GlobalSequence/iosefka/_documentation/docs/assets/cb_2_sockets.webp

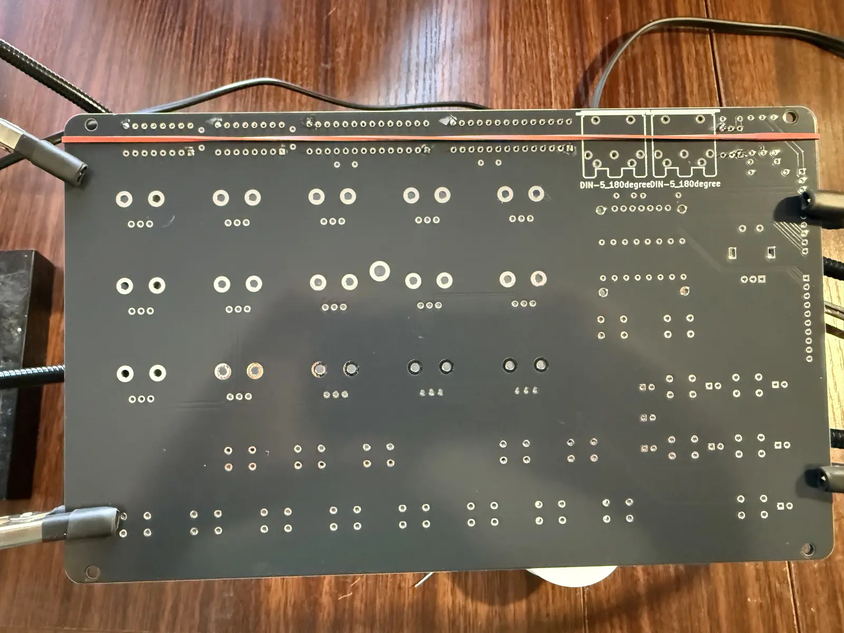
_documentation/docs/assets/cb_2_sockets.webp
