GlobalSequence/iosefka/_documentation/docs/assets/cb_12_chipped.webp

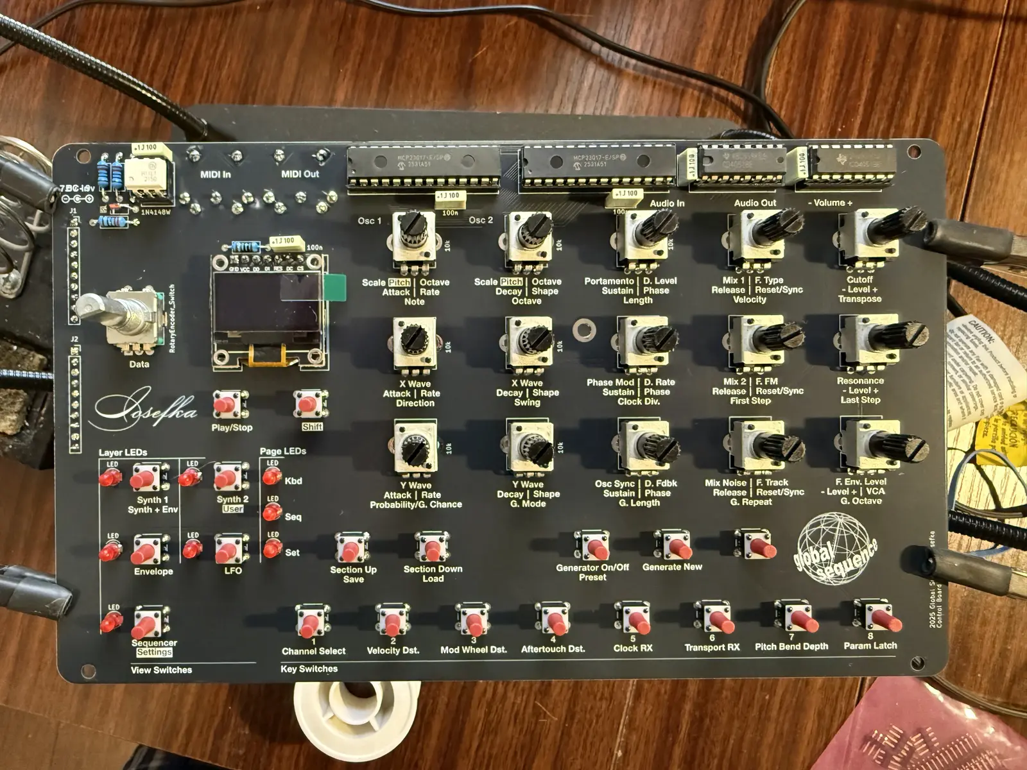
_documentation/docs/assets/cb_12_chipped.webp
