GlobalSequence/iosefka/_documentation/docs/assets/IMG_2130.webp

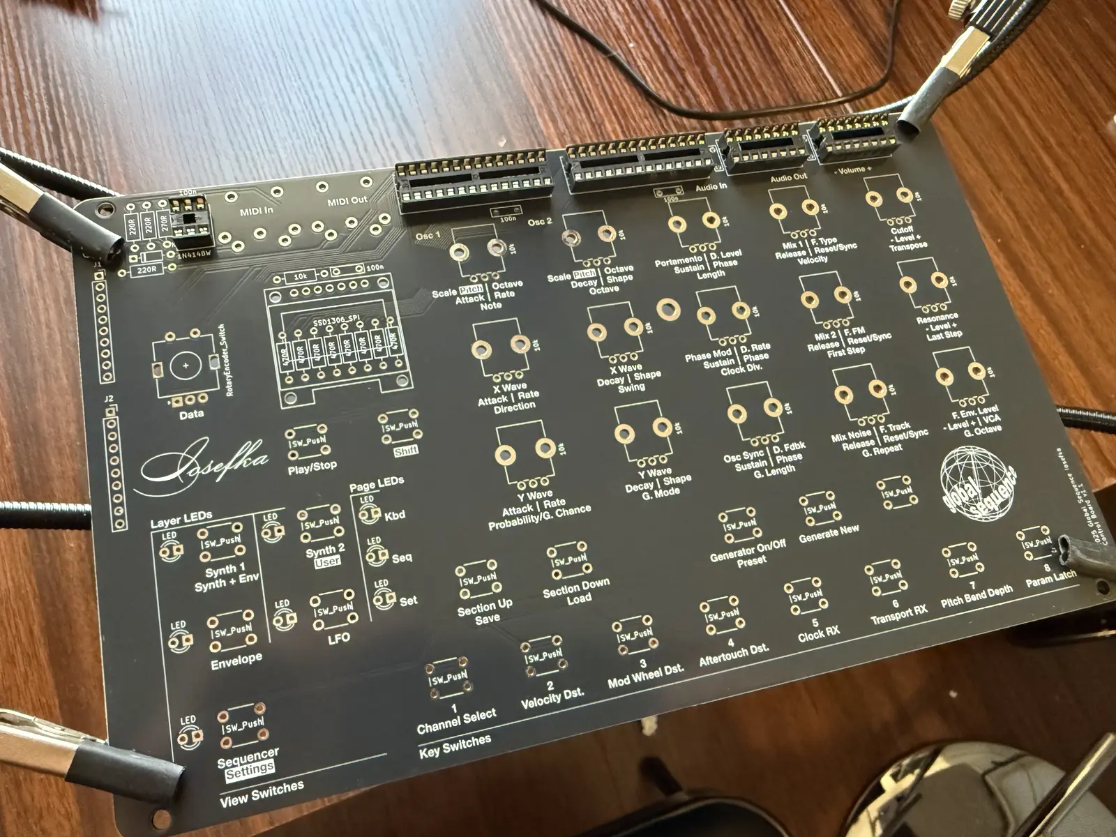
_documentation/docs/assets/IMG_2130.webp
