GlobalSequence/iosefka/_documentation/docs/assets/IMG_2135.webp

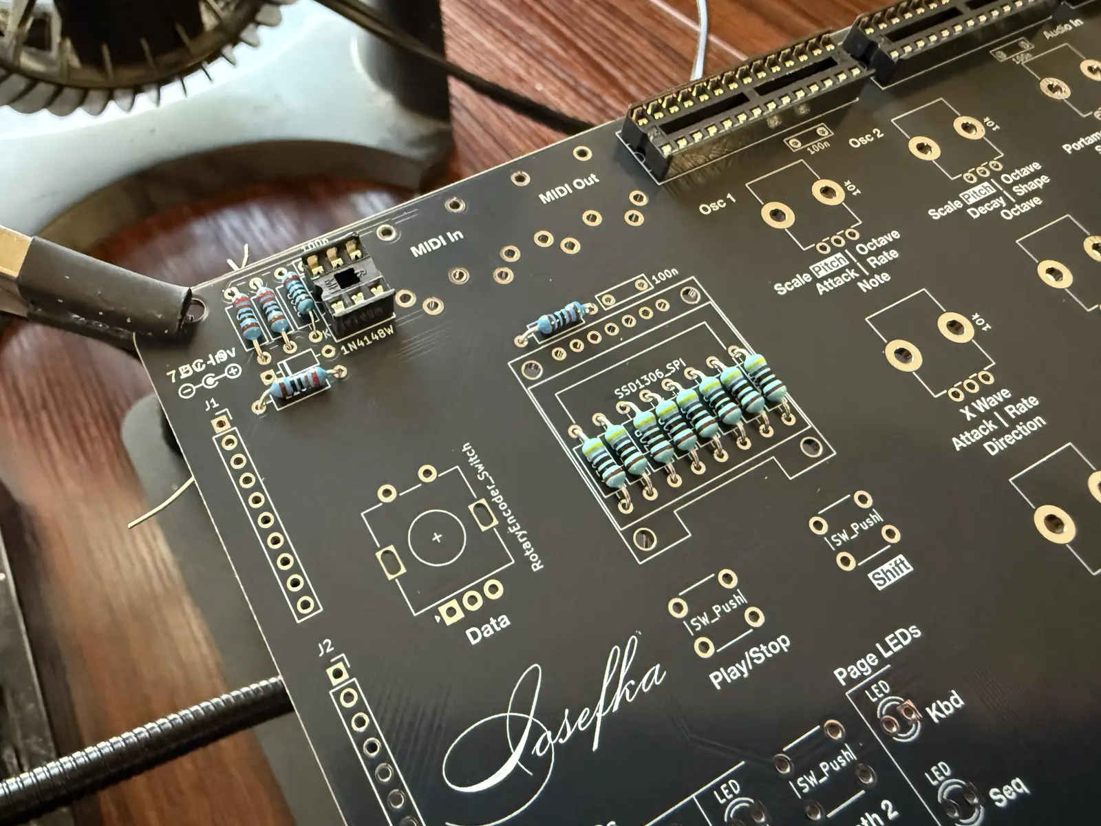
_documentation/docs/assets/IMG_2135.webp
