GlobalSequence/iosefka/_documentation/docs/assets/IMG_2136.webp

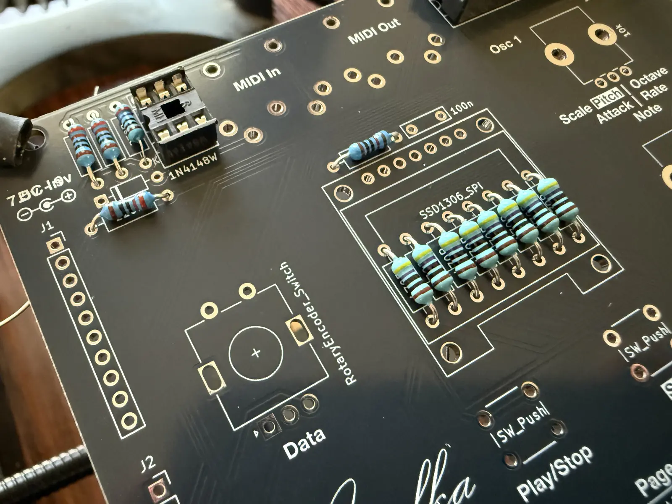
_documentation/docs/assets/IMG_2136.webp
