GlobalSequence/iosefka/_documentation/docs/assets/IMG_2137.webp

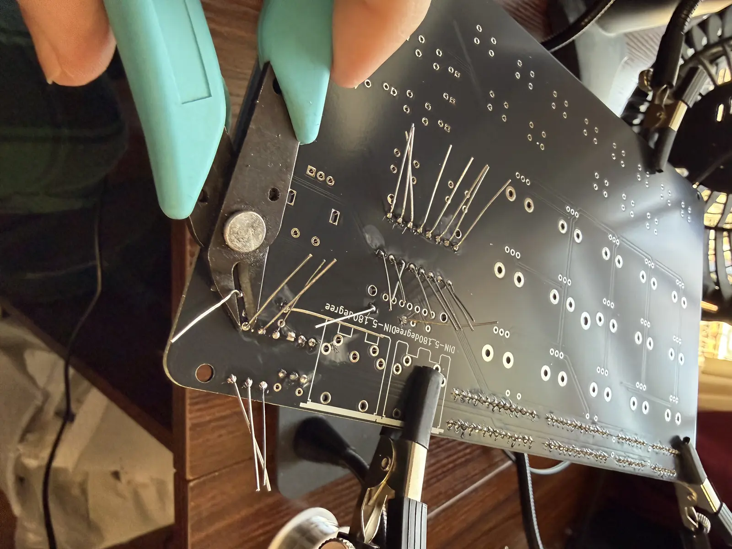
_documentation/docs/assets/IMG_2137.webp
