GlobalSequence/iosefka/_documentation/docs/assets/IMG_2138.webp

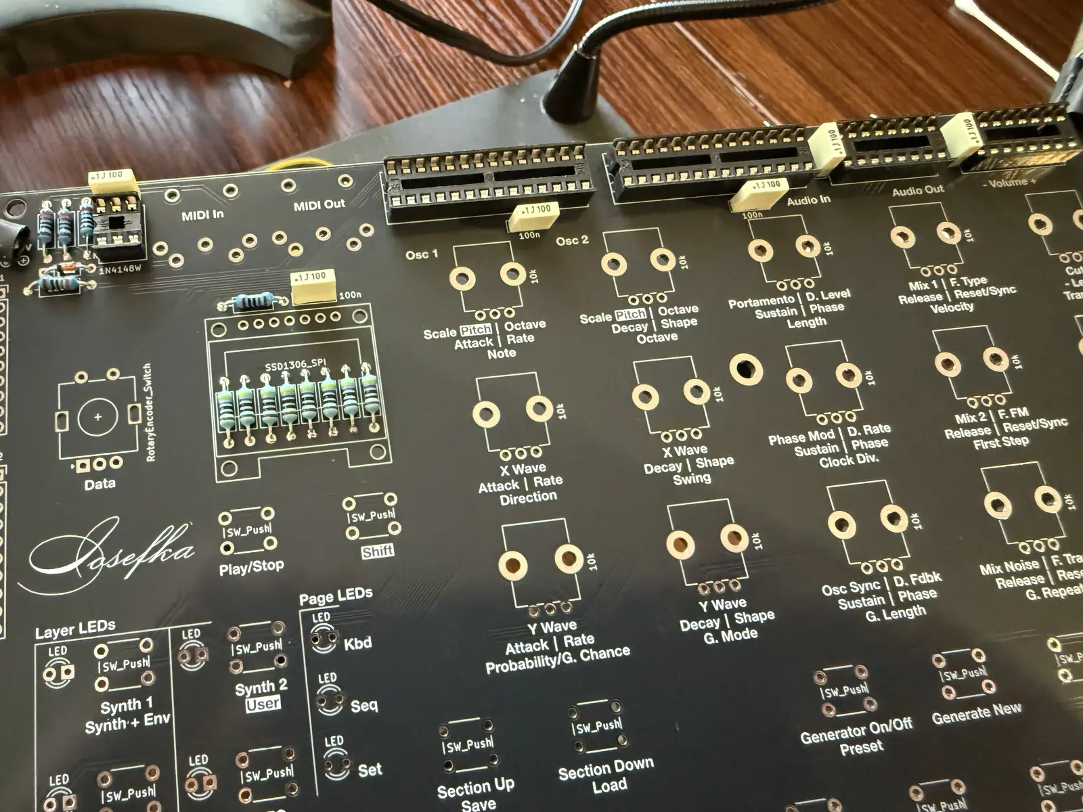
_documentation/docs/assets/IMG_2138.webp
