GlobalSequence/iosefka/_documentation/docs/assets/IMG_2141.webp

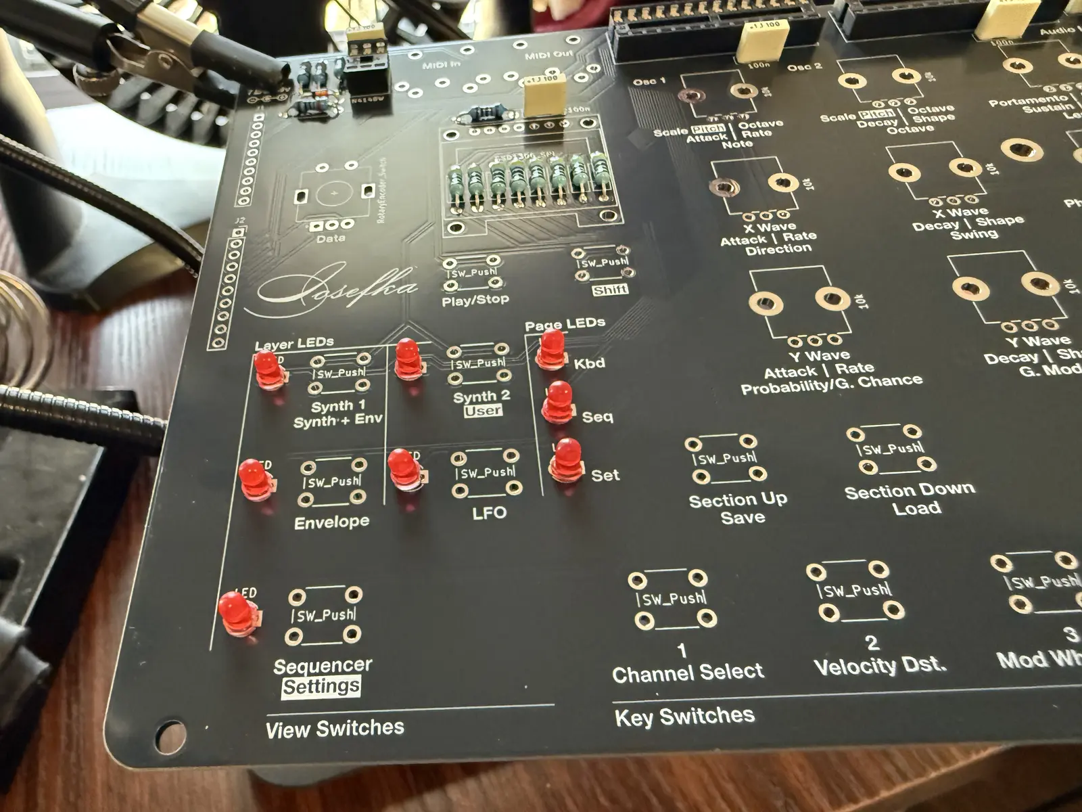
_documentation/docs/assets/IMG_2141.webp
