GlobalSequence/iosefka/_documentation/docs/assets/IMG_2142.webp

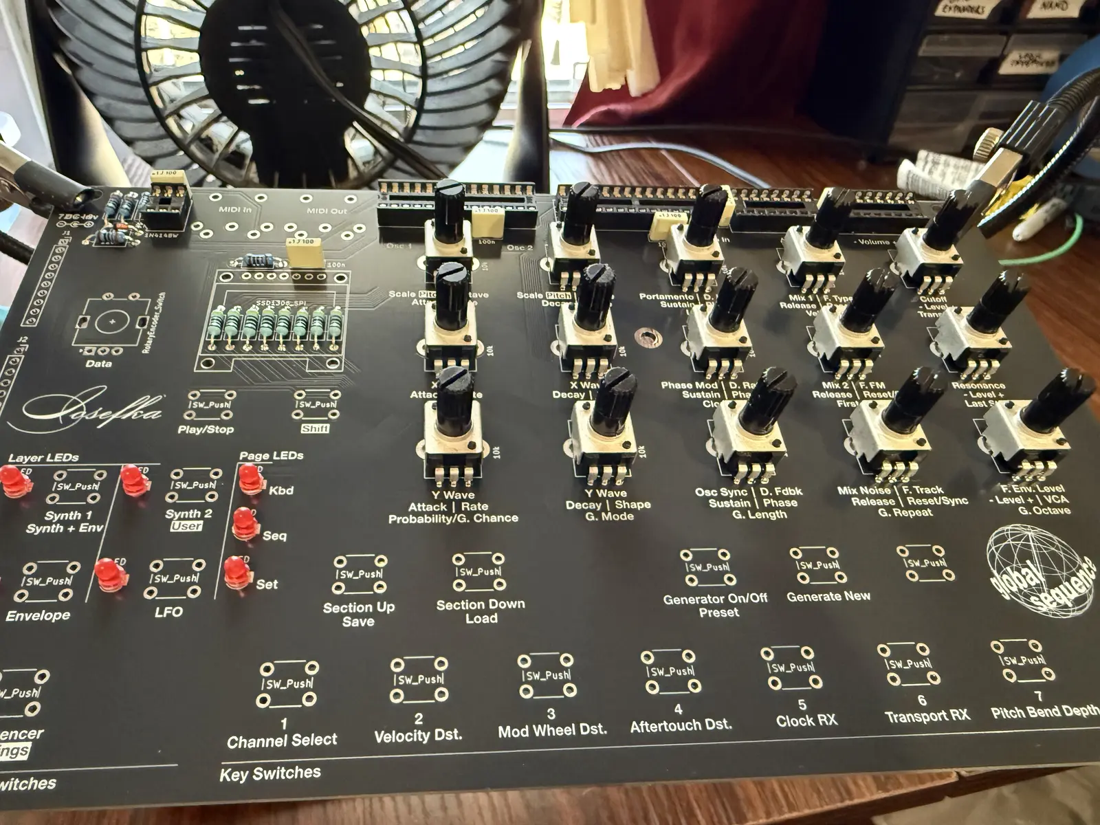
_documentation/docs/assets/IMG_2142.webp
