GlobalSequence/iosefka/_documentation/docs/assets/IMG_2143.webp

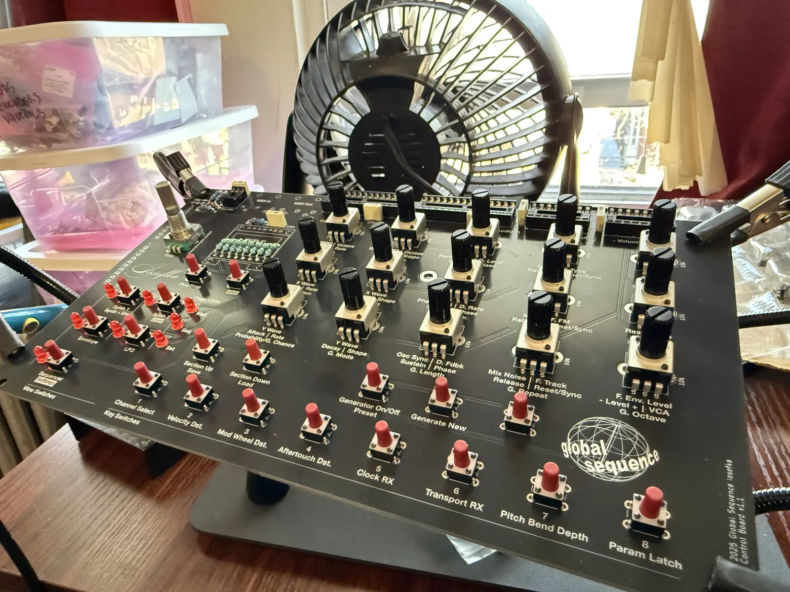
_documentation/docs/assets/IMG_2143.webp
