GlobalSequence/iosefka/_documentation/docs/assets/IMG_2144.webp

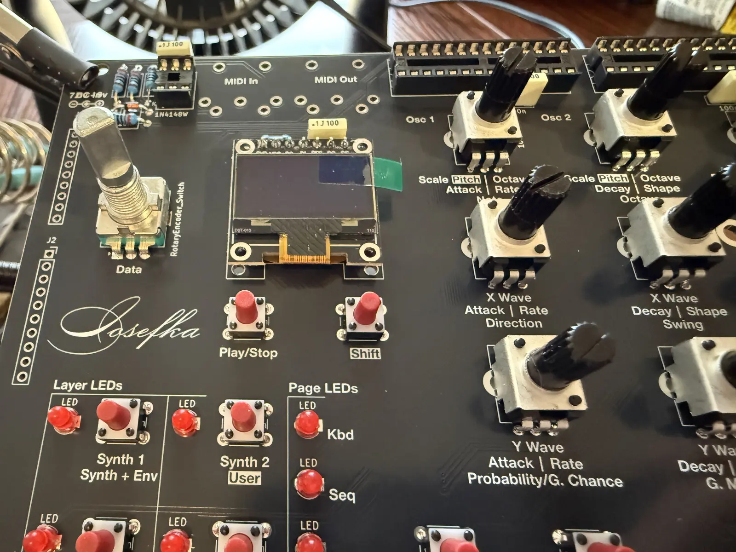
_documentation/docs/assets/IMG_2144.webp
