GlobalSequence/iosefka/_documentation/docs/assets/IMG_2145.webp

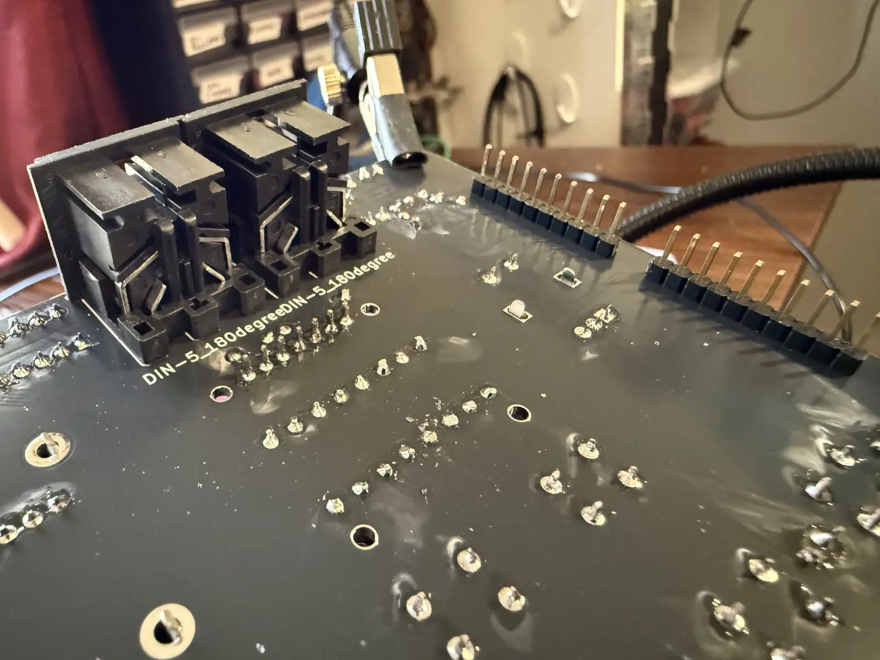
_documentation/docs/assets/IMG_2145.webp
