GlobalSequence/iosefka/_documentation/docs/assets/IMG_2146.webp

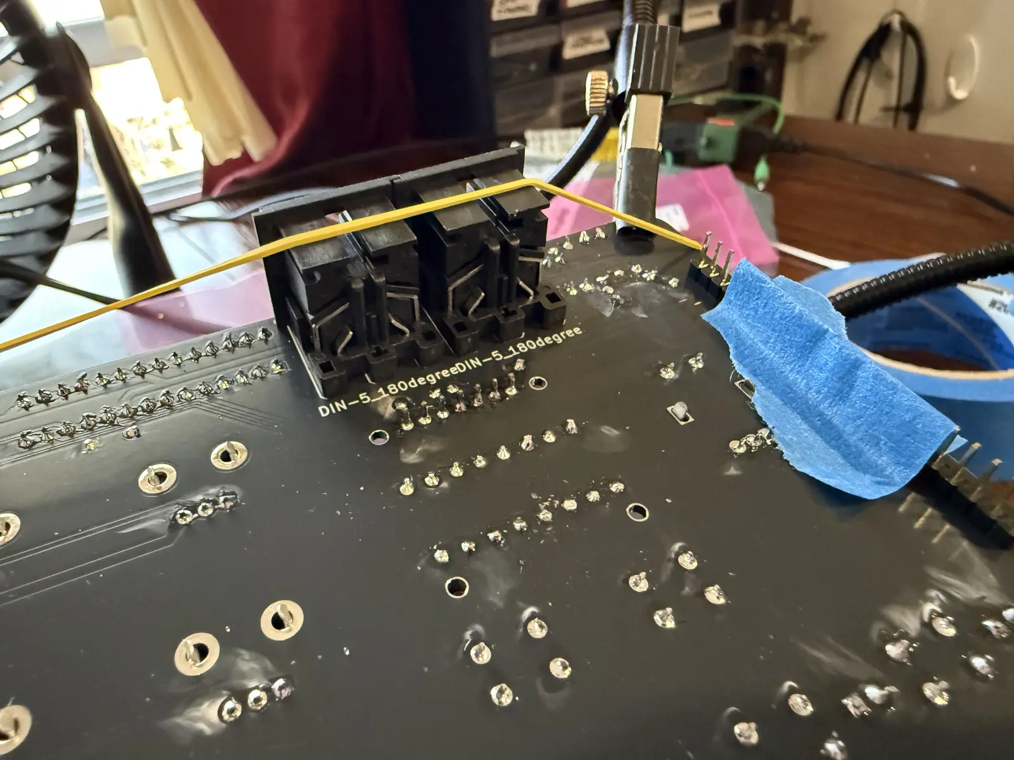
_documentation/docs/assets/IMG_2146.webp
