GlobalSequence/iosefka/_documentation/docs/assets/IMG_2147.webp

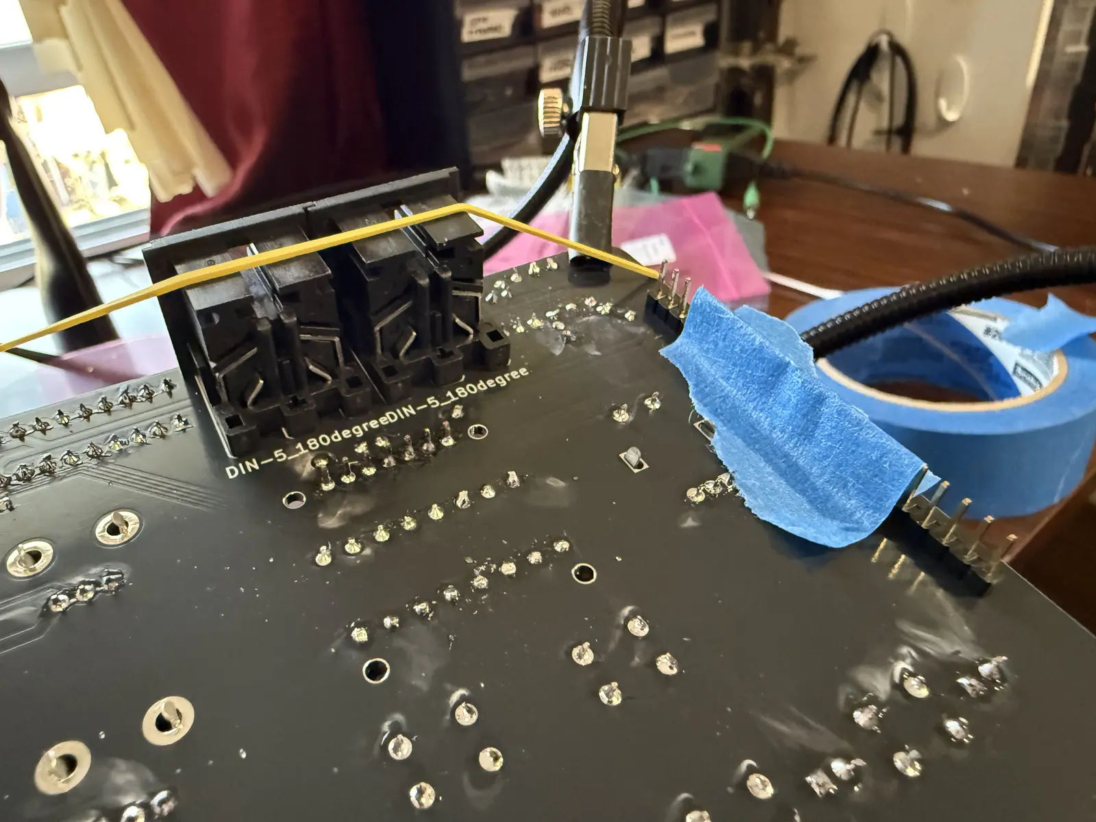
_documentation/docs/assets/IMG_2147.webp
