GlobalSequence/iosefka/_documentation/docs/assets/IMG_2150.webp

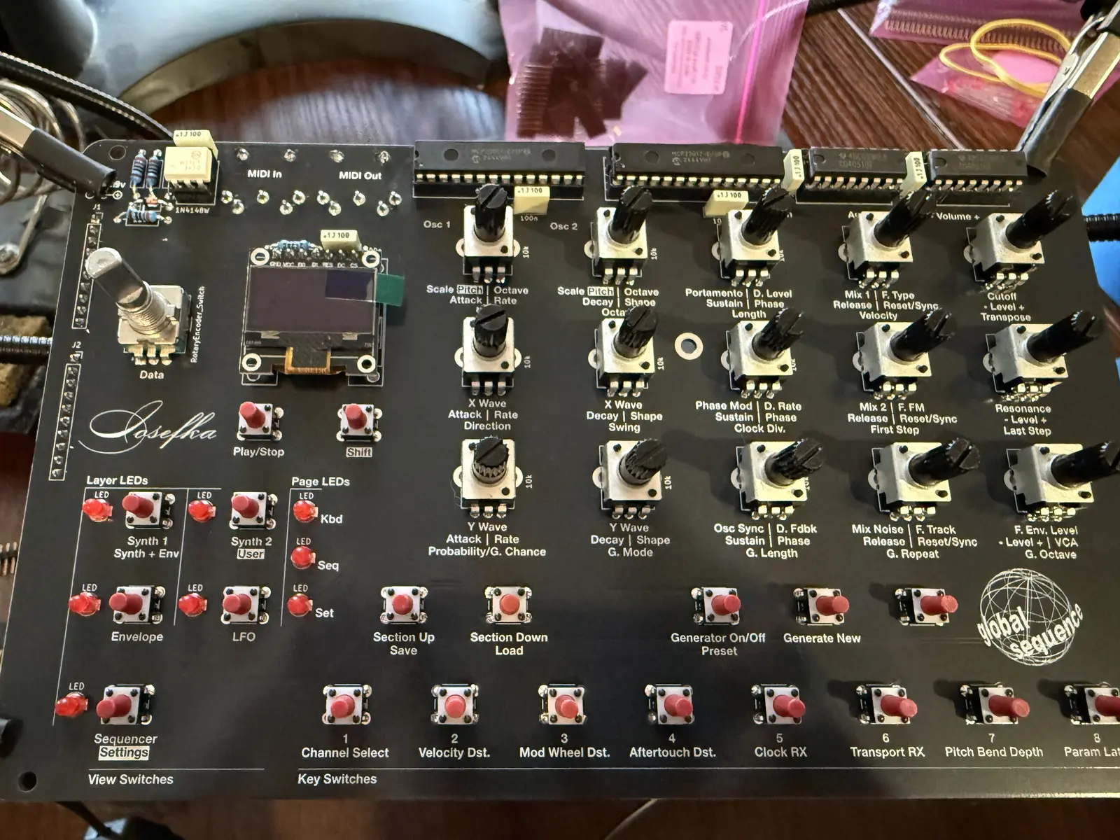
_documentation/docs/assets/IMG_2150.webp
