GlobalSequence/iosefka/_documentation/docs/assets/IMG_2151.webp

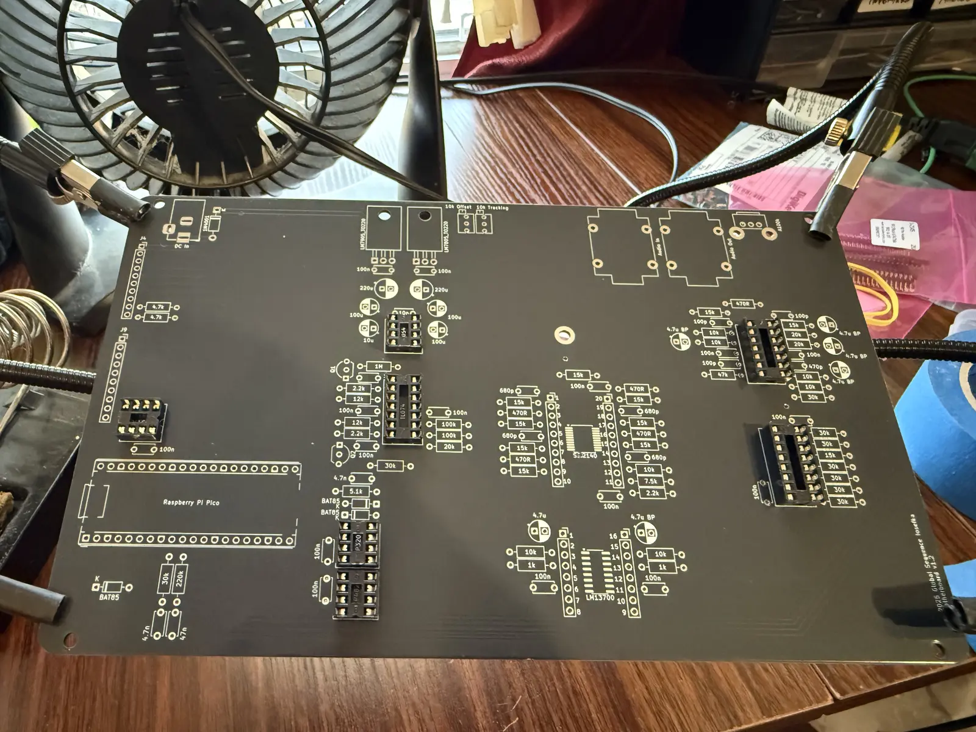
_documentation/docs/assets/IMG_2151.webp
