GlobalSequence/iosefka/_documentation/docs/assets/IMG_2152.webp

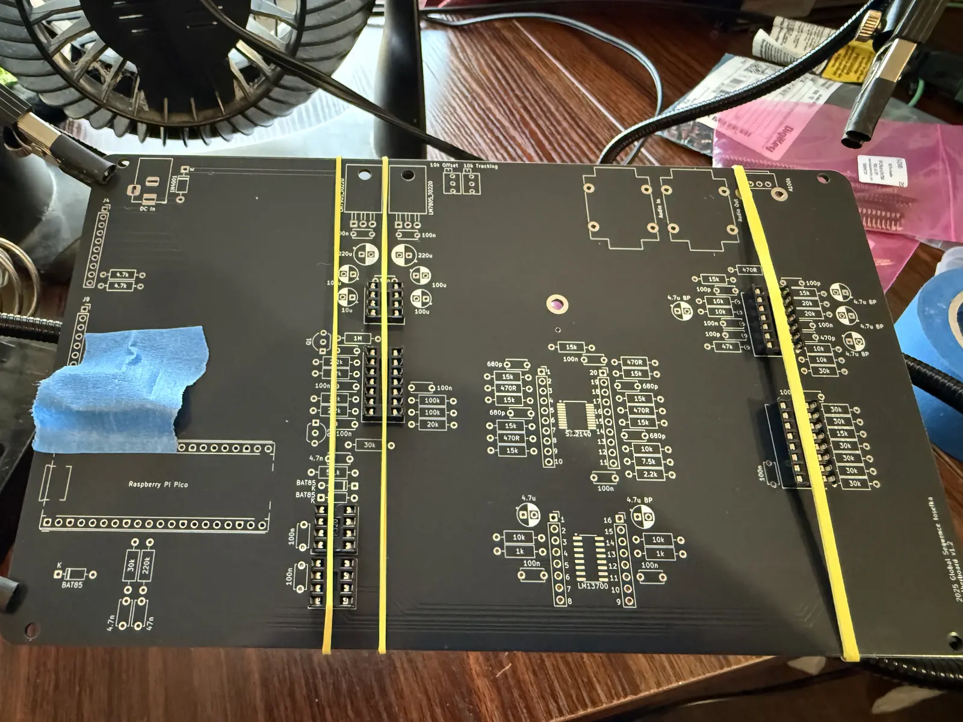
_documentation/docs/assets/IMG_2152.webp
