GlobalSequence/iosefka/_documentation/docs/assets/IMG_2153.webp

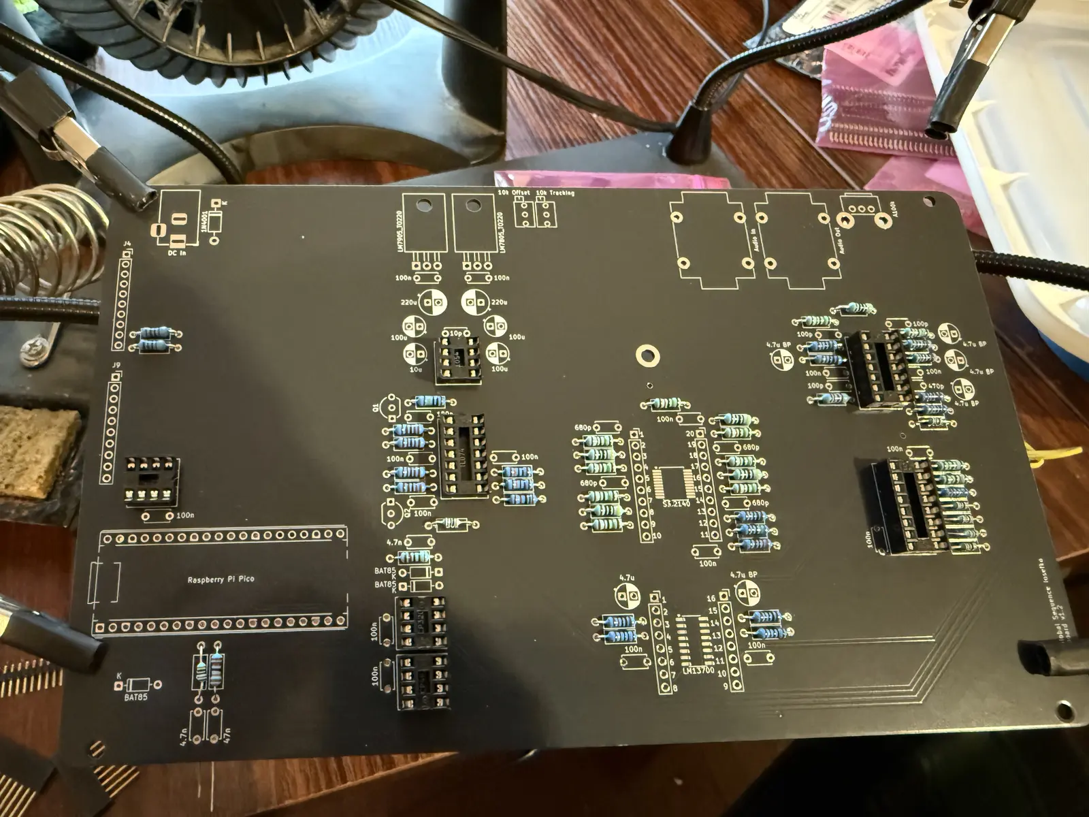
_documentation/docs/assets/IMG_2153.webp
