GlobalSequence/iosefka/_documentation/docs/assets/IMG_2154.webp

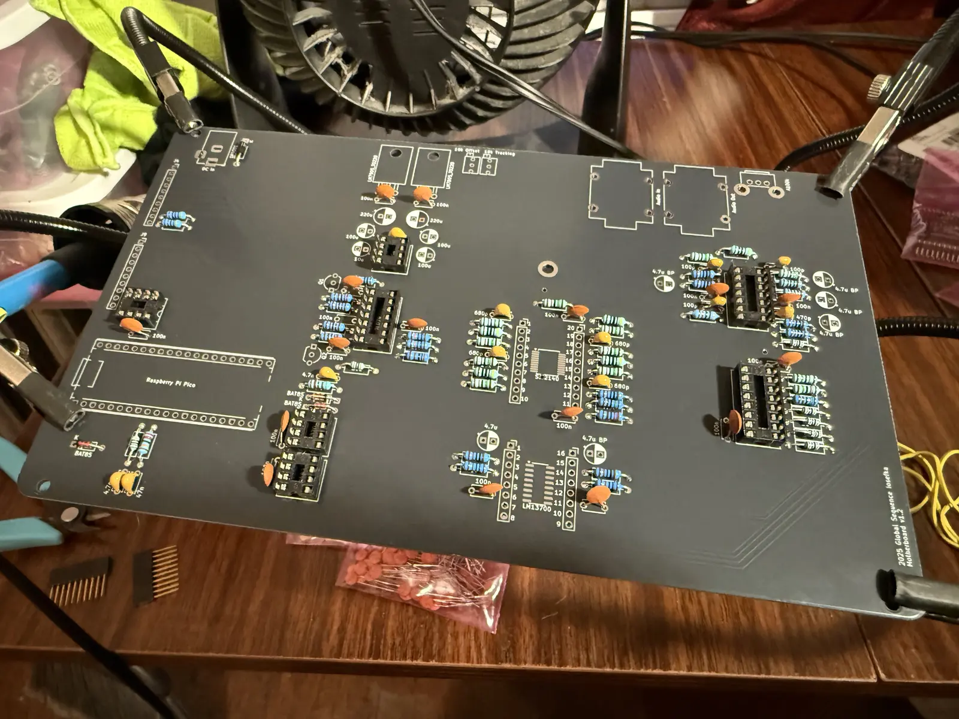
_documentation/docs/assets/IMG_2154.webp
