GlobalSequence/iosefka/_documentation/docs/assets/IMG_2155.webp

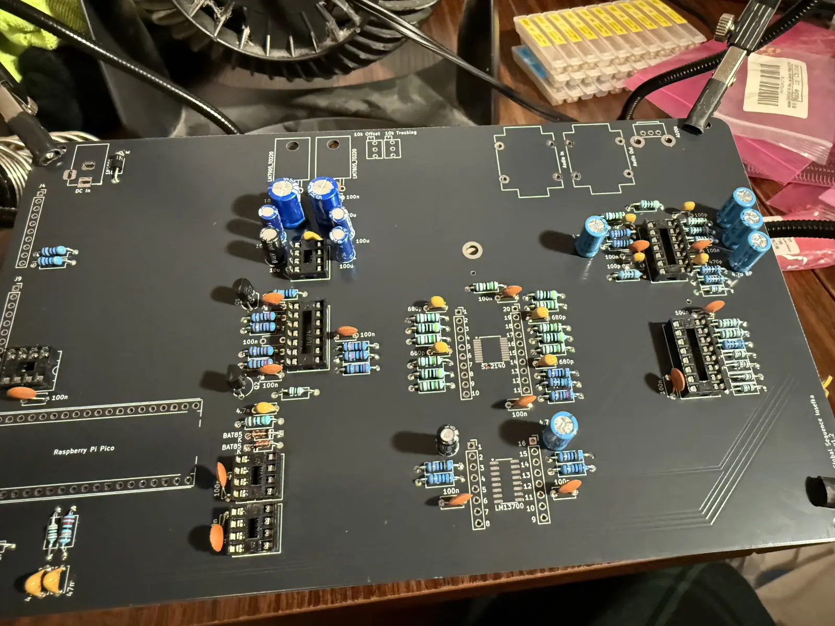
_documentation/docs/assets/IMG_2155.webp
