GlobalSequence/iosefka/_documentation/docs/assets/IMG_2156.webp

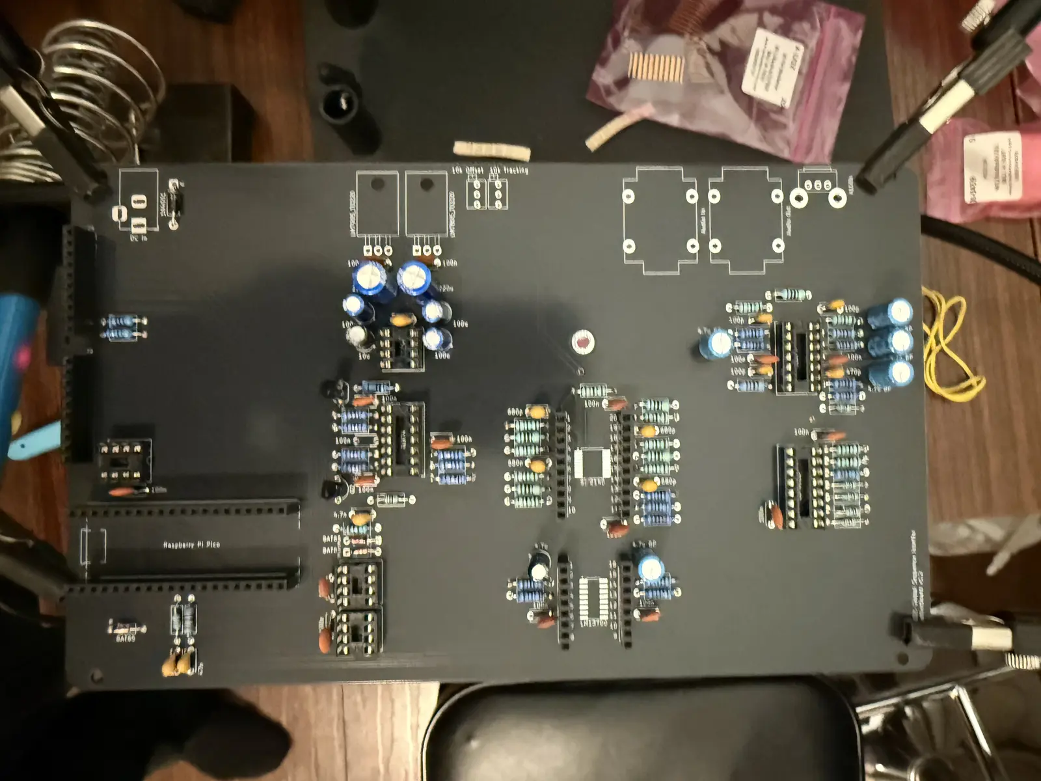
_documentation/docs/assets/IMG_2156.webp
