GlobalSequence/iosefka/_documentation/docs/assets/IMG_2157.webp

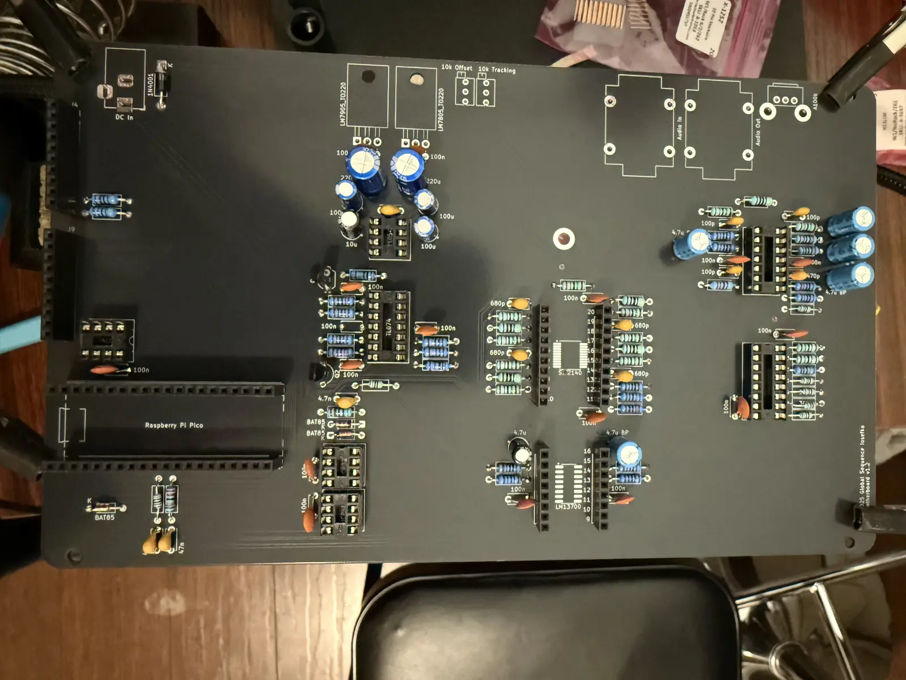
_documentation/docs/assets/IMG_2157.webp
