GlobalSequence/iosefka/_documentation/docs/assets/IMG_2158.webp

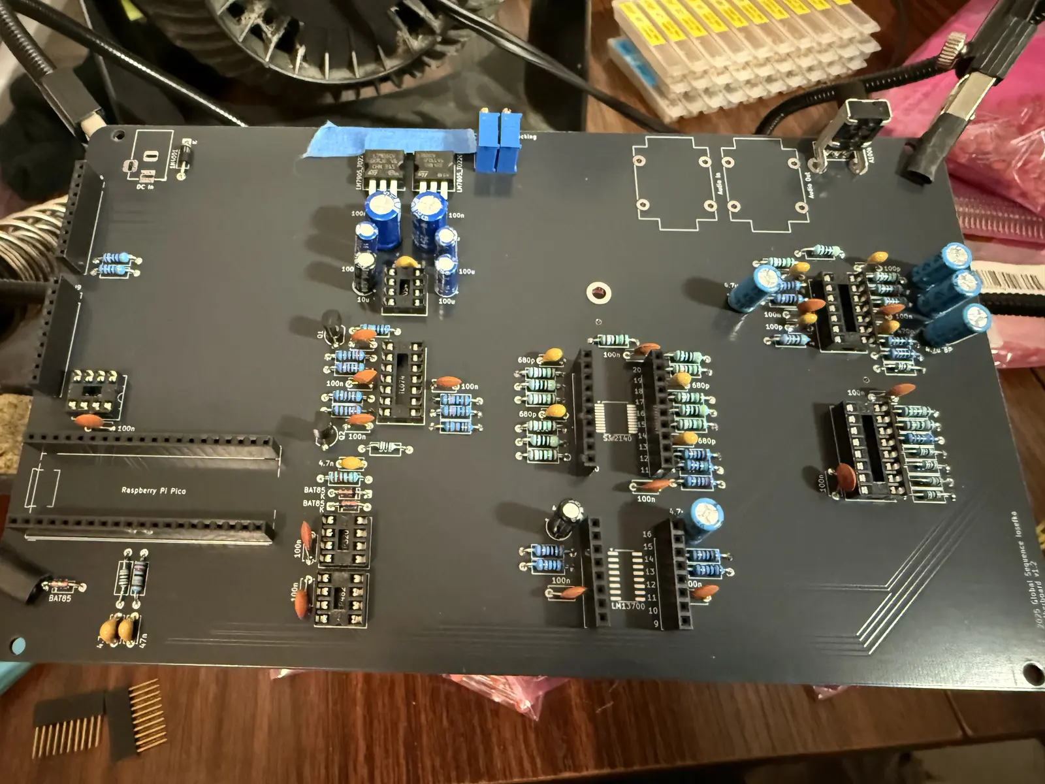
_documentation/docs/assets/IMG_2158.webp
