GlobalSequence/iosefka/_documentation/docs/assets/IMG_2160.webp

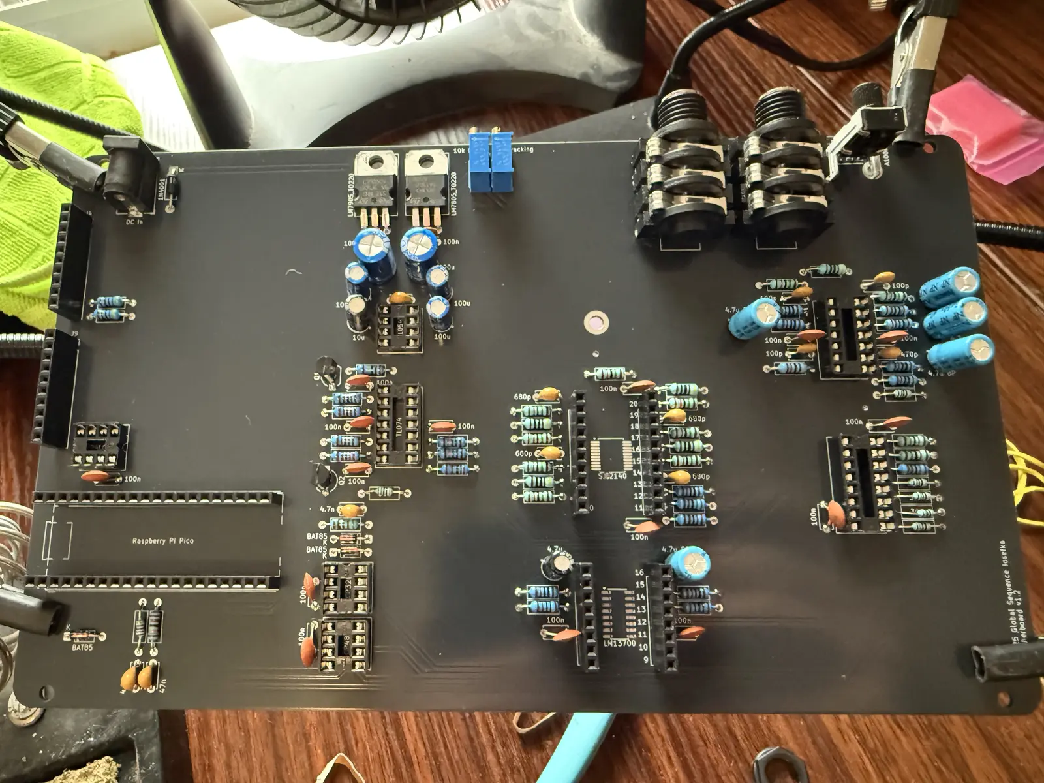
_documentation/docs/assets/IMG_2160.webp
