GlobalSequence/iosefka/_documentation/docs/assets/IMG_2161.webp

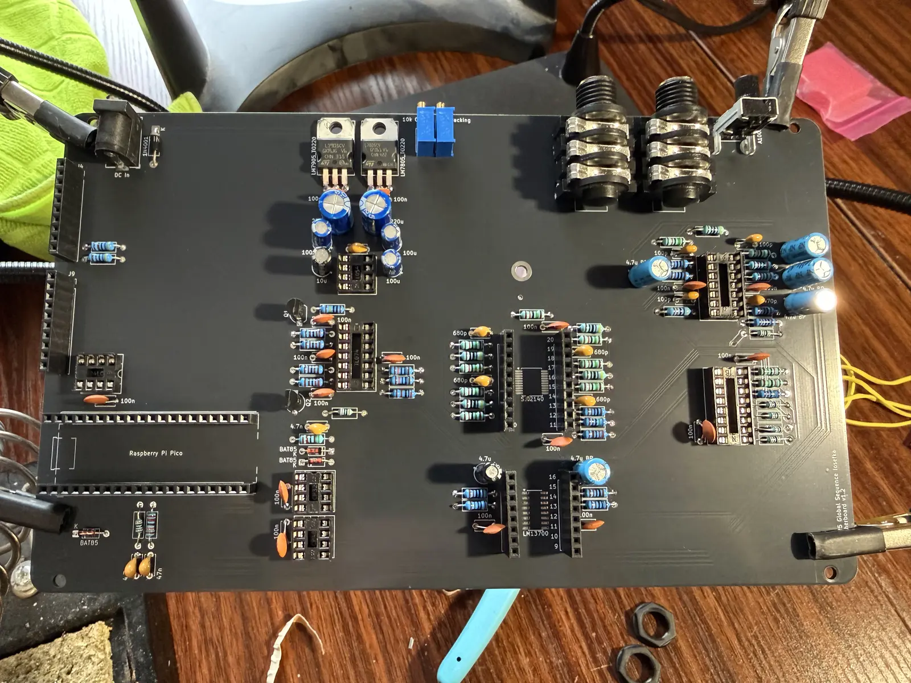
_documentation/docs/assets/IMG_2161.webp
