GlobalSequence/iosefka/_documentation/docs/assets/IMG_2162.webp

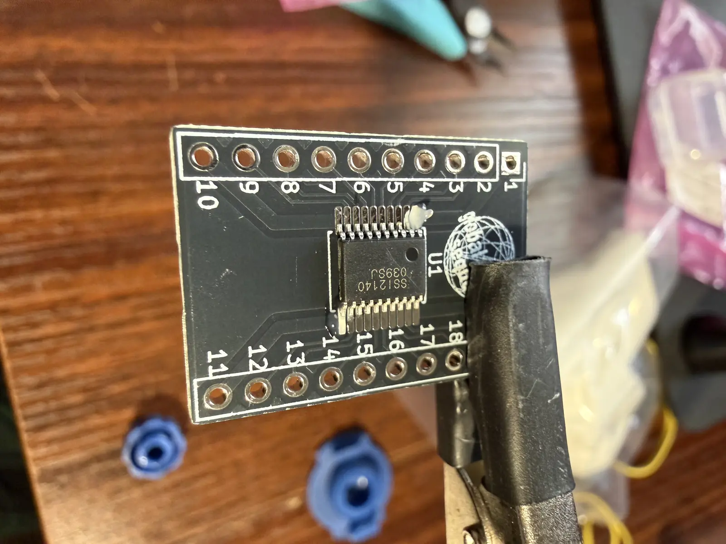
_documentation/docs/assets/IMG_2162.webp
