GlobalSequence/iosefka/_documentation/docs/assets/IMG_2163.webp

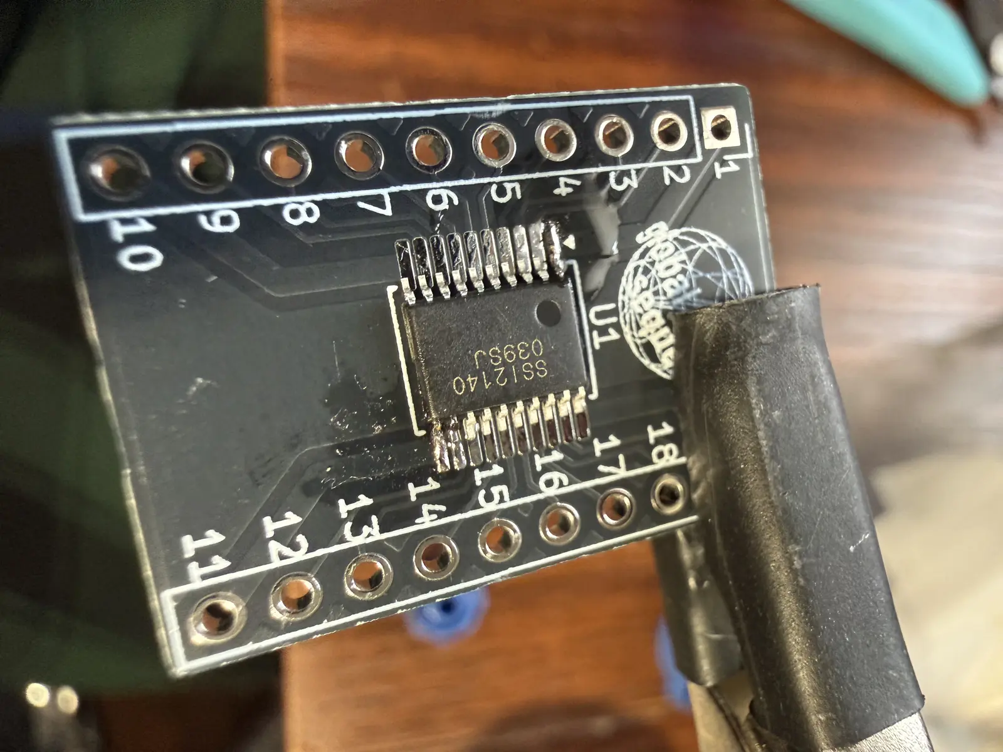
_documentation/docs/assets/IMG_2163.webp
