GlobalSequence/iosefka/_documentation/docs/assets/IMG_2164.webp

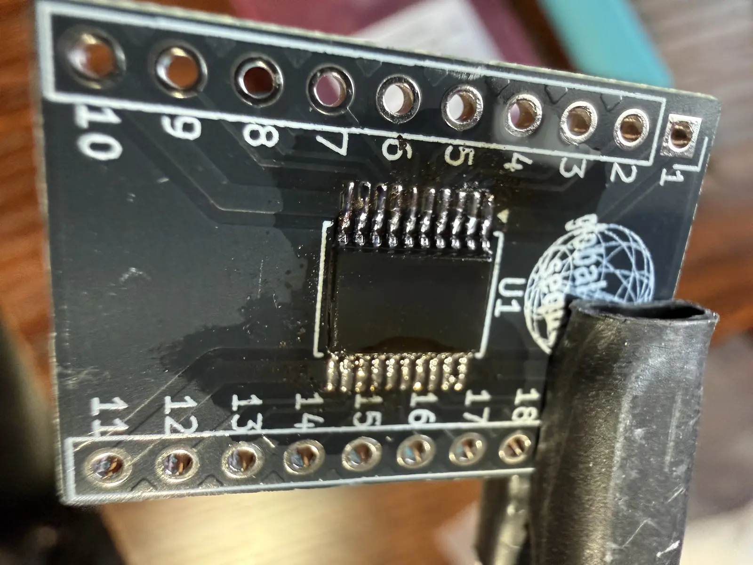
_documentation/docs/assets/IMG_2164.webp
