GlobalSequence/iosefka/_documentation/docs/assets/IMG_2165.webp

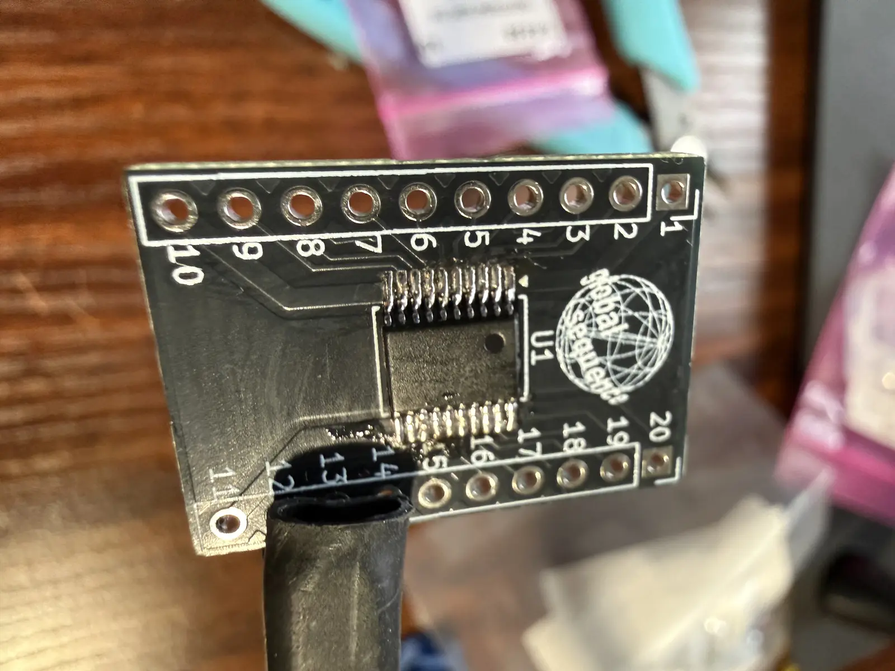
_documentation/docs/assets/IMG_2165.webp
