GlobalSequence/iosefka/_documentation/docs/assets/IMG_2187.webp

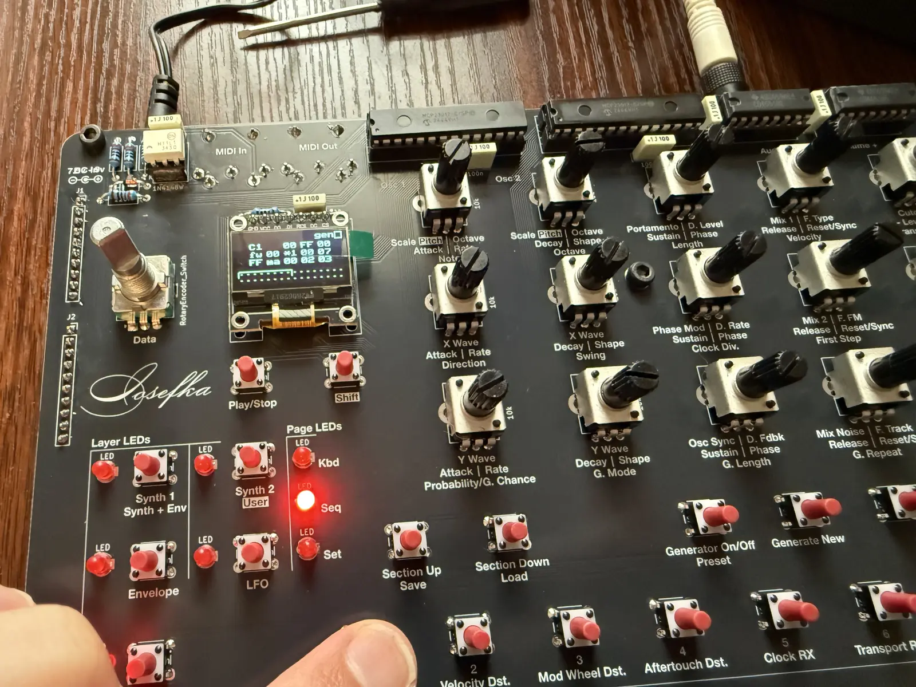
_documentation/docs/assets/IMG_2187.webp
