GlobalSequence/iosefka/_documentation/docs/assets/IMG_2190.webp

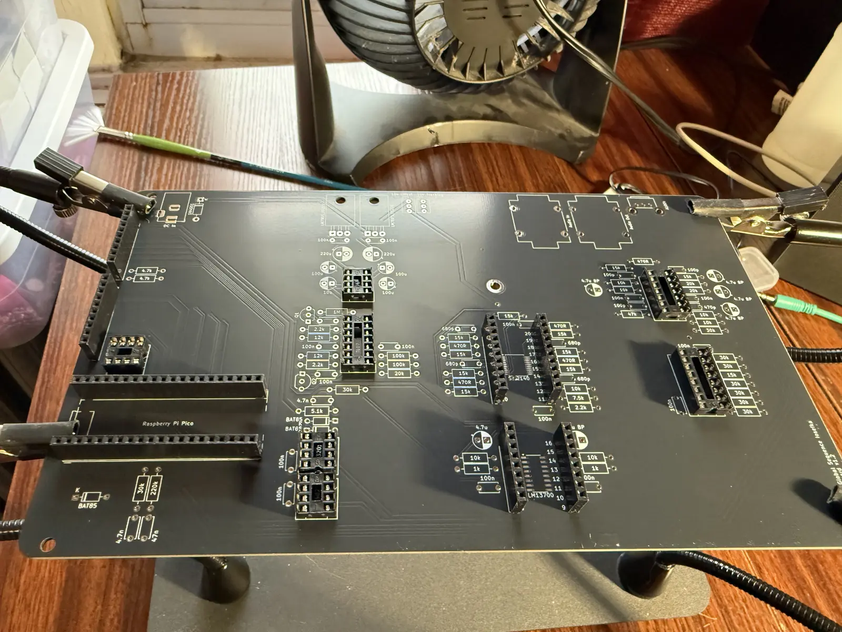
_documentation/docs/assets/IMG_2190.webp
