GlobalSequence/iosefka/_documentation/docs/assets/IMG_2567.webp

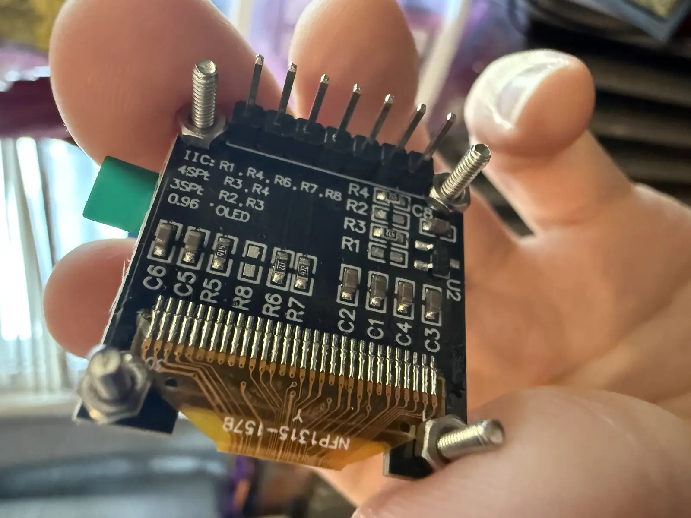
_documentation/docs/assets/IMG_2567.webp
