GlobalSequence/iosefka/_documentation/docs/assets/IMG_2568.webp

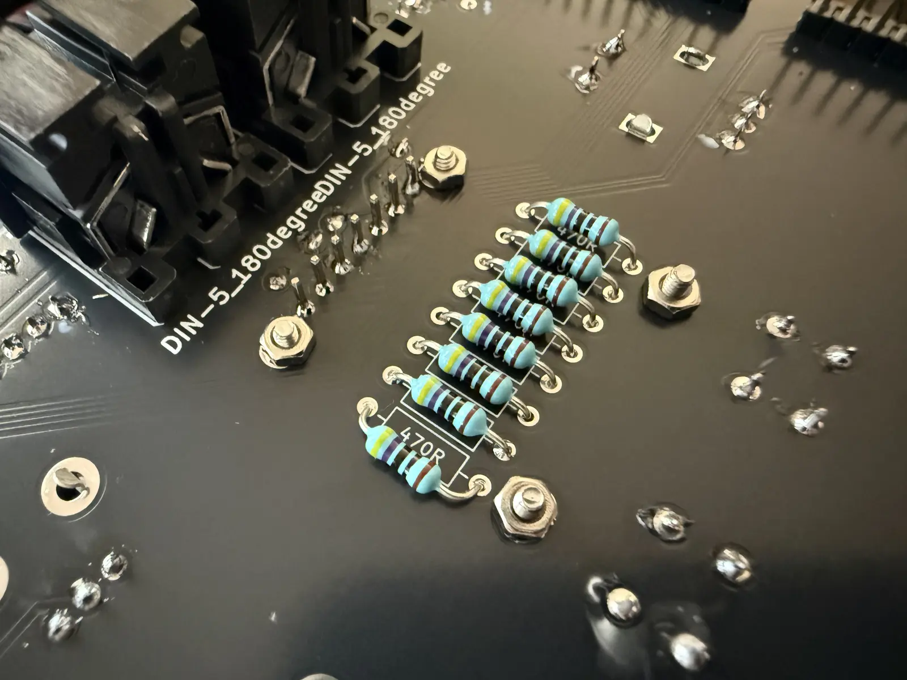
_documentation/docs/assets/IMG_2568.webp
