GlobalSequence/iosefka/hardware/assets/polarity_marking_center_positive.png

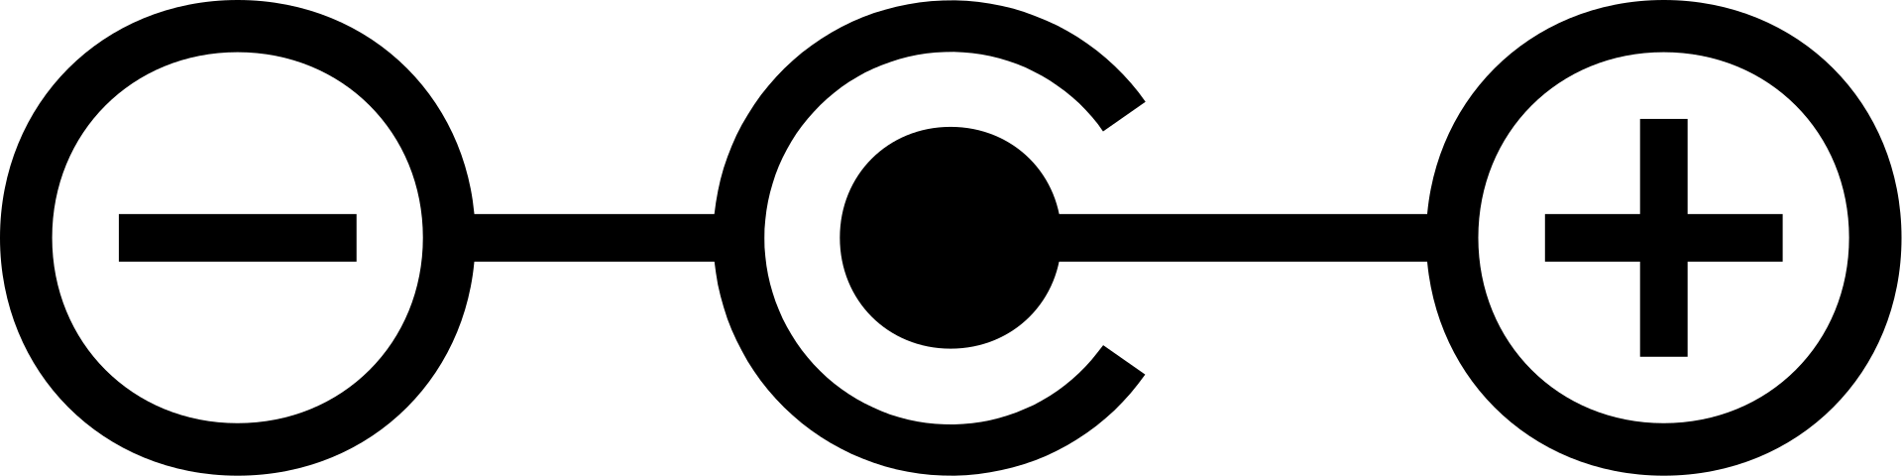
hardware/assets/polarity_marking_center_positive.png
