GlobalSequence/iosefka/_documentation/docs/build_guide.md

# **Build Guide**

This will walk you through the step-by-step process of populating the Iosefka PCB using components from the [Bill of Materials](TODO:ADDBOM), as well as uploading the firmware to the microcontroller. 

*Note: This guide was made using an older version of the PCB. The only differences are a few of the component values (follow values on your PCB and you'll be fine), the omission of the 1M resistor which is now DNP (do not place) on the new PCB, some silk screen labels on the control board, and the addition of the 6th spacer between the Switch Keys.*
## DISCLAIMER
We are not responsible for any accidents that arise during the build process, or in the course of operation. Any safety precautions involved with working with solder, electrical components, and anything else are the responsibility of the builder.

## Tools
**Required**

 - Soldering Iron
 - Solder (leaded or lead free, you do you)
 - Wire cutters
 - Small phillips screwdriver
 - Small flathead screwdriver
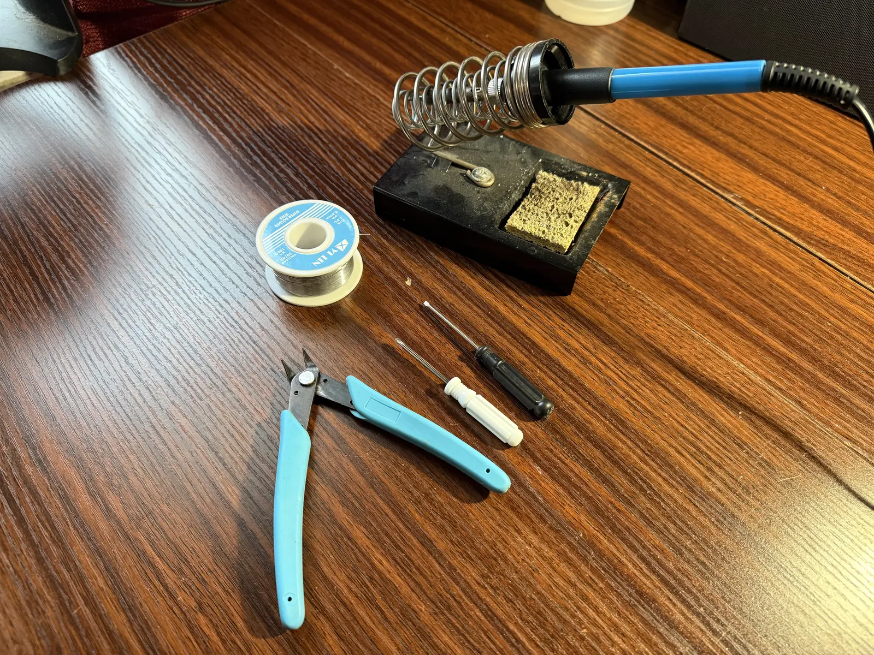
[picture p47: _documentation/docs/assets/IMG_2191.webp]
Tools - Required


**Optional (but recommended)** 

 - "Helping hands" clips for soldering (pictured in two different sizes)
 - Soldering flux paste
 - Electronics tweezers
 - Desoldering wick
 - (not pictured) Painter's tape
 - (not pictured) Rubber bands
 - (not pictured) Rubbing alcohol
 - (not pictured) Q-tips or microfiber rag 
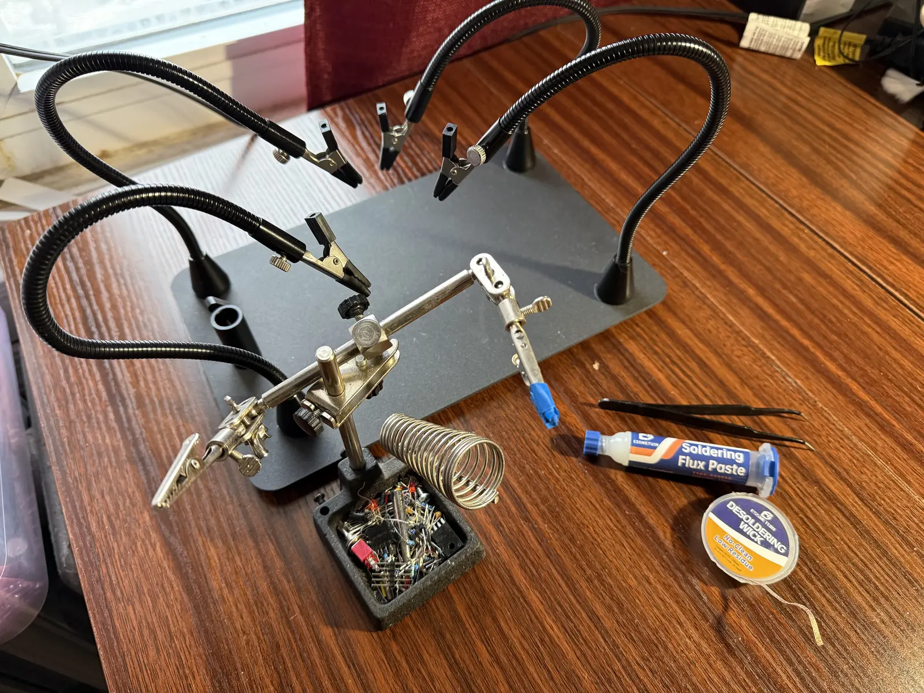
[picture p48: _documentation/docs/assets/IMG_2192.webp]
Tools - Optional


## Step 0: Flashing the Raspberry Pi Pico

Flashing the firmware to the Raspberry Pi Pico is easy.

 - Download the iosefka.uf2 firmware file from here: 
	 - https://github.com/GlobalSequence/iosefka/releases
 - Plug a micro USB cable into the Raspberry Pi Pico
 - Press the BOOTSEL switch on the Pico
 - With the BOOTSEL switch held down, plug the USB cable into the computer
 - The Raspberry Pi Pico will appear as a drive on your computer
 - Drag and drop the iosefka.uf2 file directly into the drive

## Control Board
First, populate the IC sockets. Some people put the sockets on later, but I prefer to put them on first when no other components are in the way. Up to you!

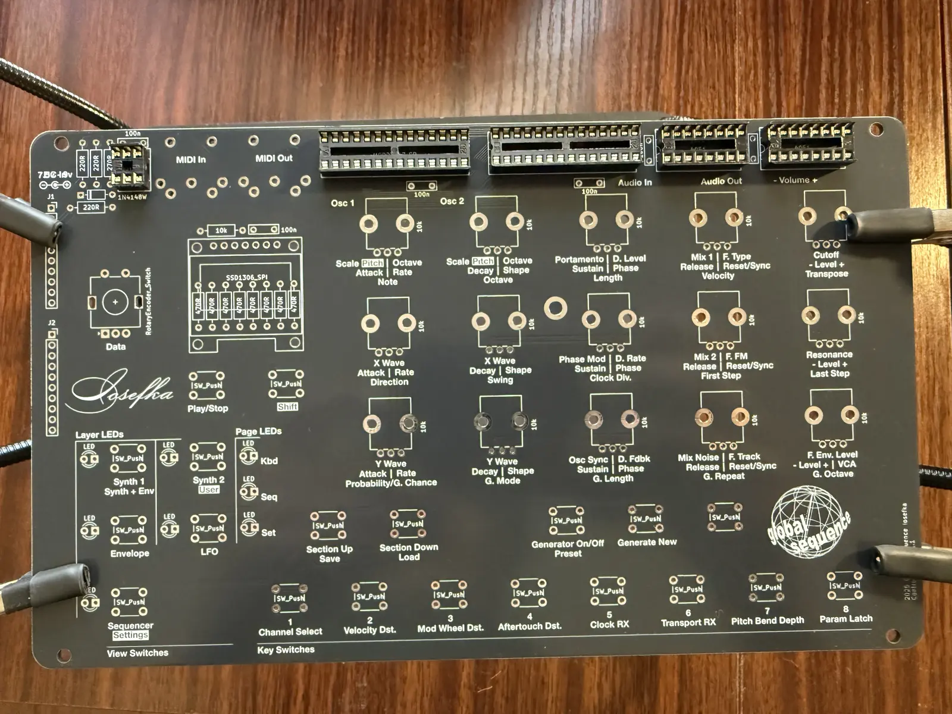
[picture p49: _documentation/docs/assets/cb_1_sockets.webp]
cb_1_sockets


**Important!** Make sure that the scallop in the socket lines up with the crescent shape on the PCB silkscreen. 

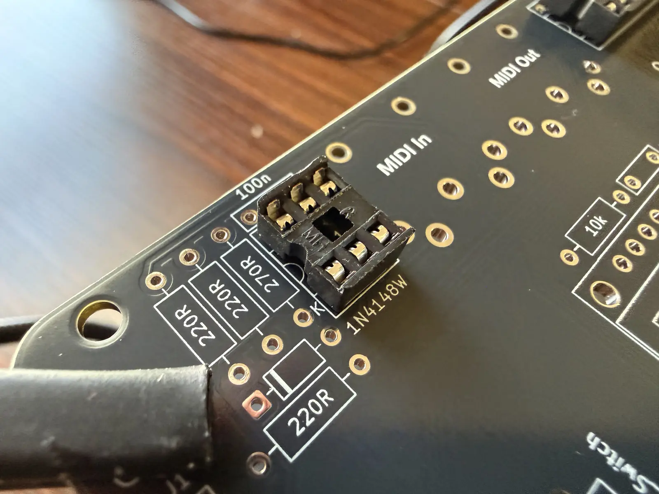
[picture p50: _documentation/docs/assets/IMG_2131.webp]
Control Board - IC direction


You can run a rubber band along the IC sockets to hold them in place when soldering them in upside down. Painters tape also works well.

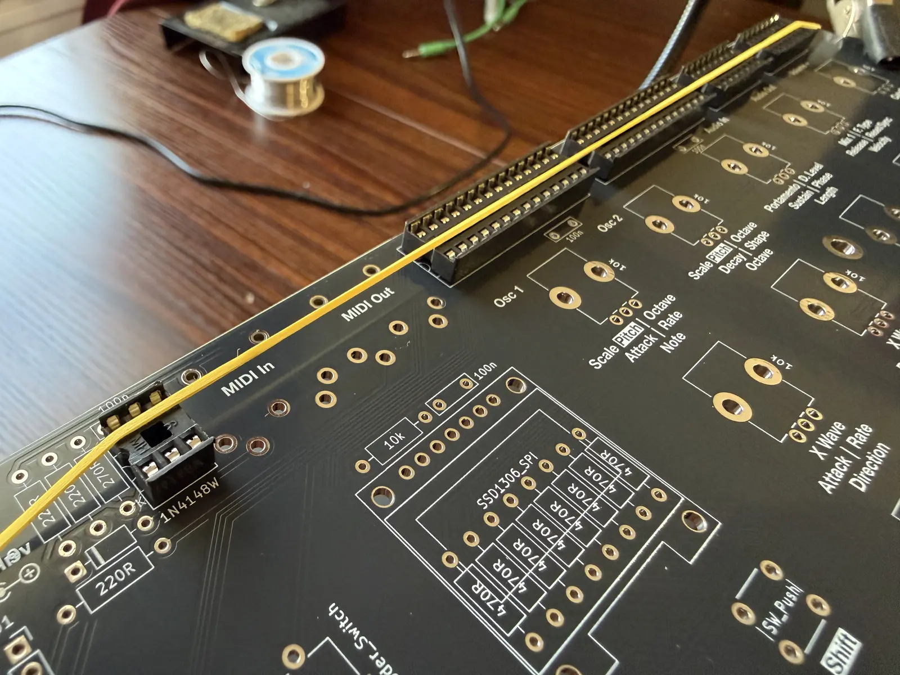
[picture p51: _documentation/docs/assets/IMG_2132.webp]
Control Board - Rubber Band Top


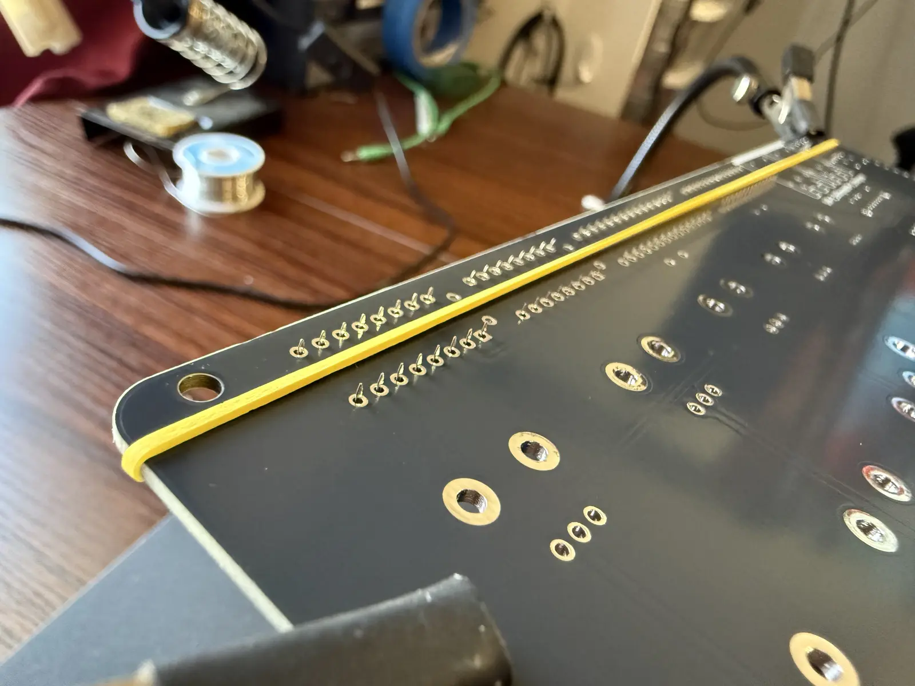
[picture p52: _documentation/docs/assets/IMG_2134.webp]
Control Board - Rubber Band Bottom


Note on LED Direction: The long leg of the LED is the anode (+) which goes into the round hole, the short leg is the cathode (-) which goes into the square hole. 

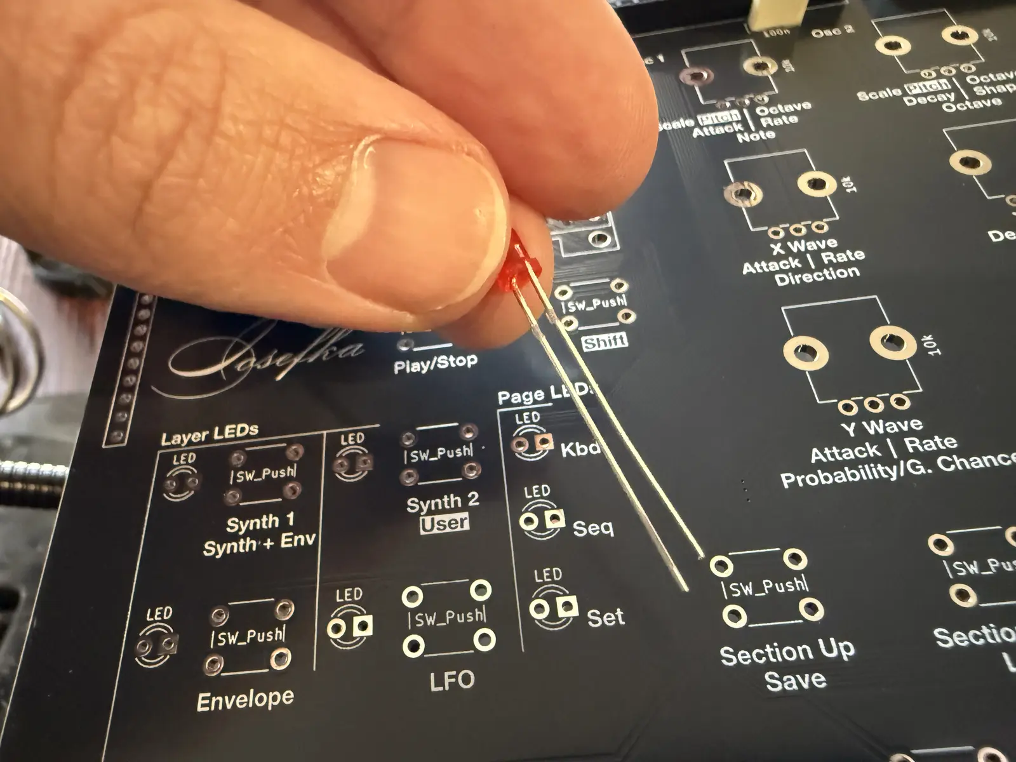
[picture p53: _documentation/docs/assets/IMG_2139.webp]
Control Board - LED Direction


Kinda hard to tell, but the cathode side of the LED is flat, which helps to make sure that you put it in the correct way.

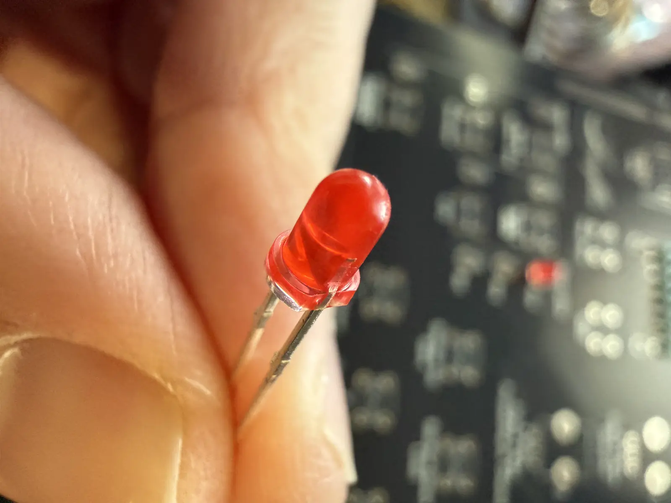
[picture p54: _documentation/docs/assets/IMG_2140.webp]
Control Board - LED Flat side


Place the diodes (this includes the LEDs).

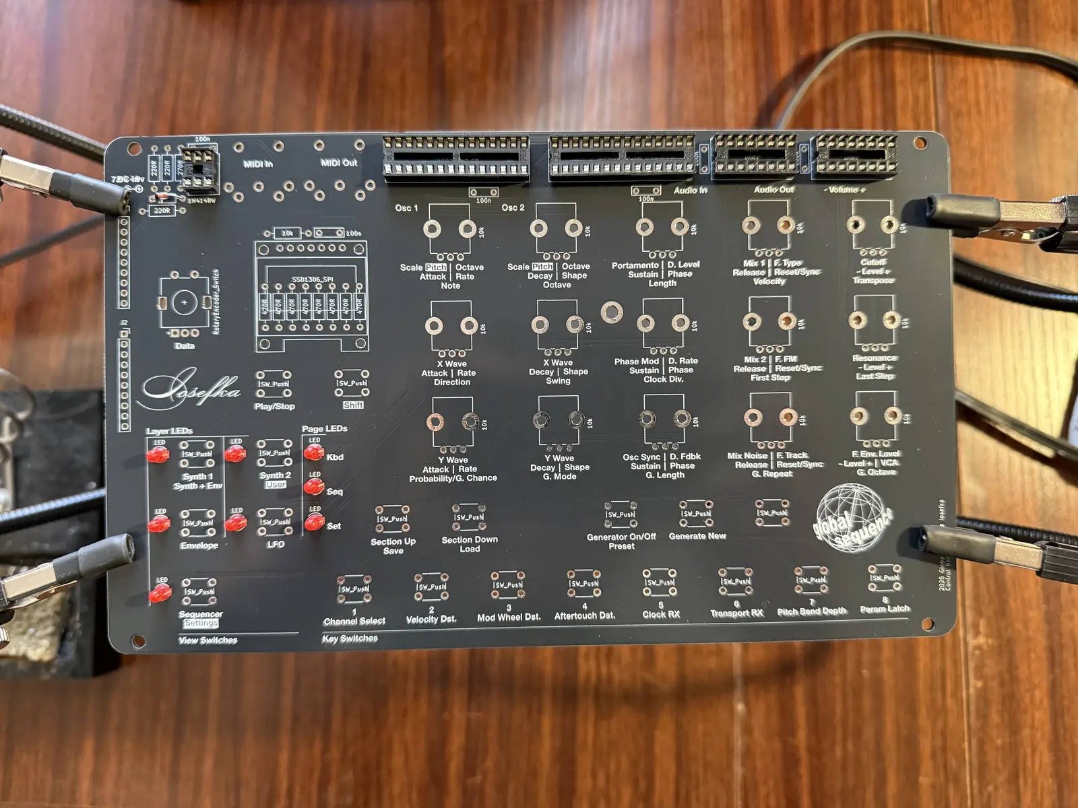
[picture p55: _documentation/docs/assets/cb_3_diodes.webp]
cb_3_diodes


Place the resistors. 

**IMPORTANT!** Don't place the 470 Ohm resistors that go under the OLED on the top side of the board! Those go underneath.

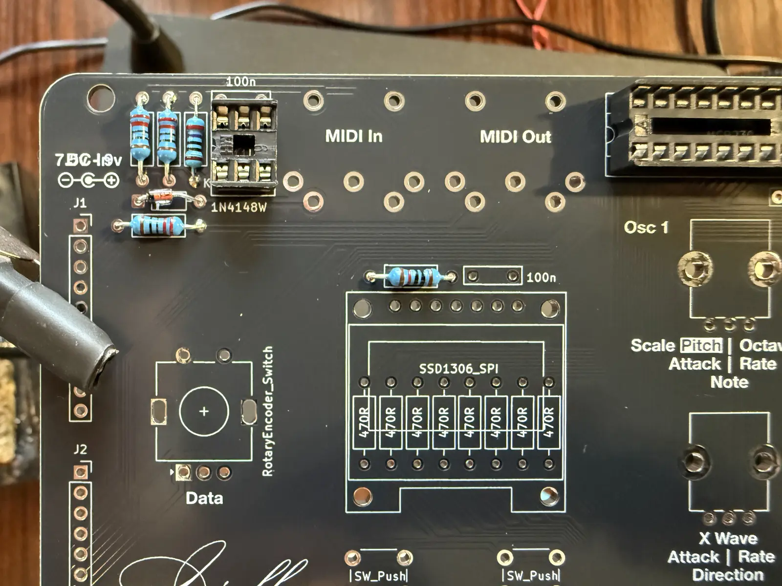
[picture p56: _documentation/docs/assets/cb_4_resistors.webp]
cb_4_resistors


Place the capacitors.

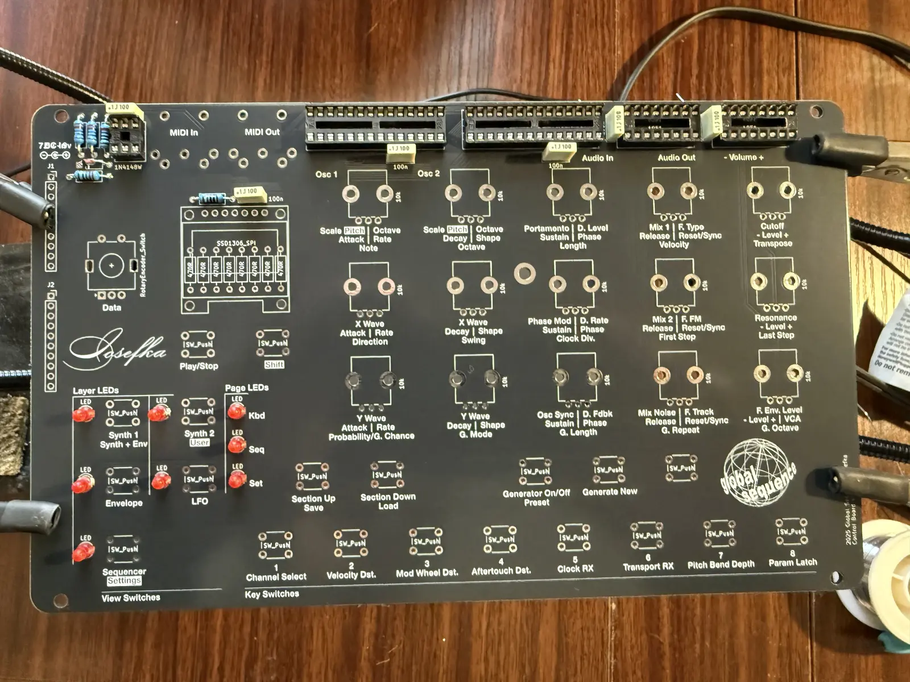
[picture p57: _documentation/docs/assets/cb_5_caps.webp]
cb_5_caps


Place the switches. Press them down so they're flush with the PCB before soldering. Also place the encoder. 

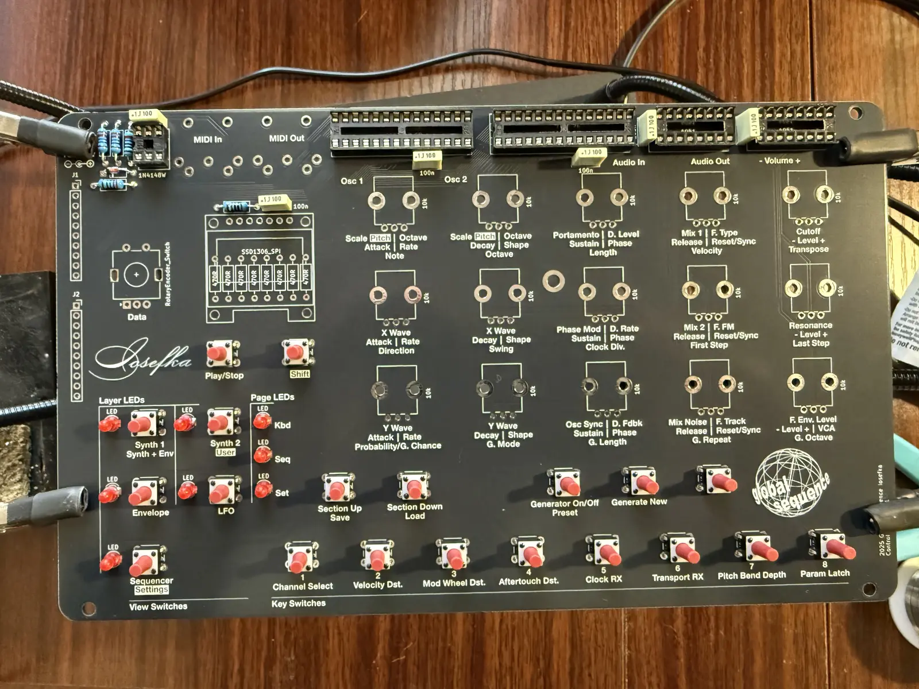
[picture p58: _documentation/docs/assets/cb_6_sw.webp]
cb_6_sw


Place the potentiometers. It's kind of tricky, I like to put one of the anchors in, then guide the three pins in, and then press the second anchor in with my thumb. Also, up to you but I don't solder the anchors. God forbid we have to remove one or more of these one day. 

I've also placed the encoder in at this point.

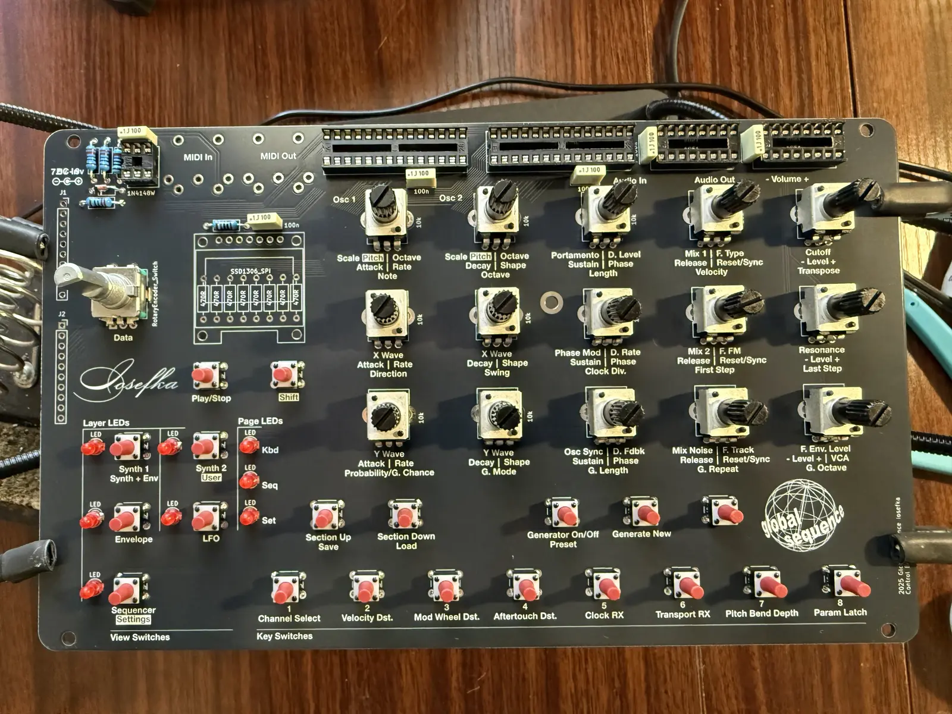
[picture p59: _documentation/docs/assets/cb_7_pots.webp]
cb_7_pots


Now place the resistors on the underside of the board. When you cut the leads on these, cut them as short as possible, so they don't touch the OLED when it is in place.

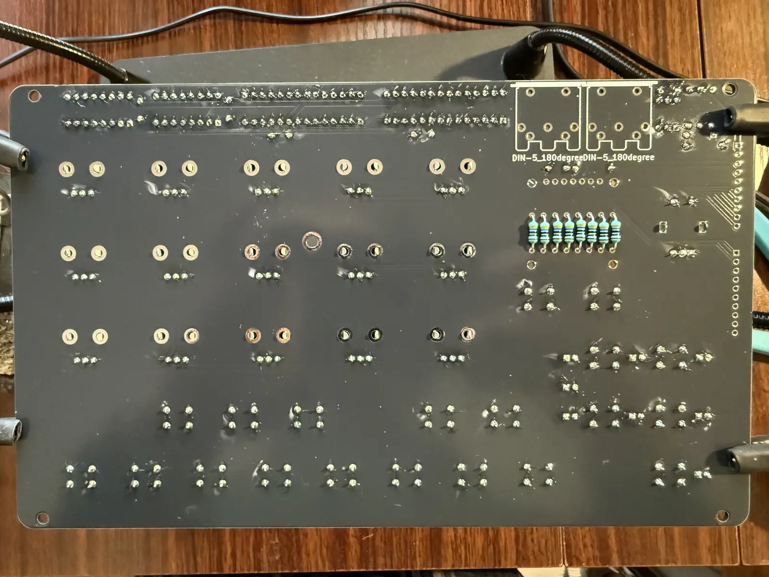
[picture p60: _documentation/docs/assets/cb_8_resistors.webp]
cb_8_resistors


Place the MIDI sockets. Hold them in place with some tape or a rubber band if necessary.

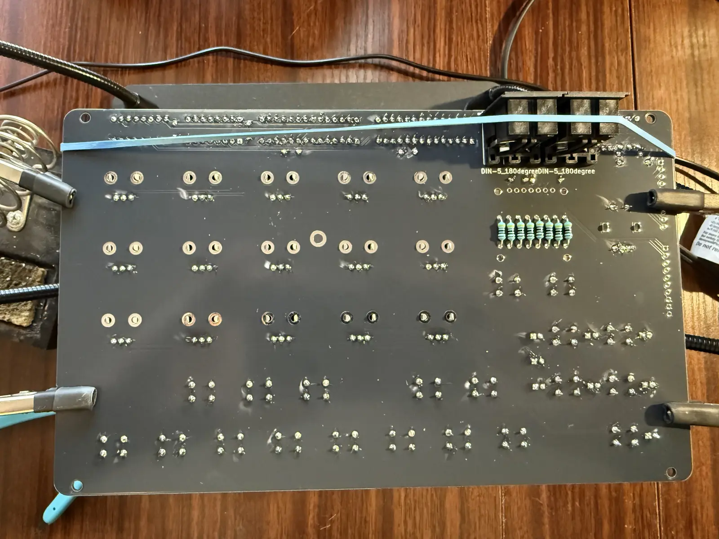
[picture p61: _documentation/docs/assets/cb_9_midi.webp]
cb_9_midi


Place the pin headers and solder them on the top of the board. Here I'm holding the headers in place and in alignment with some painter's tape.

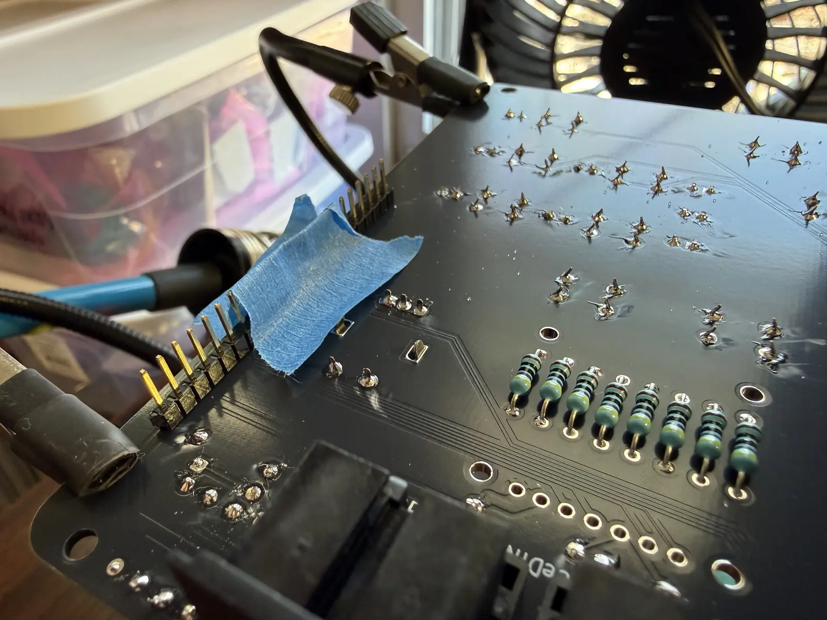
[picture p62: _documentation/docs/assets/cb_10_pins.webp]
cb_10_pins


Use 2M Screws for the OLED screen, and fasten the nuts on the underside. The nuts might get caught on the pin header, if so, twist the screw itself and the nuts will spin into place. If the OLED comes with pin headers already soldered in, then solder the pin headers straight into the board.

*Note 1: The nuts are shorter than the plastic piece on the pin header. If this is undesirable, you can double up on the nuts on the underside of the display.*

*Note 2: The holes for the screws are larger than the M2 screws, this is because these OLED displays are not at all standardized so the screw holes on your display may vary in width and vertical placement from another one.*

![[IMG_2567.webp]]

Fasten the OLED in place after soldering it in.

![[IMG_2568.webp]]

Since you're soldering some components on the top side of the control board, some unsightly flux residue may occur. You can get it off with some rubbing alcohol. Thus far, I have not removed any silkscreen this way, but might be a good idea to do a small test swab to see if it's safe depending on where you get your board fab'd. 

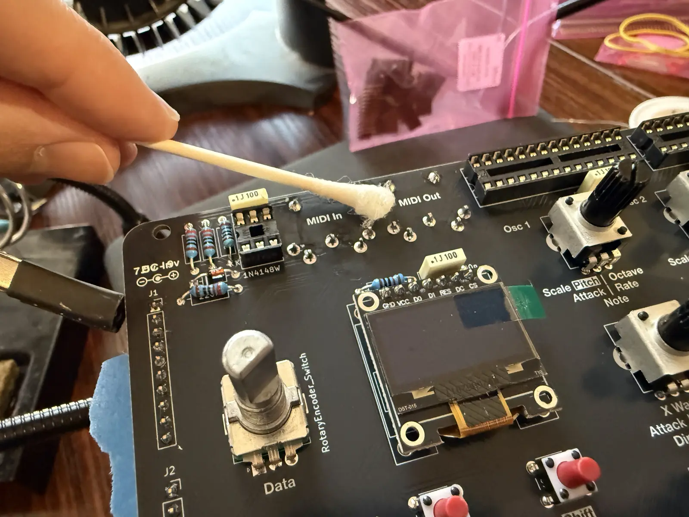
[picture p63: _documentation/docs/assets/IMG_2148.webp]
Control Board - Removing Flux


Ain't it beautiful? If you purchased a cap for the encoder, you can christen the control board with it now.

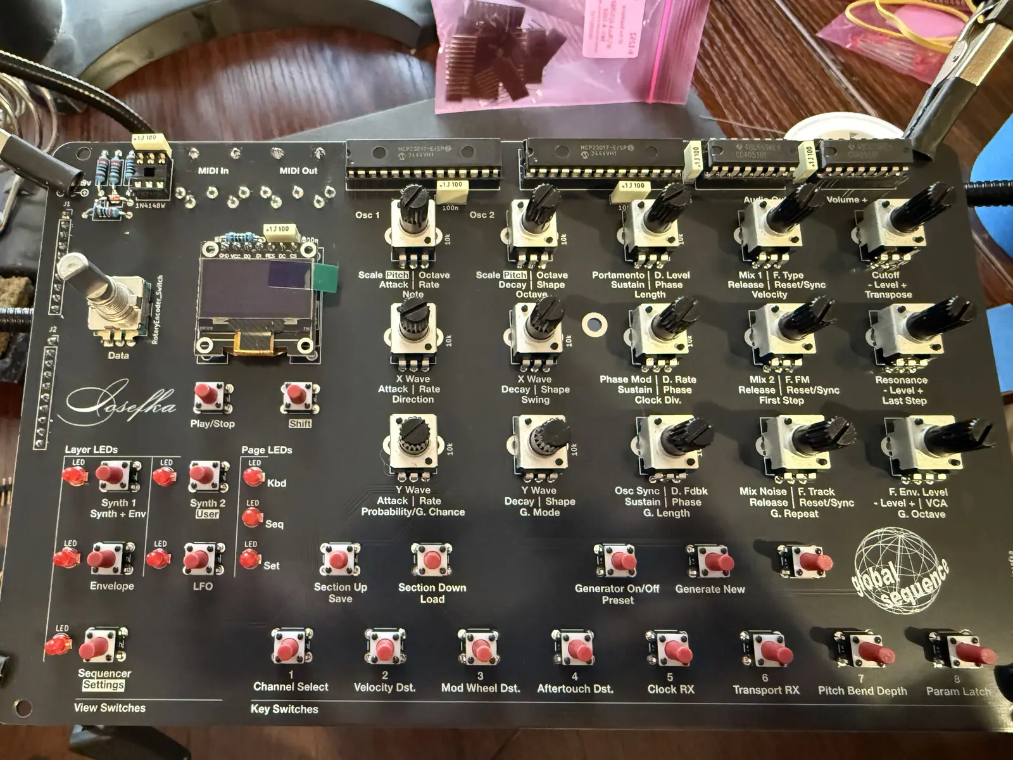
[picture p64: _documentation/docs/assets/IMG_2149.webp]
Control Board - Complete


## Motherboard
As above, so below. Place the DIP sockets first.

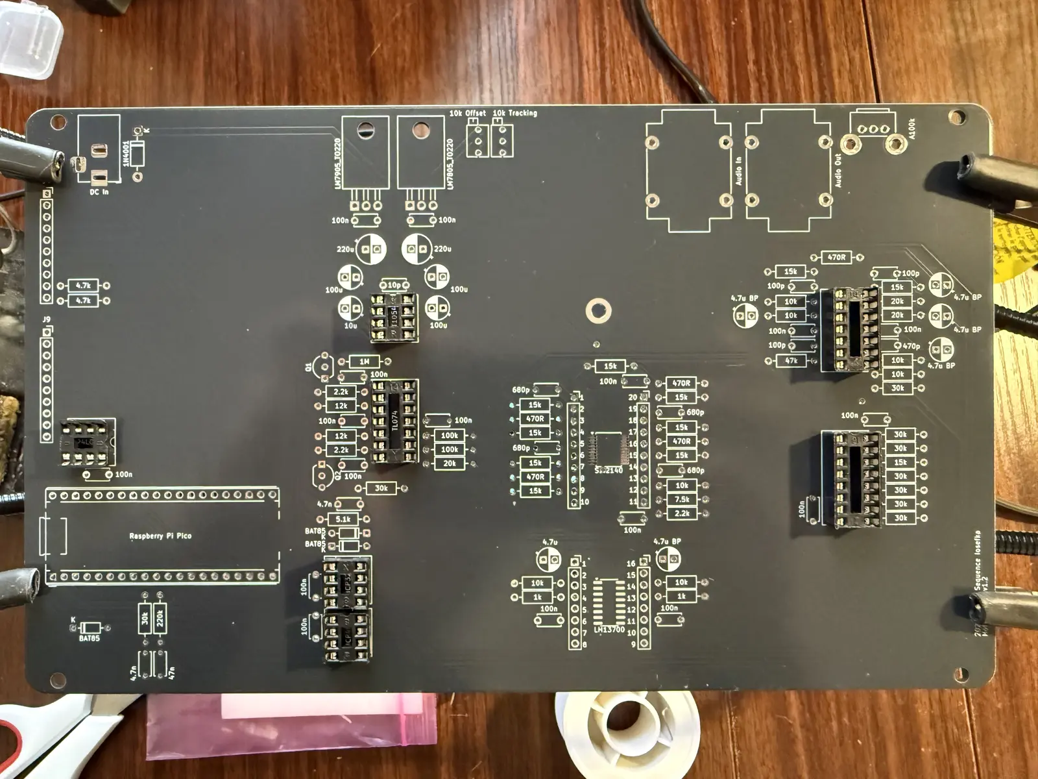
[picture p65: _documentation/docs/assets/mb_1_sockets.webp]
mb_1_sockets


**Note:** Make sure that the MCP4822 and MCP3201 sockets are facing each other as in this picture. The MCP3201 socket (and consequently the MCP3201 chip lol) faces down.

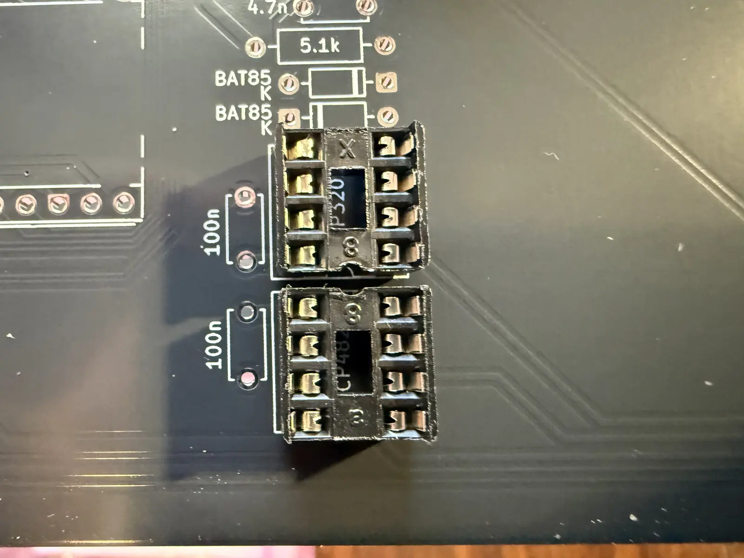
[picture p66: _documentation/docs/assets/mb_2_sockets.webp]
mb_2_sockets


I highly recommend putting the female pin headers in next, as I use painters tape to secure the pin headers to the PCB before soldering, which gets a bit harder if there are a bunch of resistors and caps in the way.

**Note:** These are the short-pinned female pin headers. The long pinned ones will be used further down in the build guide. 

I also place the audio jacks and the barrel jack for the power for the same reasons. It's easier to hold them in place when the board is not populated.

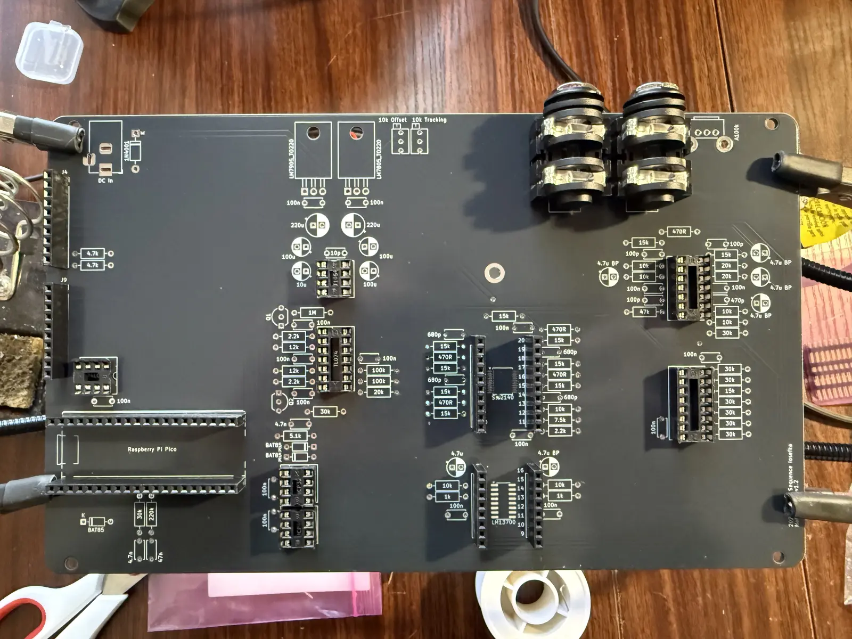
[picture p67: _documentation/docs/assets/mb_3_headers.webp]
mb_3_headers


Place the resistors and diodes. I did the resistors and diodes in one go cuz there's like 3 diodes.

NOTE: Ignore the resistor marked as DNP (do not place) on the PCB. This is from an older version and not in use. This resistor is marked as DNP on the PCB, you can't miss it. 

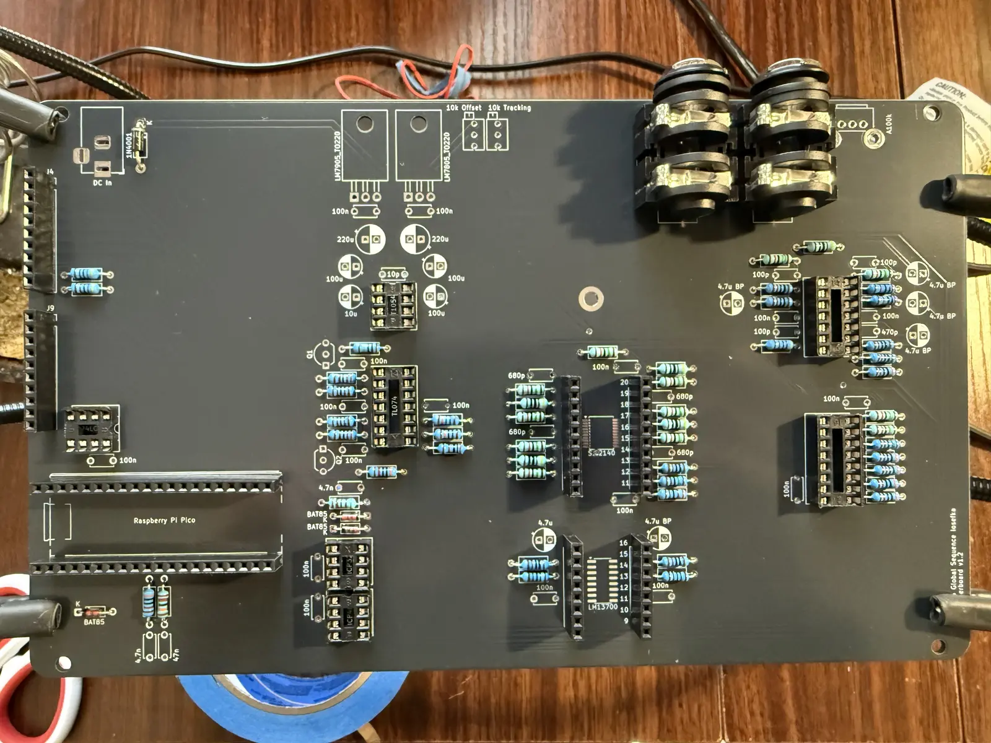
[picture p68: _documentation/docs/assets/mb_4_resistors.webp]
mb_4_resistors


Place the ceramic caps. Ignore the fact that all my 100nf caps are the floppy circular kind. I got a billion of them in bulk. 

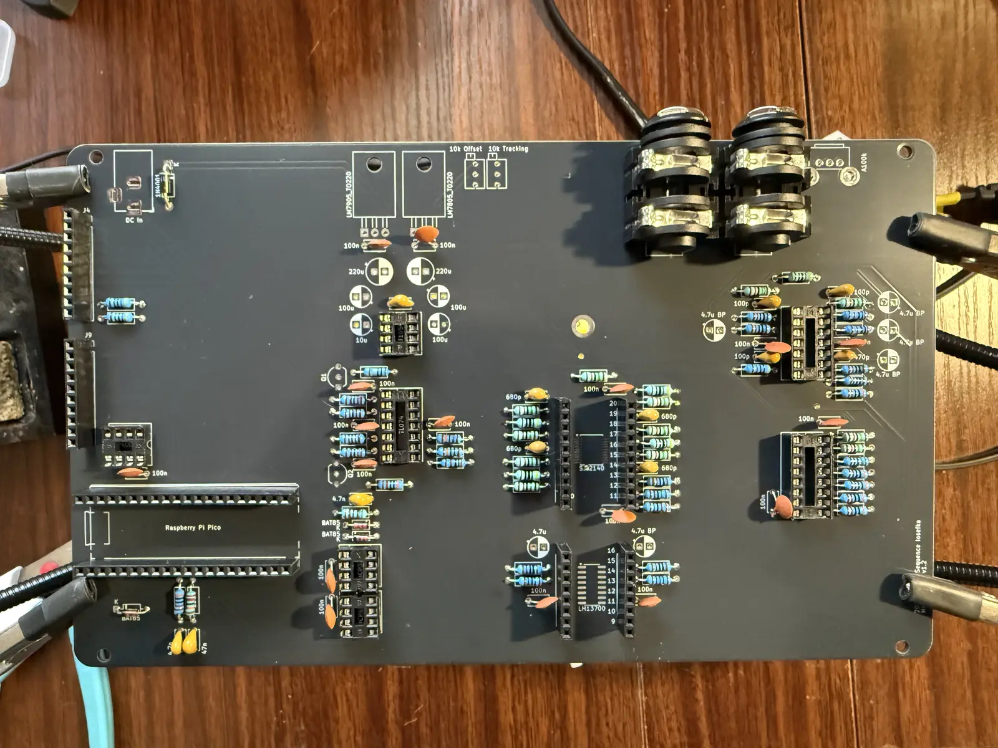
[picture p69: _documentation/docs/assets/mb_5_caps.webp]
mb_5_caps


Place the electrolytic caps. Long pin goes into the black side, short pin goes into the white side. 

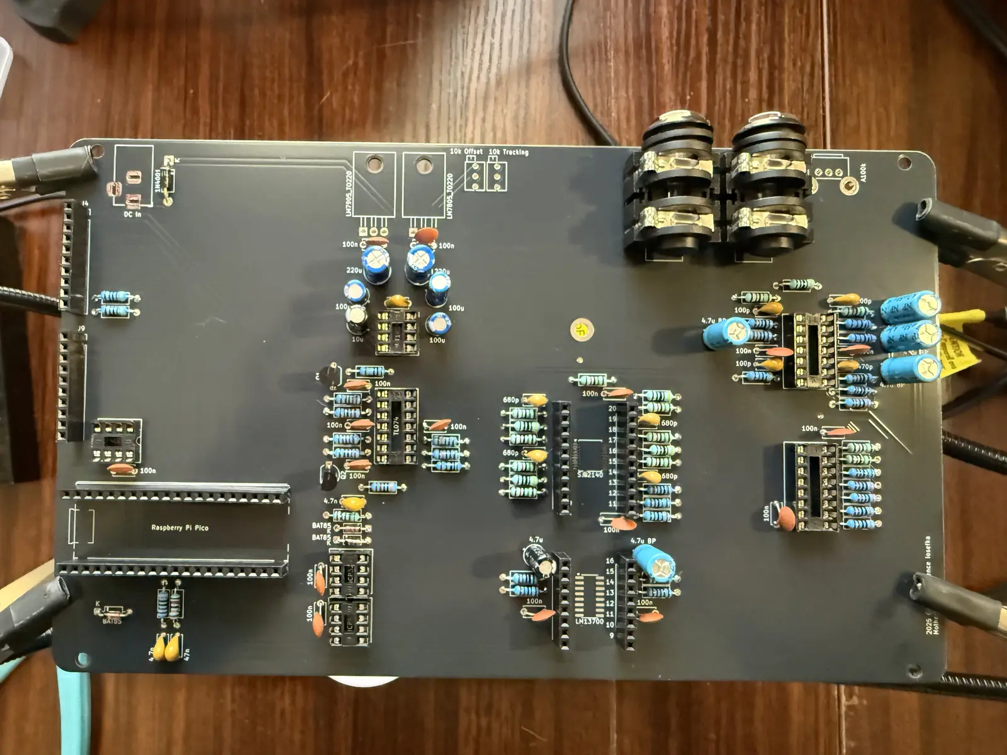
[picture p70: _documentation/docs/assets/mb_6_elec_caps.webp]
mb_6_elec_caps


Now for the miscellaneous components along the top.

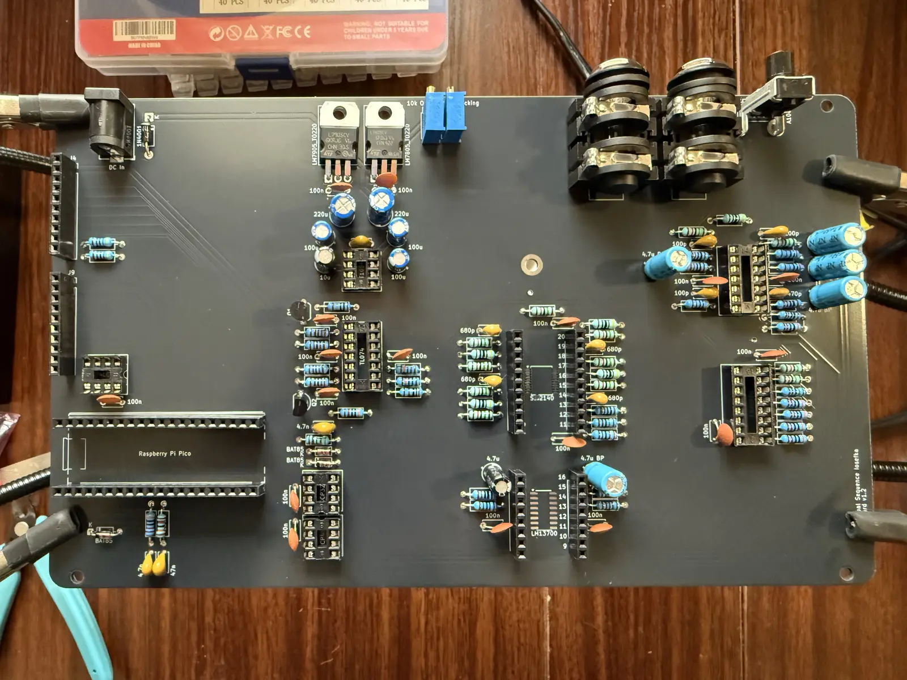
[picture p71: _documentation/docs/assets/mb_7_misc.webp]
mb_7_misc


Let's do a quick power test now. Insert the LT1054 IC and the Raspberry Pi Pico board. 

**!IMPORTANT!:** Before plugging in the power adapter, make sure that the motherboard is NOT on a metal or conductive surface. Ideally, the PCB should be suspended. 

Plug the power supply into the barrel jack.

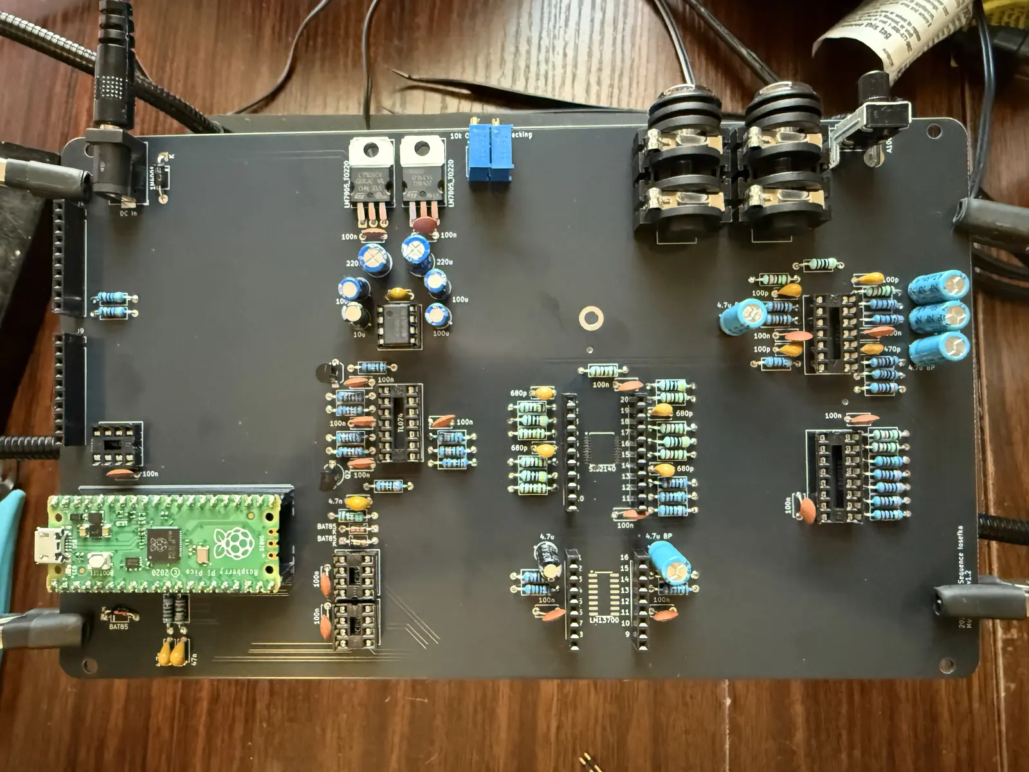
[picture p72: _documentation/docs/assets/mb_8_test1.webp]
mb_8_test1


With a multimeter, find the CD4051 socket in the bottom right of the motherboard and put the black lead on the ground pin (GREEN), and use the red lead to test the +5v and -5v pins pictured below.

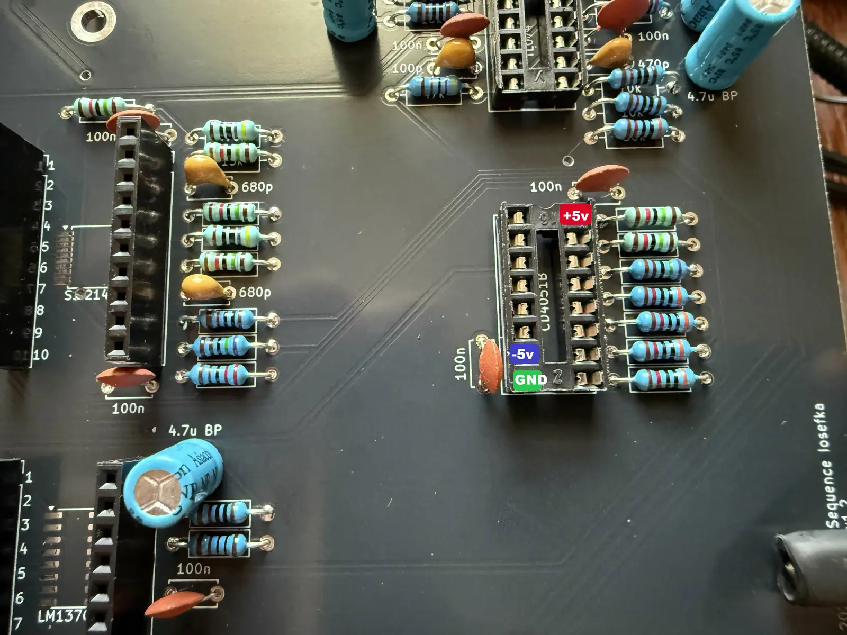
[picture p73: _documentation/docs/assets/mb_9_test2.webp]
mb_9_test2


Find the 24LC256 socket (above the Raspberry Pi Pico). Again with the multimeter, put the black lead on the ground pin and the red lead on pin 8, see picture below.

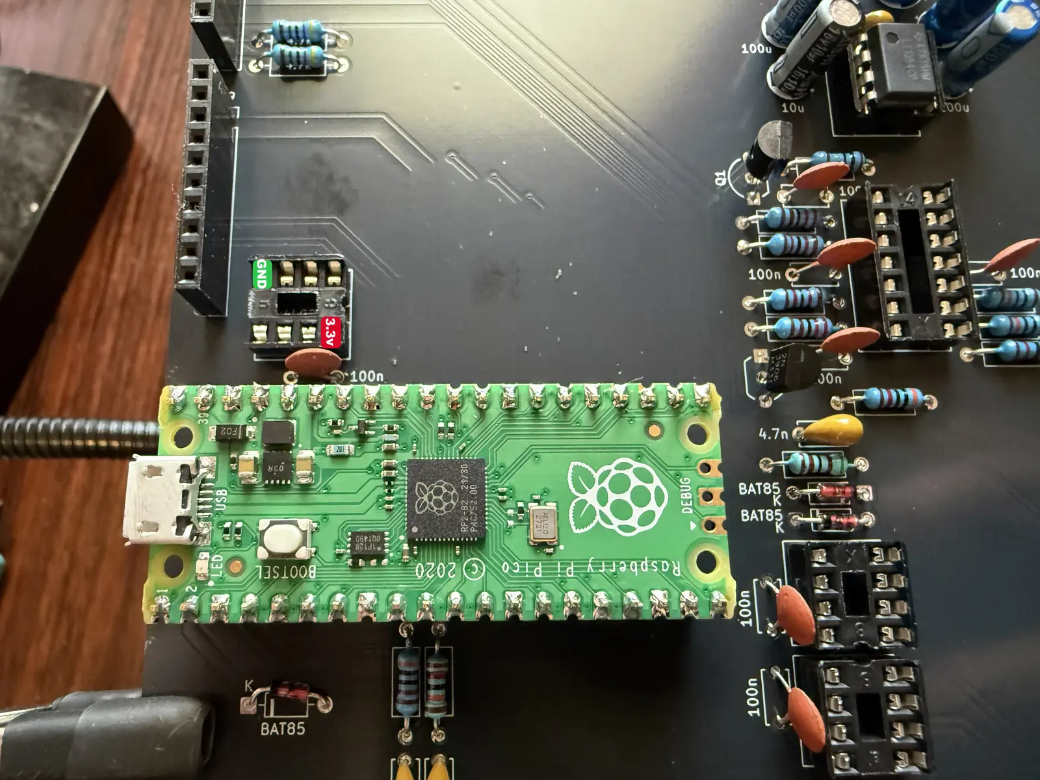
[picture p74: _documentation/docs/assets/mb_10_test3.webp]
mb_10_test3


If the power is supplied in the way listed in the two pictures above, proceed to place the ICs, microcontroller, and breakout boards [(see section below for soldering breakout boards and microcontroller)](#breakout-boards). Brings a tear to yer eye. 

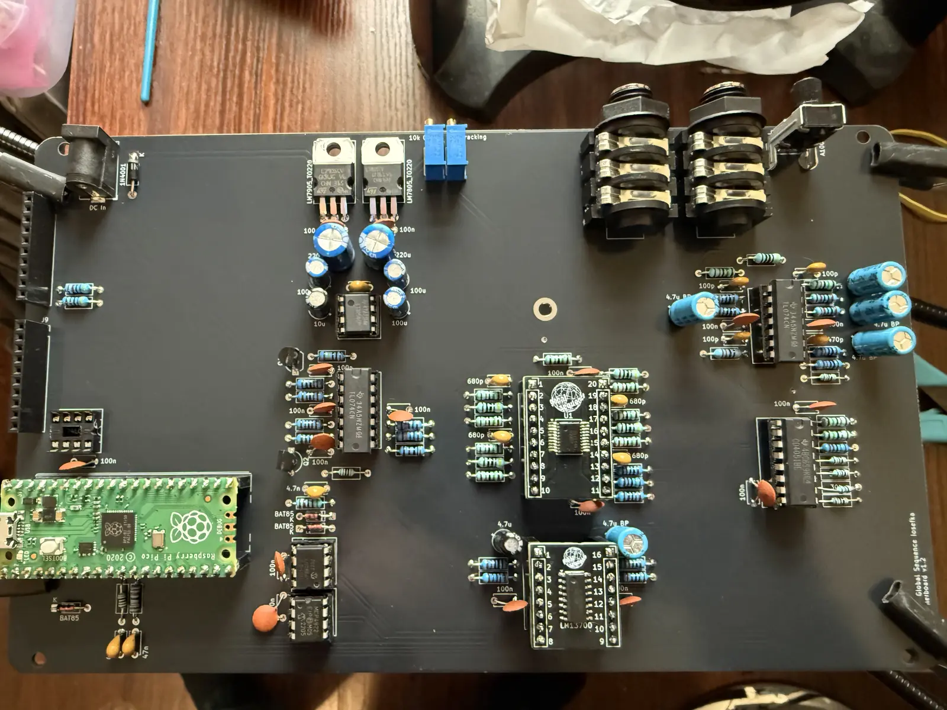
[picture p75: _documentation/docs/assets/IMG_2172.webp]
Motherboard - Components Placed


## Breakout Boards
Time for some SMD soldering folks! For both the LM13700 and SSI2140, the instructions are the same.

**Note:** The SMD instructions here are by no means comprehensive, I recommend one of the many helpful YouTube videos on soldering SMD chips. It's not as intimidating as it sounds, but it's more than I think is appropriate to type out in the build guide.  

**Note:** There is a spot on the Motherboard PCB where you can solder the SMD components directly, but I prefer breakout boards for easy future maintenance if necessary. Up to you.

First, apply some flux to the pins on each corner of the breakout. 

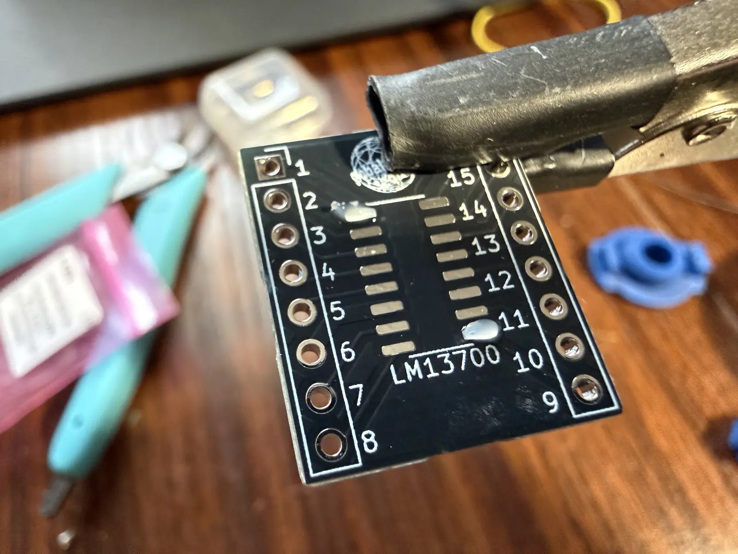
[picture p76: _documentation/docs/assets/IMG_2166.webp]
Breakout - Flux Corners


Place the IC making sure that the first pin is in the correct corner, as indicated by the small circle on the IC, and the arrow on the breakout.

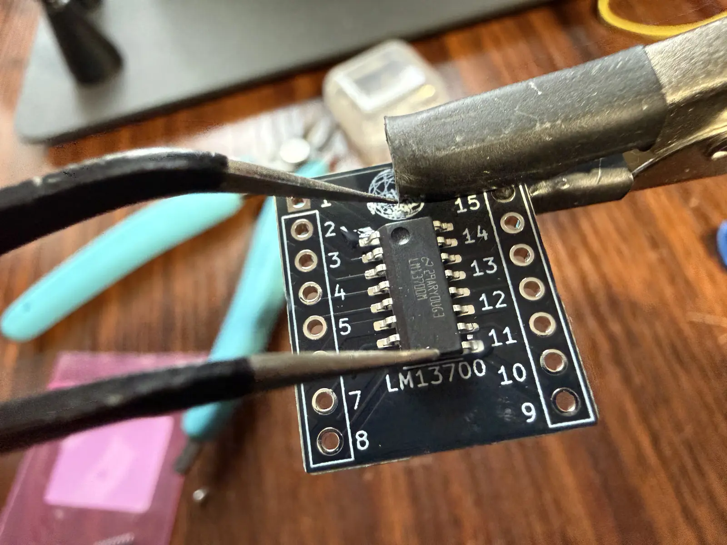
[picture p77: _documentation/docs/assets/IMG_2167.webp]
Breakout - Placing IC


Apply solder to the two pins with flux. 

Apply flux to all the other pins and solder them, ensuring that there is no solder bridges.

Then make sure to remove all the extra flux with rubbing alcohol and a q-tip or microfiber rag.

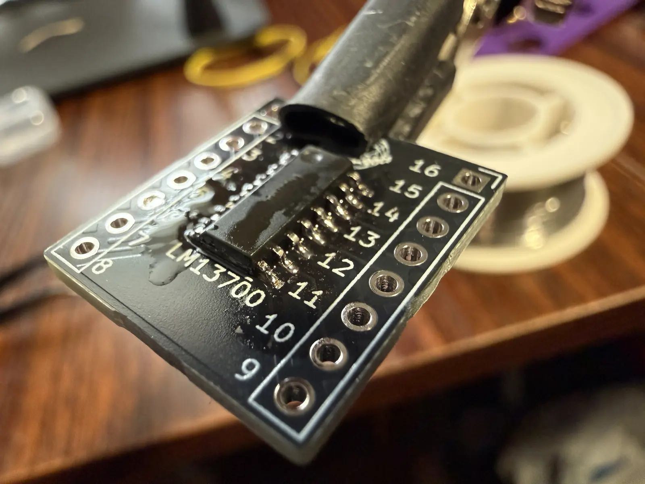
[picture p78: _documentation/docs/assets/IMG_2168.webp]


For both the microcontroller and the breakout boards, it is helpful to secure the pin headers by resting them on a breadboard, and then putting the components on top as pictured below. I don't recommend pressing the pins into the breadboard, as it may affect the pins' vertical alignment.
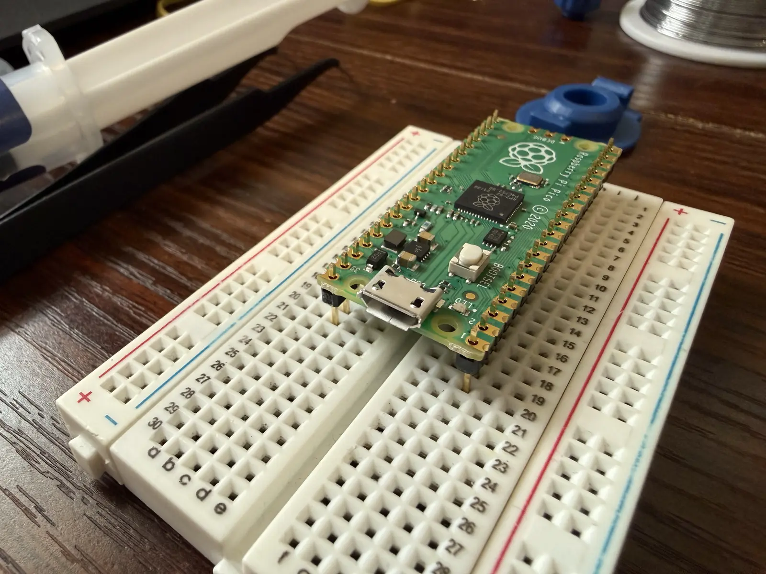
[picture p79: _documentation/docs/assets/IMG_2169.webp]
Breakout - Breadboard Alignment


Solder the corner of one side first, ensuring that the pins are as vertical as possible. You can use this single solder point to align both pin headers. For example, if  you solder the one corner and the pin headers are slanted, you can reheat the single solder joint while aligning the board with your finger on top, then let the solder cool. The pins should now stay aligned while you solder the rest in. 

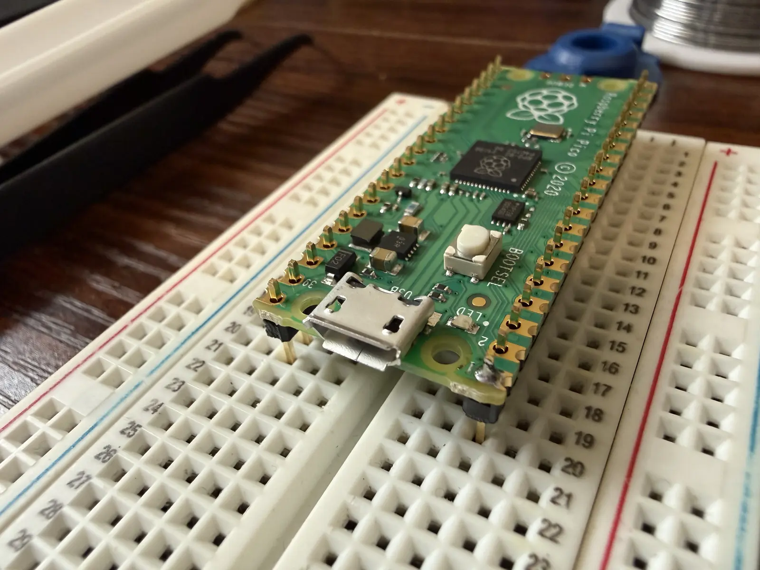
[picture p80: _documentation/docs/assets/IMG_2170.webp]
Breakout - Soldering Corners


Solder the rest!

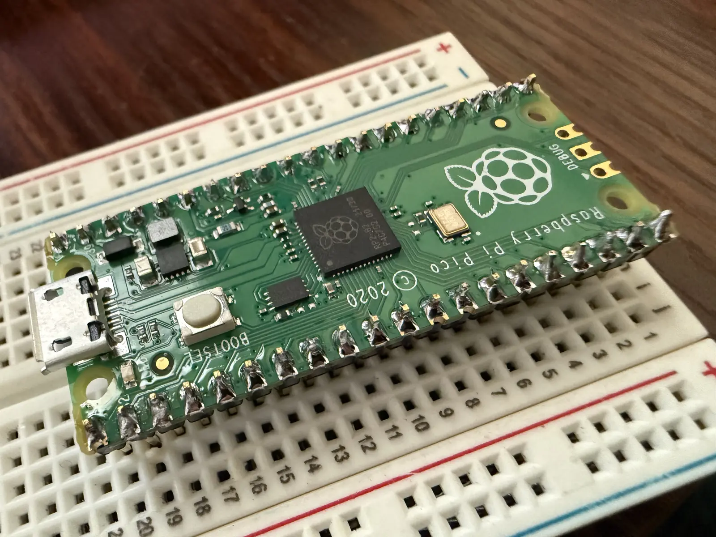
[picture p81: _documentation/docs/assets/IMG_2171.webp]


## Assembling the Boards

On the Control Board, put the hex screws through the top side and screw the spacers into the bottom side by hand. Hand-tight is fine, don't go damaging your board now.

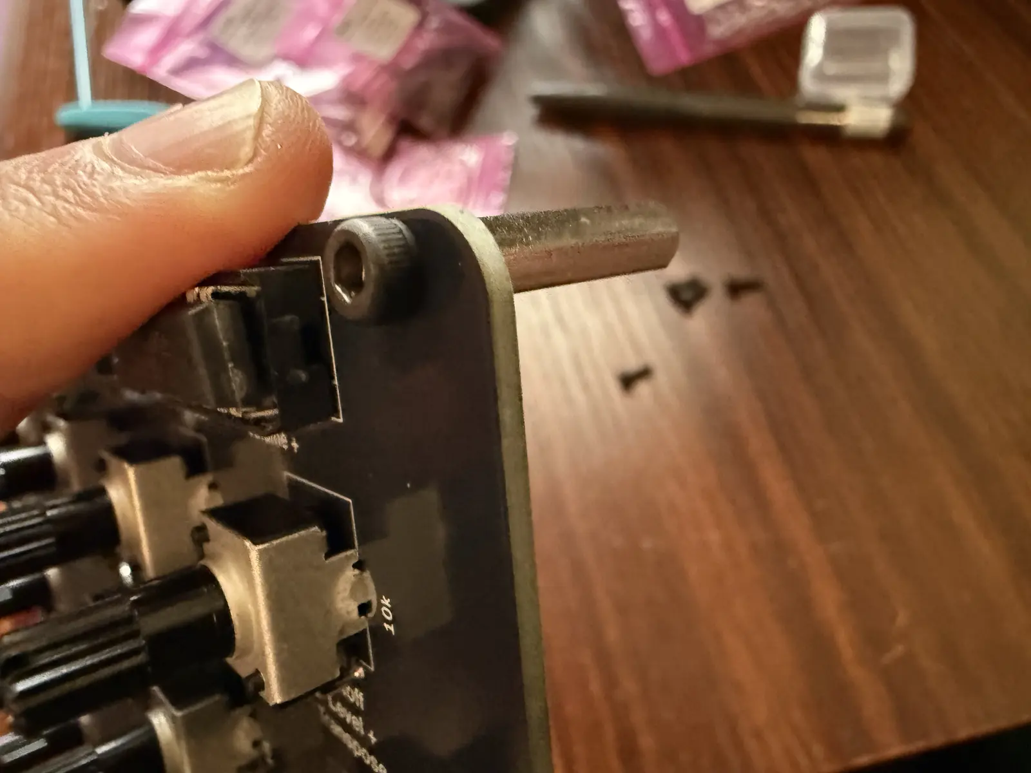
[picture p82: _documentation/docs/assets/IMG_2179.webp]
Assembly - Hex Screw and Spacers


All screws/spacers in.

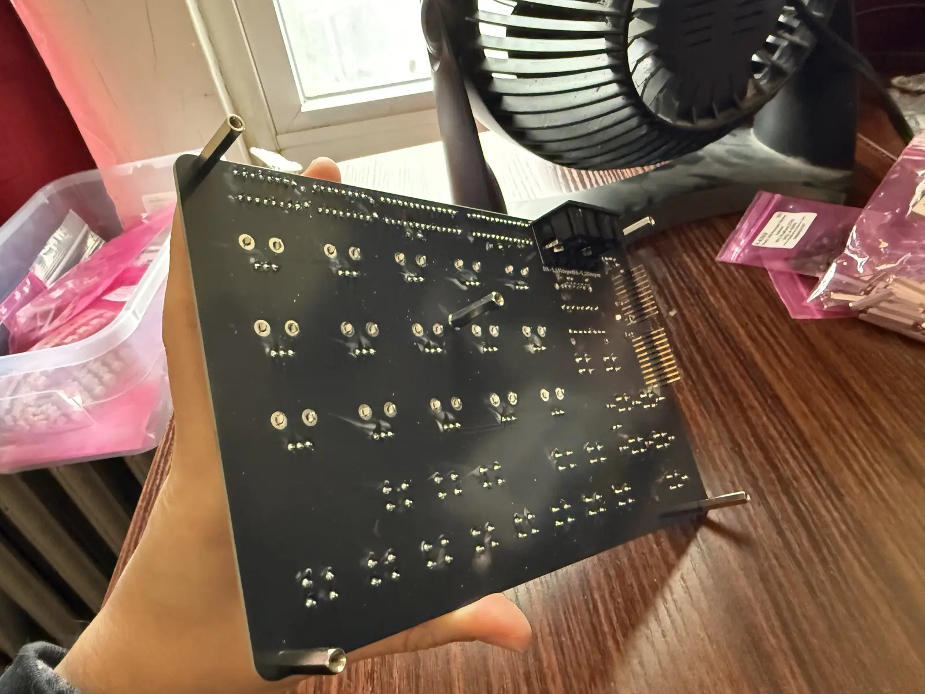
[picture p83: _documentation/docs/assets/IMG_2180.webp]
Assembly - Hex Screws and Spacers All


In the Bottom Board (with the Iosefka logo), screw in the screws and the plastic nuts, leaving some slack in the screw, so that the screw can turn when connecting boards. 

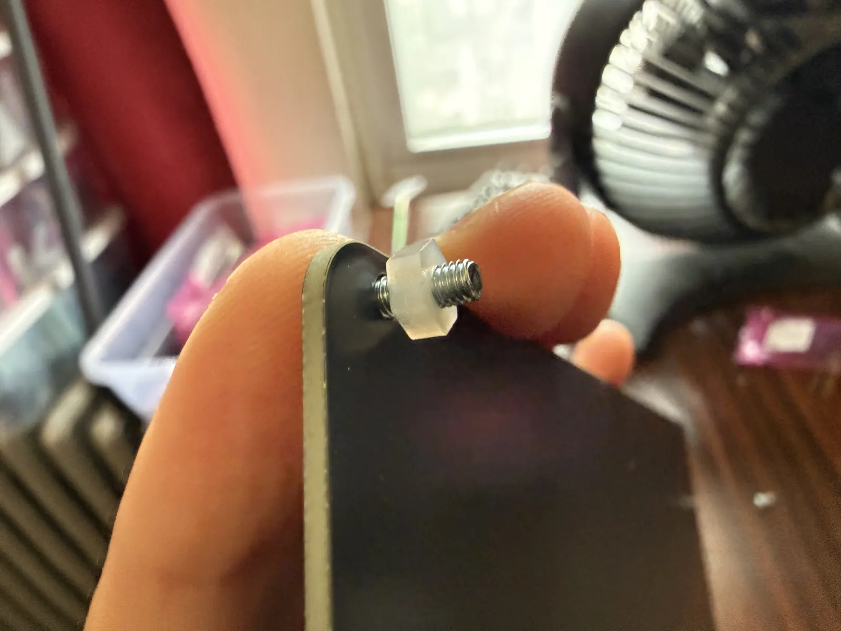
[picture p84: _documentation/docs/assets/IMG_2181.webp]
Assembly - Bottom Screw and Spacers


Iosefka uses two female pin headers as spacers to connect the pins that lead from the Motherboard to the Control Board. The standard female pin headers don't have pins long enough, and the long-pinned pin headers are too long, so we have to compromise by cutting the pins on the long-pinned ones. 

In this picture, I've put the female pin headers side by side with the male pin header to show the length that the leads need to be cut to.

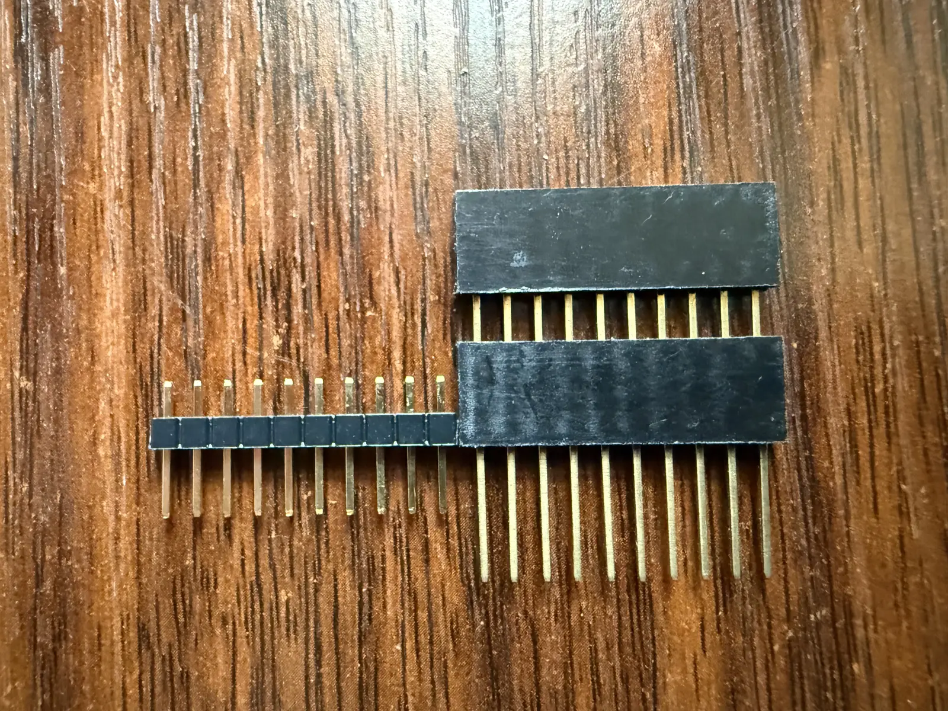
[picture p85: _documentation/docs/assets/IMG_2174.webp]
Assembly - Pin Comparison


Really, you can eyeball it. As long as the cut pins are roughly the length of the male pin header. A few millimeters short or long should be fine. However, if you want to be thorough, you can put the male pin header atop the female one, and use a marker to trace along the bottom of the male pin header to see where you should cut. Cut slightly above the marked line.

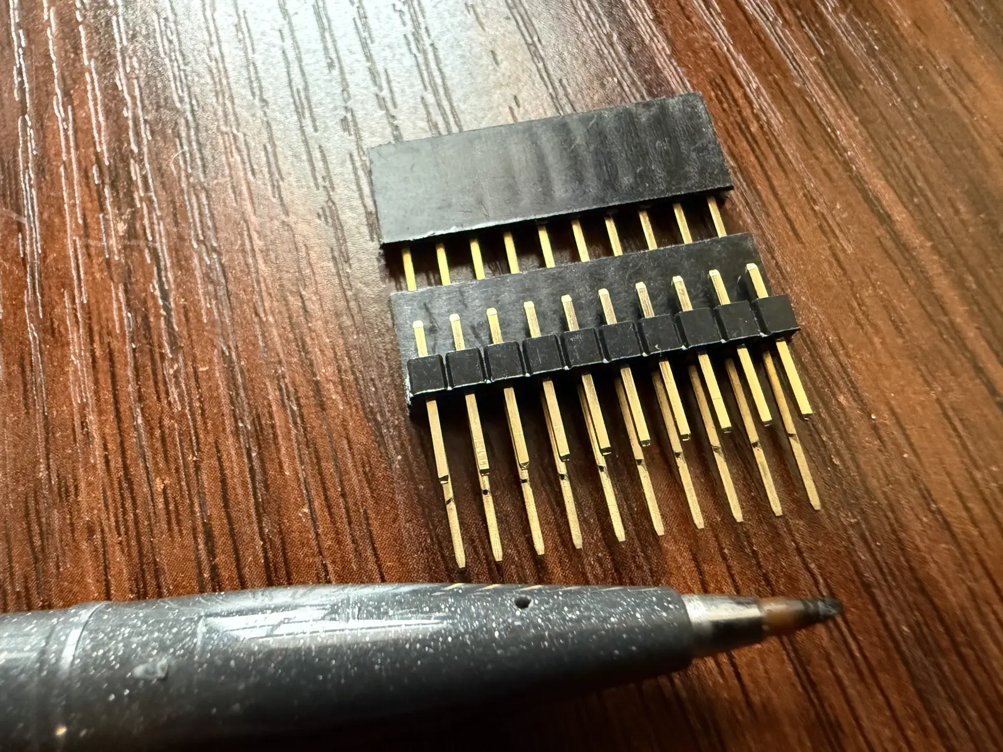
[picture p86: _documentation/docs/assets/IMG_2175.webp]
Assembly - Marking Pins


As you can see, it's not perfect, but it works just fine!

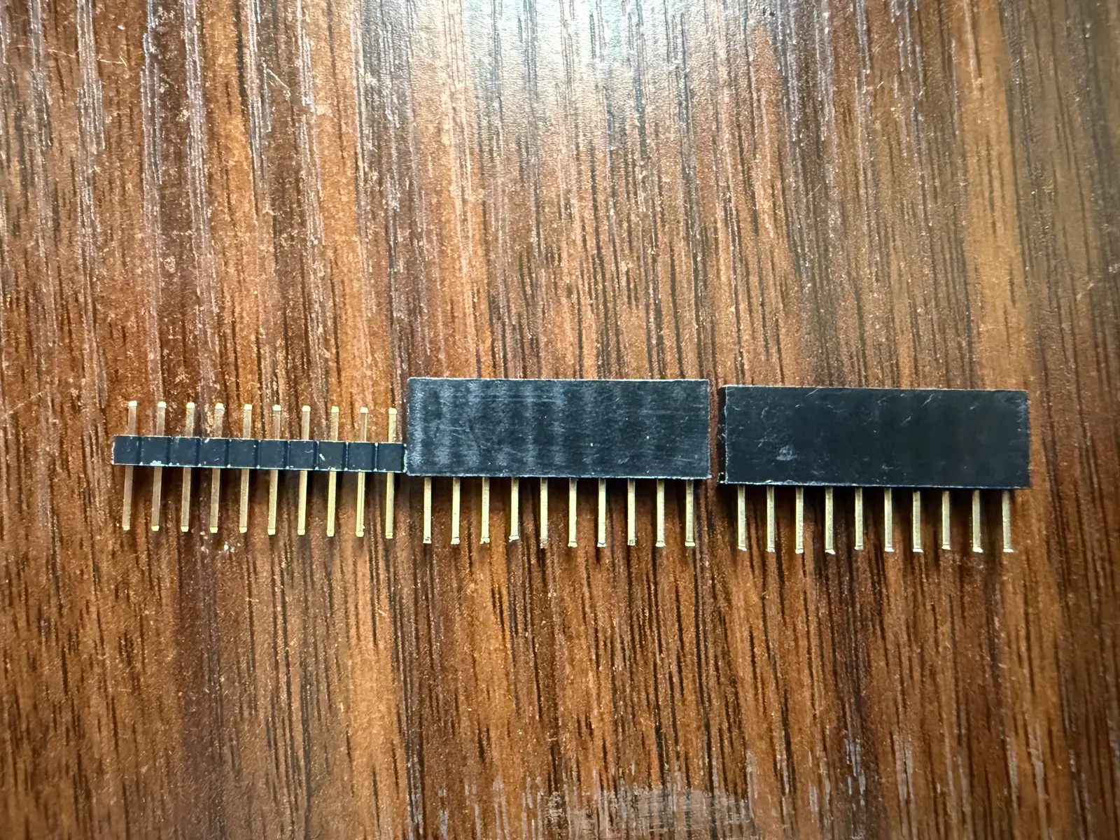
[picture p87: _documentation/docs/assets/IMG_2178.webp]
Assembly - Cut Pins


Place the pin headers in the pin sockets on the control board.

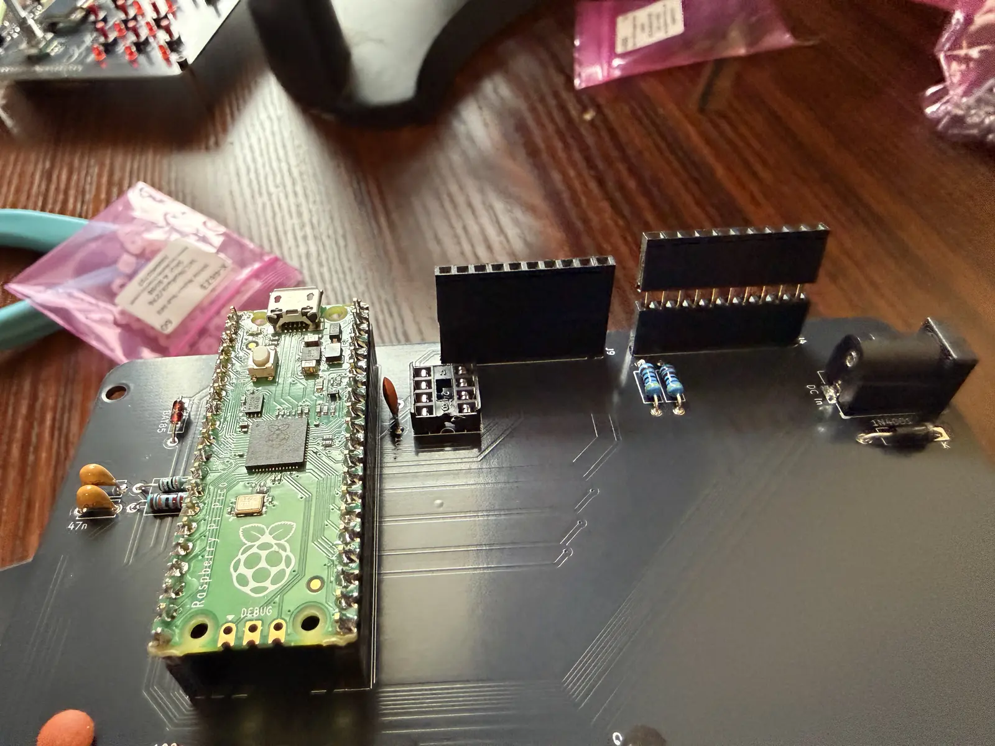
[picture p88: _documentation/docs/assets/IMG_2182.webp]
Assembly - Pin header


Attach the Control Board to the Motherboard by placing the male pin headers into the female pin headers.

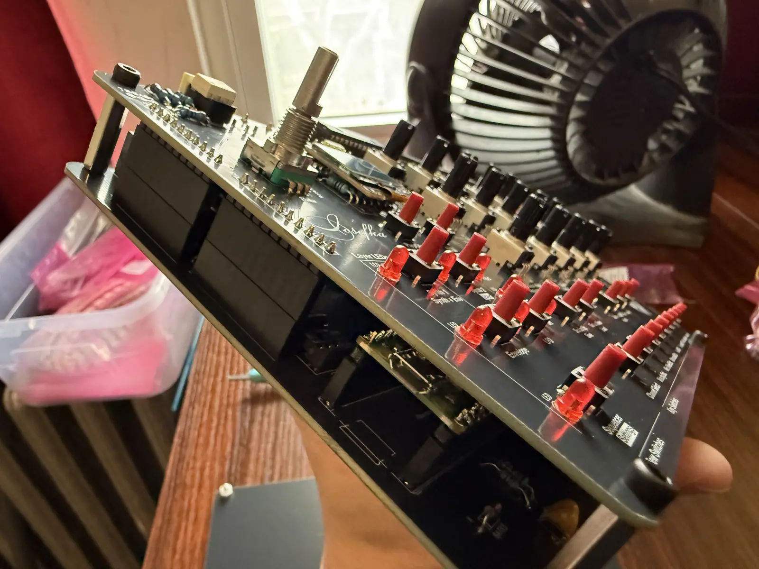
[picture p89: _documentation/docs/assets/IMG_2183.webp]
Assembly - Attaching Control Board to Motherboard


Align the Bottom Board with the Motherboard and screw the screws into the Control Board spacers.

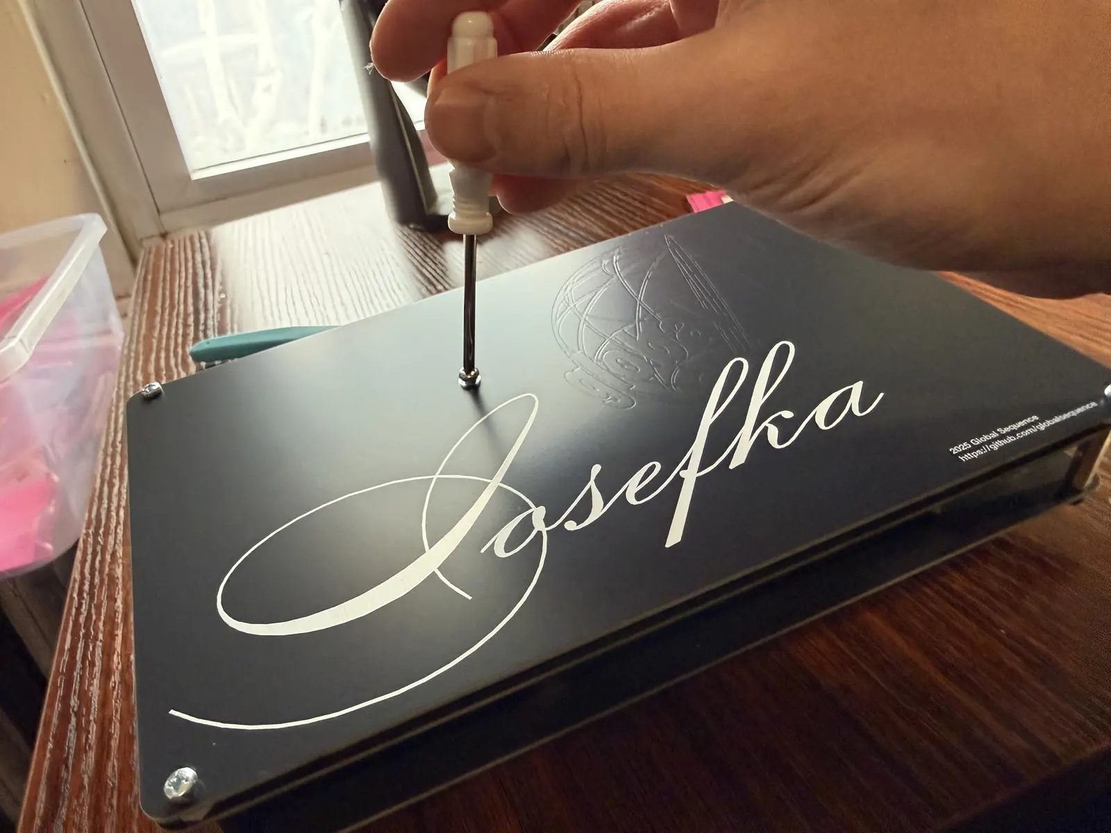
[picture p90: _documentation/docs/assets/IMG_2184.webp]
Assembly - Screwing Bottom Board to Motherboard


Go nuts and place rubber feet wherever the hell you want. Just make sure there's four of 'em! 

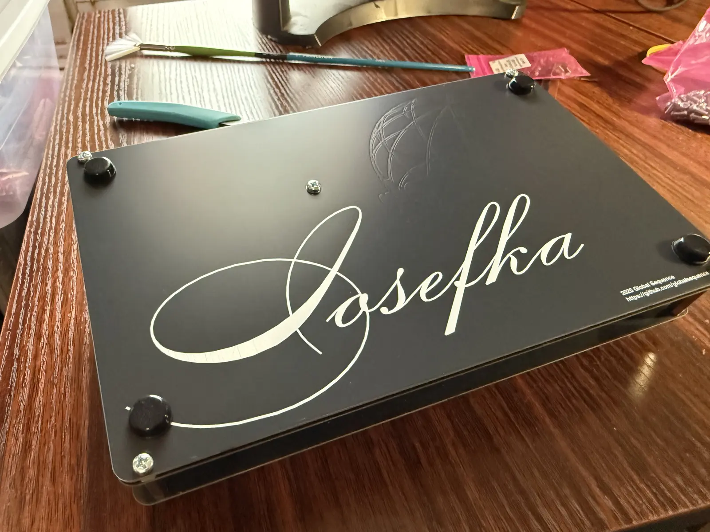
[picture p91: _documentation/docs/assets/IMG_2185.webp]
Assembly - Placing Rubber Feet


Behold your work!

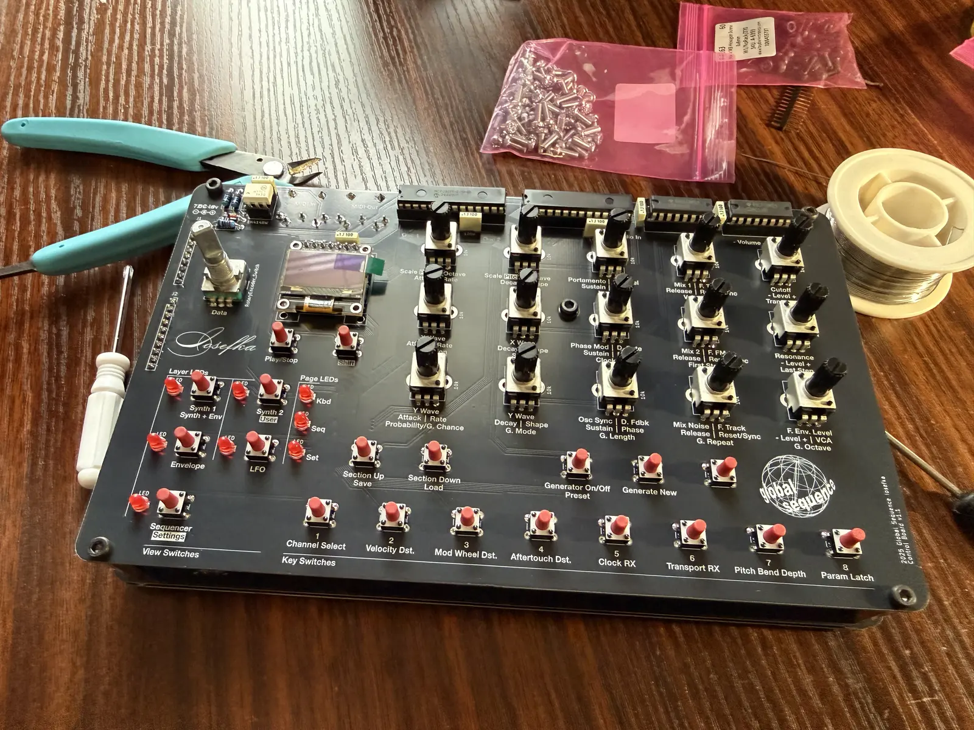
[picture p92: _documentation/docs/assets/IMG_2186.webp]
Assembly - Complete


At this point, you should be able to plug power into your Iosefka model and it will power up. 

Before plugging Iosefka into audio, you must now format the EEPROM.
## Formatting the EEPROM
You just need to hold down some buttons with the power off, then plug the device in. See the [Initializing All Presets](./supplemental.md#initializing-all-presets) section for the exact details. 

Now! If you plug the synth into a speaker and hit one of the keyboard switches and hear sound, that's a great sign! 

Lastly, we just need some...
## Calibration
The two trimpots on the back of the synth are for:
 - Filter Cutoff Offset - ensuring that the filter is in the correct frequency range
 - Filter Tracking - Making sure that the filter plays musically across a certain octave range

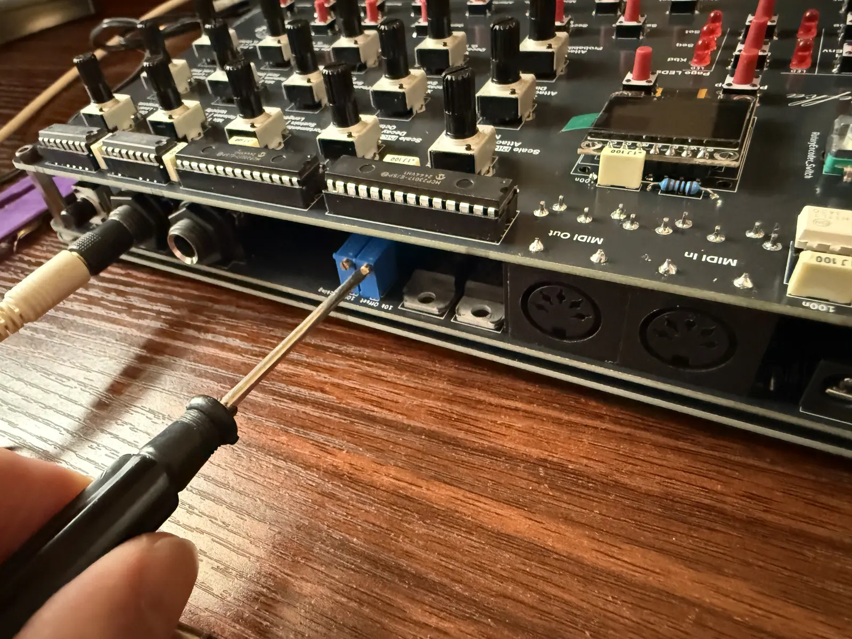
[picture p93: _documentation/docs/assets/IMG_2189.webp]
Calibration - Setting Offset and Trim


### Cutoff Calibration
The filter on Iosefka ranges between roughly 20Hz to 20kHz. You can use an oscilloscope to calibrate the cutoff, but we can also just calibrate this by ear using the self-resonance. 
With the synth on:

 - Navigate to the Synth 1 View
     - Turn down Mix 1, Mix 2, and Mix Noise parameters to 00
     - Turn Cutoff to 00
     - Turn Resonance to FF
 - Navigate to Synth 1 View
     - Hold shift and turn the VCA Parameter to FF 
 - Navigate to the Synth 2 View
     - Ensure the F. Type parameter is L4
     - Turn the F. Track parameter to 00 

You should now hear a sine wave from the filter self-oscillating. Looking directly at the back of the synth (like in the pic above), turn the Offset trimpot to the left until the sound is too low to hear. Now if you turn the Cutoff parameter to FF, and you still hear a super high pitch, turn the Offset trimpot to the right until the sound is too high pitch to hear, then turn it just a smidge more if you're 30 or older. 

### Tracking Calibration
We will now use the built-in sequencer on Iosefka to test the tracking across 5 octaves. We will enter 6 octaves in the sequencer just to see if we get lucky. 

A musical tuner will help us with this one
With the synth on:

 - Navigate to the Synth 1 View
     - Turn down Mix 1, Mix 2, and Mix Noise parameters to 00
     - Turn Cutoff to 40 
     - Turn Resonance to FF
 - Navigate to Synth 1 View
     - Hold shift and turn the VCA Parameter to FF 
 - Navigate to the Synth 2 View
     - Ensure the F. Type parameter is L4
     - Turn the F. Track parameter to FF (Make sure it's on FF not 00!)

At this point, you should hear the sequencer self-oscillating in perpetuity. Make sure it's loud enough so that your neighbors can hear its glory!

 - Navigate to the Sequencer view 
     - Make sure that the Sequencer pattern is empty. If it is not, load a blank preset, which should have an empty pattern and start from the top.
     - Turn the First Step parameter to 00
     - Turn the Last Step parameter to 05
     - Turn the Clock Div parameter to *8
     - Turn the Octave parameter so that the note in the top left of the OLED Display reads "C1"
     - Hit Key Switch 1 to place a step with the value C1 on step 1  
     - Repeat the last two steps turning the Octave parameter so that it reads "C2", then hitting Key switch 2, and so on until the you place C6 by hitting Key switch 6. You should now have a sequence of 6 steps ascending one octave per step. 
 - Press the Play switch. You should now hear the sequencer playing a sequence ascending by roughly 1 octave. 
 - Turn the Tracking trimpot in either direction until the sequence comes into tune. Each note should represent one musical octave.

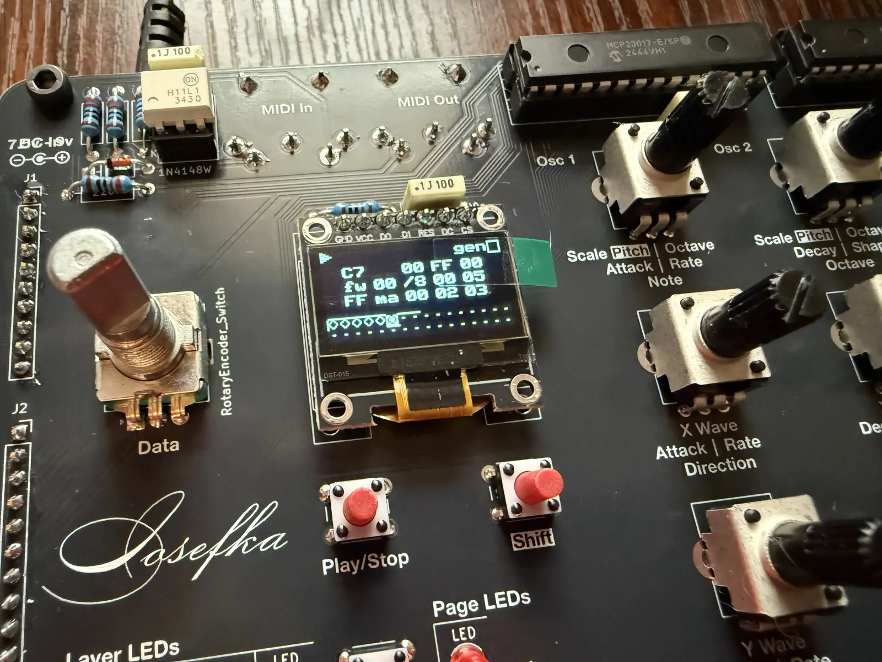
[picture p94: _documentation/docs/assets/IMG_2188.webp]
Calibration - Sequencer Steps
