GlobalSequence/iosefka/_documentation/site/print_page/index.html

# Overview

Iosefka

## Specification

Iosefka is a hybrid digital analog monophonic synthesizer consisting of the following parts:

Digital audio:

- 2x wavetable oscillators, capable of interpolated morphing waveforms in the X and Y dimension along 256 hand-picked waveforms in a 16x16 layout
- White noise generator
- Sample-rate reduction and Bit-rate reduction effects
- Loopback digital delay fed from VCA output with feedback and adjustable rate from >3 ms to ~683 ms

Analog audio:

- V2140 based analog pole-mixing resonant voltage controlled filter with audio rate frequency modulation selectable between:
  - 2 pole low pass
  - 4 pole low pass
  - 2 pole high pass
  - 2 pole band pass
- LM13700 based voltage controlled amplifier
- External audio input direct into analog section and digital delay

Step sequencer:

- 32 step, 24 PPQ performance step sequencer
- Parameterized sequence generator including step chance, length, octave range, and musical scale
- Controls for swing, direction, clock division, first and last step, probability
- Per step Parameter locks for:
  - Note value
  - Step length
  - Velocity value
  - Step Probability
  - Single audio Parameter
- Per step mutes

Modulation matrix to all audio Parameters:

- 3x ADSR envelope generators (converted to control voltage for analog modules)
- 3x Low frequency oscillators (converted to control voltage for analog modules)
- Velocity control
- Aftertouch control
- Mod Wheel control
- Breath Control
- Pitch Bend Control

MIDI Implementation:

- MIDI RX
  - Note and velocity values
  - Realtime messages: clock tick, start, stop
  - CC messages for all audio Parameters (see implementation chart)
  - Modulation control of velocity, aftertouch, mod-wheel
  - Pitch bend with configurable bend range from 1 to 12 semitones
  - Program change (coming soon)
- MIDI TX
  - Note and velocity values (from keyboard and sequencer)
  - Realtime messages: clock tick, start, stop

Patch storage:

- Store 64 patches of all audio and sequencer Parameters
- Store global MIDI and machine settings

Oscilloscope:

- Oscillator phase locked oscilloscope with four 'time' divisions (sample divisions) between 512 to 128 samples.

## Hardware

Hardware components listed in the manual will be referred to by their name as listed below. When hardware components are listed in the manual, they will appear in Bold and Italic

hardware_overview_front

hardware_overview_side

1. OLED Display
2. Data Rotary Encoder - (with switch when pressing down on shaft)
3. Shift switch
4. Play/Stop switch
5. Layer LEDs
6. View switches
7. Page LEDs
8. Key switches
9. Potentiometers
10. Volume knob
11. Output Audio jack
12. External Input Audio Jack
13. Filter tracking tuning trimpot
14. Filter offset trimpot
15. MIDI Output jack
16. MIDI Input jack
17. Power supply jack - (9v DC - Center positive)

## Synthesizer Block Diagram

Block Diagram - Audio

Block Diagram Mod Sources and Key

# Operation

## Powering the device

Iosefka requires a 9v DC center-positive power supply. It is preferable to use a linear power supply (such as the one outlined in the BOM) instead of a switching power supply, in order to reduce noise.

The unit does not have a built-in on/off switch, so operation begins when the power supply is plugged in and ends when it is unplugged.

## Plugging into an external audio source

Iosefka provides line level mono output. Simply plug a ¼" cable into Iosefka's Output Audio jack and plug the other end into your mixer or audio interface, adjusting the volume with the Volume knob as needed.

Iosefka does not have a headphone output. It is not advised to plug headphones directly into Iosefka's Output Audio Jack.

## Playing Sounds

You can play sounds on Iosefka in a variety of ways. Most of these ways will be elaborated on in their own sections, but as a basic rundown:

### Playing sounds with the built-in keyboard

When the Kbd Page is active (by pressing the Synth 1, Synth 2, Envelope, or LFO View switches), the 13 Key Switches play chromatic musical semitones. The lower 8 switches represent white keys and the upper 5 switches represent black keys.

Furthermore, in the Synth 1 and Synth 2 Views, the Keyboard Octave Mode is active, allowing for selecting between octave 2 through 7 of the 128 MIDI standard notes with the Data rotary encoder.

### Playing sounds with the Sequencer

You can just let the synth play itself by pressing the Play/Stop switch, provided that there is an active sequencer Pattern.

More information on the Sequencer can be found in the Sequencer section of this document.

### Playing sounds via MIDI

Iosefka comes with robust MIDI implementation according to the MIDI 1.0 standard. You can plug in any device that produces MIDI Note messages like a keyboard or a computer with a DAW into the MIDI Input Jack in the back of the device. Just make sure that the MIDI Channel in the Settings View matches the MIDI channel of your MIDI output device.

More information can be found in the MIDI Implementation section of this document.

### Just let it drone my dude

By disabling the VCA, Iosefka becomes a drone synthesizer, so it's constantly playing sound. From the Synth 1 Layer, press the Shift Switch and turn the Mix 1 Potentiometer above the "00" value to open the VCA to enter drone mode. Turning the value to "FF" will turn drone mode to full VCA gain.

When the VCA parameter it 00, the VCA is fully closed and will only open with Envelope 3.

## The OLED Display and LEDs

The combination of the OLED Display and the eight LEDs on Iosefka are meant to give thorough visual feedback on the machine's control state, known as the View (more on the View in the section below). Learning this combination is crucial to the workflow of the machine.

Most changes on the physical interface will be reflected somehow on the OLED Display. For example, when you turn a Potentiometer, a value relating to the placement of that potentiometer will change on the OLED Display. For example, turn the top left Potenetiometer and you'll see the number in the top left of the OLED Display change. Knowing that the currently lit Layer LED corresponds to the 15 numbers currently showing on the OLED Display will help you know which Parameters those numbers represent.

A detailed description of the different screens shown on the OLED Display and LEDs is provided in the View Charts section of this document.

### OLED Display

#### A note on the use of hexadecimal

The display on Iosefka is 128x64 pixels. This plus the admittedly tiny size of the screen means that every character counts.

Because of this, most numerical values controlled by a Potentiometer are displayed in hexadecimal, a base 16 number system, instead of the standard base 10 decimal number system. This is actually how many musical trackers display numerical values as well.

Moreover, Iosefka reads the Potentiometers at 8-bit resolution, meaning the voltage from the potentiometer is read as:

- All the way down: 0 (0x00 in hexadecimal)
- All the way up: 255 (0xFF in hexadecimal)
- Halfway: 128 (0x80 in hexadecimal)

In brief, instead of counting like this:

- 0-1-2-3-4-5-6-7-8-9-10-11-12-13-14-15-16-17-18-19-20 … 251-252-253-254-255

The Parameter values count like this:

- 0-1-2-3-4-5-6-7-8-9-A-B-C-D-E-F-10-11-12-13-14 … FB-FC-FD-FE-FF

#### Values that are displayed in decimal

All numerical values controlled by the Data Rotary Encoder show as decimal values (...9, 10, 11...), as well as the following values on the Sequencer View: - Length - First Step - Last Step

#### Bipolar values

Because of the aforementioned issue with space allotted to Parameter values, adding a negative "-" symbol would break the visual convention and hog screen space. As a compromise, bipolar values are displayed as positive hexadecimal values. For example, the values for the "- Level +" Parameters for the Modulation Sources are displayed as 0 to FF, but are in reality -80 to 7F, with 0 as the center value.

To be clear (or more confusing, I don't know): - How it looks on the screen (positive hexadecimal): - Value range: 00 - FF - The center value: 80 - How it works internally: - Value range: -128 - 127 - The center value: 0

Bipolar values are mentioned in all parameters where they apply, and link back here for reference.

#### Hanging screens

A Hanging Screen is a screen which shows for just a few seconds, like showing the Mode when a View is changed, or any time the Data rotary encoder is turned. To view this screen for longer, hold down the Data rotary encoder switch by pressing down on the shaft. The Hanging Screen will persist for as long as the screen is held (plus a few seconds).

#### Display Off Timer

To maintain the longevity of the OLED Display, it will automatically turn off after 5 minutes if none of the physical components are changed (like turning a Potentiometer), or if the sequencer is not running, or if there are no incoming MIDI messages.

### LEDs

As mentioned above, the Layer LEDs and Page LEDs give visual feedback to the respective Layer and Page in the device's current View, described below.

## The View

The total state of the physical user interface is called the View. The View consists of three physical sections:

- Pages - The functions of the 13 Key switches on the control board
- Layers - The Parameters controlled by the 15 Potentiometers on the control board
- Modes - The data selectable by the single Data rotary encoder on the control board

Therefore, the View is determined by which state the Page, Layer, and Mode is currently set on the device. The OLED Display as well as the Layer LEDs and Page LEDs give visual feedback on which View is currently active.

### Changing the View

The View can be changed with the five View switches on the bottom left of the control board.

To see a list of all the Views, visit the View Charts section of this document.

### Page

The function performed by each of the 13 Key switches is determined by which Page is currently active. The currently lit Page LED indicates the current page, and the function of that specific Key Switch is either:

- Key Page - A musical semitone in the layout of a standard piano keyboard
- Seq Page - The first line of text beneath the Key switch
- Set Page - the second line of text beneath the Key switch

The image below illustrates how the Page LEDs indicate what each switch does. The orange sections indicate Sequencer functions and the green indicates Settings functions.

page_reference

To see a list of all the Pages and their corresponding Key switch functions, visit the Page Switch Function Chart section of this document.

### Layer

Before delving into the Layer explanation, a definition: A Parameter in the context of this document is any value that is changeable with a Potentiometer.

The Layer is the state which determines which parameter is controlled by one of the fifteen Potentiometers on Iosefka's control board. The Layers are arranged in a way that represents aspects of the synthesizer from a big-picture perspective. For example, the Synth 1 Layer contains the parameters for the oscillators, mixer and filter, while the Synth 2 Layer contains additional synthesizer effects (with a few parameters that are shared with Layer 1). All parameters on the Envelope and LFO Layers are dedicated to those respective Modulation Sources.

The Layer LED that is currently lit indicates which Parameter name beneath the Potentiometer is currently active. To elaborate, in the image below, note the corresponding color over the Layer LEDs to the Parameter name beneath the Potentiometer. This applies to every Parameter beneath the Potentiometers on the control board e.g. top left Layer LED (Indicating Synth 1 Layer) = top left Parameter, etc.

layer_reference_1

Note: If only one Parameter name appears in a row beneath the Potentiometer, that means that Parameter is active for either layer in that row. For example in the below image, the parameter "Cutoff" is in effect when the active Layer is either Synth 1 or Synth 2.

To see a list of all the Layers and their corresponding Potentiometer Parameters, visit the Layer Parameter Control Chart section of this document.

### Mode

The Data rotary encoder is responsible for handling the input of specific data values depending on which Page or Layer is currently active, as well as several other contexts. The state which determines the data being handled by the Data rotary encoder is called the Mode.

The Mode controls things like the octave of the notes played on the keyboard, the modulation destination of all Modulators, the BPM of the Sequencer, etc.

On all Views except for the Settings View, the current Mode can be viewed in a few different ways:

- Pressing down on the Data rotary encoder shaft to actuate the switch
- Switching the View
- Turning the Data rotary encoder

To see a list of all the Modes, their contexts, and how to view them, visit the Mode Encoder Data List section of this document.

# The Synthesizer

## Digital Audio

Iosefka's sound generation begins in the Microcontroller, where the oscillators and noise generator are mixed together and then sent out of the DAC for analog processing.

### Oscillators

Iosefka has two identical morphing wavetable oscillators with 256 waveforms, spread out over a 16x16 grid, and can be controlled using the X Wave and Y Wave Parameters for each oscillator separately. A list of the wavetables can be viewed in the Wavetable Chart section of this document.

There are additional sound design options such as:

- Pitch modulation options:
- Frequency modulation
- Portamento (glide)
- Cross modulation options from Osc 1 to Osc 2:
- Phase modulation
- Oscillator sync

Each oscillator has additional controls for scale, tuning, and octave, allowing for a very wide range of sounds when used with or without the sound design options listed above.

Parameters (for each oscillator):

Parameter name | Function
Scale/Pitch | Scale (normal operation): Tunes the oscillator by -1 octave to ~+1 octave by semitones Pitch (holding shift and turning Potentiometer): Tunes the oscillator by -1 octave to ~+1 octave smoothly This is a Bipolar value
Octave | Choosing one of four octaves
X Wave | Select a wavetable along the X axis
Y Wave | Select a wavetable along the Y axis

Parameters (shared by both oscillators):

Parameter name | Function
Portamento | Also known as 'glide' - the amount of time it takes for one note to slide to the next when played
Phase Mod (Phase Modulation) | Phase modulation where Osc 1 is modulator and Osc 2 is carrier
Sync | Oscillator sync where Osc 2 resets whenever Osc 1 completes a cycle
Parameters (shared by both oscillators and noise generator)

Parameter name | Function
SRR (Sample-rate Reduction)
BRR (Bit-rate Reduction)
### Noise Generator

Along with the oscillators, there is a white noise generator.

Parameters:

none

### Mixer

Both oscillators and noise generator are fed into the mixer, which controls the level of each of the three, before leaving the digital domain for the filter.

Parameters:

Parameter name | Function
Mix 1 | Level of Oscillator 1
Mix 2 | Level of Oscillator 2
Mix Noise | Level of Noise Generator

### Digital Delay

The post-VCA output of Iosefka feeds back into a 12-bit ADC, sampled at 48khz, which is then used as a digital delay. The digital delay can be given extremely short (~3ms) for interesting sound sculpting, or much longer (~683ms) for a more traditional delay effect.

The digital delay's audio is produced by a separate DAC and is then mixed back into the VCA output.

Parameters:

Parameter name | Function
D. Level (Delay Level) | Volume of the delay
D. Rate (Delay Rate) | Amount of time between delay input and output.
D. Fdbk (Delay Feedback) | Amount of delay fed back into itself
D. Type (Delay Type) | Select between the following: - 00 - Unclocked delay between ~3ms to ~683ms - 01 - Clocked delay - Multiple divisions of sequencer or MIDI clock. Note that the clocked delay cannot exceed the delay buffer length of ~683ms. Clocked intervals above this will be shorter, and not clock accurate. - 02 - Short delay - ~3ms to ~95ms. See the Fun with Short Delays section below for things you can do with this type - 03 - Unclocked delay - You read that right, 00 and 03 are the same thing!
D. Input (Delay Input) | Level of the delay input

#### Fun with Short Delays

You can build the following delay based effects using the short delay and different modulation types:

- Flanger - Set a very short delay time with high feedback and LFO on Delay Rate
- Chorus - Set a medium delay time with lower feedback and an LFO on the delay rate (set the LFO depth a bit lower)
- Comb Filter/Karplus Strong-like effects - Set the Delay Rate to C0, and assign the Note Modulation Source to Delay Rate. This will, by design, track the notes on the keyboard and play musically, but due to limitations in the delay feedback and the rubber banding effect of changing delay rates, it's not a 1:1 recreation of these effects.

## Analog Audio

### Filter

The heart of the analog filter is the Sound Semiconductor V2140 chip. It is an OTA based pole mixing filter producing a very clean and controlled sound. The filter cutoff has its own Parameter for key tracking, which the filter is capable of doing easily across 5+ octaves.

The filter is configurable between four types:

- 2-pole low pass
- 4-pole low pass
- 2-pole high pass
- 2-pole band pass

The resonance of this filter has been tweaked to get just-very-loud-enough to where one should find themselves find themselves satisfied in case they want to go a little overboard.

The filter output is then fed back into the filter cutoff CV path for audio-rate frequency modulation with a Parameter to control the intensity of the modulation applied. In moderate amounts, this adds an almost overdrive or distortion to the sound. In high amounts, and at high resonance, this becomes absolute audio chaos, if you're into that sort of thing. When the Parameter is turned all the way down, the frequency modulation is not applied and therefore not audible.

Envelope 2 is hard-wired to the filter cutoff, and there is a Parameter dedicated to bipolar envelope amount.

Parameters:

Parameter name | Function
Cutoff | The point at which frequencies begin to become attenuated
Resonance | The amount of emphasis given to the audio at the cutoff point
F. Env. Level (Filter Envelope Level) | How much of Envelope 2 is applied to the filter cutoff amount. This is a Bipolar value Note: Holding shift and turning the Potentiometer will snap this Parameter to 0x80. This is a quick way to turn the modulation 'off'
F. Type (Filter Type) | Selecting between the four filter types: 2 Pole Low Pass 4 Pole Low Pass 2 Pole High Pass 2 Pole Band Pass
F. FM (Filter Frequency Modulation) | The amount of audio rate modulation fed from the filter output back into the filter cutoff
F. Track (Filter Tracking) | The amount of note tracking applied to the filter. When turned up all the way, the filter can be played just like an oscillator.

### Amplifier

The voltage controlled amplifier is based around the venerable LM13700 dual OTA chip. The amplifier provides a linear response with a 'vintage' sound.

It can be configured to a 'drone' mode where the amplifier is opened partially (allowing for amplitude modulation effects), or all the way, providing the full volume of the filter output.

Parameters:

Parameter name | Function
VCA | Controls how much the filter output is attenuated.

### External Input

External audio can be fed into the external input in the back of the synthesizer, allowing for line level signals to be processed by both the analog audio block (filter and VCA) and also the digital delay.

Note: The external audio will only be heard when the VCA is open, so to hear the external audio, the synthesizer must be actively playing notes, or the VCA must be in drone mode. To that end, to use Iosefka purely as an analog/digital processor, here are some suggestions:

- Put the VCA in drone mode
- Turn down Mix 1, Mix 2, and Mix noise
- Now you should be hearing only the external input playing, allowing you to process audio with the filter, amplitude modulation, and the delay effects

Note: The gain of the external input is fixed, so the audio level fed into the input must be adjusted externally.

Parameters (none)

## Modulation Sources

All synthesizer Parameters are modulatable using the modulation sources on Iosefka (and then some!). Sequencer Layer Parameters cannot be modulated via the mod sources, but the LFOs are syncable to the internal and external clock, so there's that!

Here is a list of the Modulation Destinations.

### Envelopes

Three ADSR envelopes with responses from snappy during short durations to long arcing response times when turned up.

All three envelopes are freely assignable to any modulation destination. Additionally, Envelope 2 is hard-wired to the Filter Cutoff, and Envelope 3 is hard-wired to the VCA.

As an example, if Envelope 2's destination is set to Mix Noise, it shares the Attack, Decay, Sustain, and Release time of the filter envelope, but the envelope amount for Mix Noise is independent of the envelope amount for Filter Cutoff. The same applies for Envelope 3.

Parameters:

(These Parameters apply to all 3 Envelopes)

Parameter name | Function
Attack | Envelope onset time
Decay ( + Loop) | The amount of time from the end of the attack phase to settle into the sustain phase Holding Shift switch and turning the Potentiometer will enable the Looping Envelope, causing the envelope to begin the Attack phase as soon as it finishes the Release phase.
Sustain | The volume of the note as it is held (following the attack and decay phase)
Release | The amount of time until the volume fades to 0 after a Note-Off event happens
- Level + | Bipolar Parameter level control allowing for non-inverted or inverted LFO modulation. This is a Bipolar value Holding Shift switch and turning the Potentiometer will snap this Parameter to 0x80. This is a quick way to turn the modulation 'off'

### LFOs (Low Frequency Oscillators)

Three LFOs with a variety of waveforms. The LFOs can all independently be synced to the sequencer clock, as well as reset during Note-On messages.

The LFO modulation itself is bipolar, meaning that the value of the Modulation Destination will swing above and below the Parameter value at an equal depth. For example, let's say the Portamento Parameter was turned up to "80" on the OLED Display and you applied the LFO to Portamento, turning the "- Level +" up to "C0". This means that the LFO is ranging from "80 - 40" to "80 + 40".

Parameters:

(These Parameters apply to all 3 LFOs)

Parameter name | Function
Rate | The speed of the LFO's oscillation. When the LFO is synced to the Sequencer Clock, this Parameter becomes a time-division of the clock
Shape | The shape of the LFO wave: triangle, saw, square, sine, and sample-hold
Phase | The offset of the wave, control where the wave begins and ends
Reset/Sync | This Parameter controls whether LFO Reset and/or Sync are turned on. When Reset is on, the LFO restarts whenever a Note-On event happens
- Level + | Bipolar Parameter level control allowing for non-inverted or inverted LFO modulation. This is a Bipolar value Note: Holding shift and turning the Potentiometer will snap this Parameter to 0x80. This is a quick way to turn the modulation 'off'

### Selecting Envelope and LFO modulation destinations

When in the Envelope View or LFO View, pressing the respective View switch repeatedly will cycle through the Mode for that mod source's destination.

For example, in the Envelope View, pressing the Envelope Key switch will highlight the number on the left hand side of the OLED Display, indicating which Envelope number's modulation destination is selectable.

You can then use the Data Rotary Encoder to select the Modulation Destination.

#### Velocity

Velocity is a control of how much of a Parameter is applied depending on how 'hard' a note was hit. This effect emulates the way that a piano key is louder the harder it is pressed. Most modern keyboards have a velocity control. The sequencer also has a velocity Parameter.

Velocity controls two Parameters: The VCA, and one freely selectable Modulation Destination.

Parameters:

None

#### Mod Wheel

Along with Velocity controls, most modern MIDI controllers have a Mod Wheel. Mod wheel is only controllable via MIDI.

Parameters:

None

#### Aftertouch

Aftertouch allows you to control a Modulation Destination with the pressure applied to the key after it has been pressed. Consult your favorite MIDI controller's manual to learn more!

Parameters:

None

#### Note

The amount of modulation is set depending on which note is being played. The higher the note, the greater the modulation. This can be reversed with the "note mod" setting in the Settings menu.

Parameters:

- Note + or - (in the settings menu) controls the bipolar behavior of the Note Modulation Source. This is set in the Settings Menu:
- Note +: controls the Modulation Destination positively, higher notes is a higher parameter value and vice versa.
- Note -: controls the Modulation Destination negatively, higher notes is a lower parameter value and vice versa.

#### Breath Control

For those with MIDI wind controllers, breath control is a Modulation Source. As of the writing of this manual, I've never seen anyone use one in person, but I hope that changes some day!

#### Pitch Bend

Pitch Bend is a MIDI controllable effect which applies exclusively to the pitch of Oscillator 1 and Oscillator 2. You can adjust the Pitch Bend Depth from the Settings View with a range of 1 to 12 semitones.

Parameters:

None

# The Sequencer

Iosefka contains a 32 step sequencer with an emphasis on live performance, allowing for precise input, or automatically generated Patterns.

A Pattern is the current arrangement of steps in the sequencer. Every Preset has its own pattern.

The sequencer has a range from 30 to 300 BPM (beats per minute) and operates at 24 PPQ (parts per quarternote) to match incoming MIDI clock ticks.

## Sequencer Parameters

These are the Parameters available in the Sequencer View, specifically the Sequencer Layer.

Parameter name | Function
Note | - Generator off: Controls the note that is set when Enabling a step - Generator on: Sets the base note of the generated sequence - Parameter lock: Changes the current selected step note
Octave | - Generator off: Controls the octave of the note set when Enabling a step - Generator on: Sets the base octave of the generated sequence - Parameter lock: Changes the current selected step octave
Scale | The musical mode generated by the Generator - ma - Major scale - mi - Minor scale
Length | - Normal operation: Controls the length of the next enabled step note - Parameter lock: Changes the current selected step length*
Velocity | - Normal operation: Controls the velocity of the next enabled step - Parameter lock: Changes the current selected step velocity
Transpose | Musically adjusts the notes played in the sequence by -12 to +12 semitones. Note: This is a bipolar value, but displays with negative and positive hex values, ranging from -C (meaning -12) to +C ( meaning +12) Note: Holding Shift key will snap this Parameter to -C, 0, or +C depending on Potentiometer position, intended for performance purposes
Direction | Sets the direction that the sequence plays from the first note to the last note as such: - fw - Forward, notes play from first note to last note, then repeat - bw - Backward, notes play from last note to first note, then repeat - p1 - Ping pong 1, notes play from first note to last note, then reverse direction, repeat - p2 - Ping pong 2, notes play from first note to last note, then reverse direction, repeat, but the first and last note play twice. With this setting, sequences play an even number of steps forward and backward.
Swing | Sets the rhythmic swing, dividing the 12 clock ticks between every two halfnotes: - 00 - No swing, each first and second quarternote have a 1:1 ratio of clock ticks - 01 - Light swing, each first and second quarternote have a 7:5 ratio of clock ticks - 02 - Medium swing, each first and second quarternote have a 2:1 ratio of clock ticks - 03 - Heavy swing, each first and second quarternote have a 3:1 ratio of clock ticks
Clock Div. | Multiplies or divides the number of ticks per quarternote, making the sequence slower or faster: - *8 - Sequence is 8 times slower - *4 - Sequence is 4 times slower - *2 - Sequence is 2 times slower - *d - Sequence is 1.5 times slower - /1 - Sequence is normal speed - /2 - Sequence is twice as fast
First Step | Selects the first step of the 32 steps played by the sequencer When a Pattern is automatically generated, the generated Pattern will start and this step and end at the Last Step Parameter Cannot exceed the step selected by the Last Step Parameter.*
Last Step | Selects the last step of the 32 steps played by the sequencer. When a Pattern is automatically generated, the generated Pattern will start and this step and end at the First Step Parameter Cannot precede the step selected by the First Step Parameter*
Probability | - Normal Operation: Each step, a random number between 00 and FF is generated. If the Probability value is greater than this random number, and this step is active, the step plays. Higher number = greater chance an active step is triggered - Parameter Lock: If the parameter locked Probability value is 00, the probability will be set to whatever the Normal Operation probability is set to. If the Parameter Locked Probability is "01" - FF, this will be the probability for that individual step.
G. Chance | When a Pattern is generated, a random number between 00 and FF is generated for each step. If the G. Chance value is greater than this number, a step is generated. Higher number = greater number of steps generated Ignored for steps with Probability Parameter Locked above a value of 00
G. Length | The length of step notes in a generated Pattern. At 00, all notes are 1 step long. At 07, all notes are 4 steps long. Every value between 00 and 07 is a weighted preference between shorter step notes and longer step notes
G. Repeat | When the generator is on, the number of times a Pattern repeats before a new Pattern is generated. Note that this value is displayed as Hexadecimal
G. Octave | Similar to G. Length, this selects the octave range from the Octave parameter based on a weighted table

*Values are displayed in Decimal from "01" through "32"

## Programming Patterns

### Step Data

Each of the 32 Steps in the sequencer contain their own configurable Parameters, as shown in the Parameter list above. These are:

- Note (including octave)
- Length
- Velocity
- Parameter Lock Destination
- Parameter Lock Value
- Active
- Enabled

Each time a step occurs, the step will behave based on the combination of all of these values. The values can either be set manually by changing the Parameters using the Potentiometers before and manually programming the step, or the values will be automatically set for all notes when a Pattern is automatically generated.

#### Step Play States

Every step can be in one of three Play States:

- Step On - This step will play (if it passes a Probability check)
- Step Mute - This step will not play, but contains Step Data
- Step Off - This step will not play, and there is no Step Data

### Manual Programming

With the Seq Page active, a Pattern can be readily programmed into Iosefka's Sequencer.

#### Setting Step Play States with 1 - 8 Key Switches

The 1 - 8 Key switches set the Play State of each respective step according to the current Step Section. The action taken by said switches is as follows:

- If Step Off, pressing the Key switch will put the step into the Step On state. The step will adopt the Step Data determined by the Sequencer Parameters
- If Step On, pressing the Key switch will put the step into the Step Mute state. The Step Data is retained
- If Step Mute, pressing the Key switch will put the step into the Step On state
- If the Step On or Step Mute, pressing the Shift switch and the Key switch will put the step into the Step Off state, erasing Step Data

#### Step Sections

Eight steps can be programmed at a time using the 1 - 8 Key switches while on the Seq Page. To select which 8 steps can be programmed, you must toggle through the four Sections using the Section Up and Section Down Key switches. The white horizontal line above steps 1 - 16, and below steps 17 - 32, display which section of 8 steps is currently programmable.

With the white line in this position, the 1 - 8 Key switches program steps 1 - 8.

With the white line in this position, the 1 - 8 Key switches program steps 24 - 32.

### Live Step Recording

Hold the Shift Switch and press the Play Switch to enter Step Record. A metronome will play and a record icon will appear on the OLED Display.

While Step Record is active, entering notes via the Key Switches, or notes entered via MIDI input will be recorded into the sequencer. Entered steps will replace existing Steps on the same Step number.

The Sequencer Direction will also be set to FORWARD when enabling Step Record. If the Sequencer Direction is set to any other direction, it must manually be set back to the original Direction after exiting Step Record. Like in normal operation, the sequencer will loop from the first step to the last step.

Press Play again to exit Step Record.

Note that delay effects will cease while Step Record is active, but will be enabled when exiting Step Record.

### Generative Programming

When a Pattern is generated, it will erase and rewrite over all steps within the First Step and Last Step Parameters (Be mindful when using the generator as to not erase Patterns you want to keep!) The pattern is randomly generated, but within the bounds of the Sequencer Parameters relating to the Generator.

When generating a new pattern, the Step Probability and Parameter Locks are maintained for all generated Steps. Steps containing Step Probability above a value of 0 will be generated as Active Steps.

#### Running Generation

Running generation will occur as long as the Generator is 'On'. This is set using the Generator On/Off Key Switch, and is visually indicated by the "Gen" icon in the top-right of the OLED Display while in the Sequencer View.

The G. Repeat Parameter determines the number of times a Pattern plays before a new pattern is generated. The remaining number of repeats before a Pattern is Generated can be seen at the top left of the OLED Display when in the Sequencer View.

Oh no, the Generator created a killer pattern that I want to keep but it's going to be erased after this final repeat!!! Fret not. Turning the Generator off by pressing the Generator On/Off Key switch will prevent automatic rewriting of the pattern.

#### Immediate Generation

Pressing the Generate New Key switch will immediately generate a new pattern regardless of the state of the Generator, number of repeats remaining, etc.

### Parameter Locking

Step Data can be adjusted for steps that are already set using Parameter Locking. Press and hold one or more of the 1 - 8 Key switches corresponding to the step in the desired Step Section. In the OLED Display, you will see several Parameters light up, indicating the Step Data Parameters that are Parameter Lock-able.

#### Parameter Locks of Synth Parameters

A single synthesizer parameter can be applied per-step. The previous step's Parameter Lock will be canceled by the one for the next step.

To set the synthesizer Parameter Lock parameter, use Layer Decoupling on the layer with the parameter you'd like to lock like so: - Layer Decouple to the layer with the parameter you will be locking - Press and hold a step, then change the parameter

#### Removing Parameter Locks

To remove the parameter lock for any step: While on the Sequencer Layer hold the 1 - 8 Key Switch that contains the parameter lock you want to erase, and turn any Potentiometer whose corresponding parameter isn't lit on the OLED Display. Specifically these are the following: Transpose, Direction, Swing, Clock Div, First Step, Last Step, G. Chance, G. Length, G. Repeat, and G. Octave.

### Additional features

#### Section jumping

By holding the Shift switch and pressing the Section Up and Section Down Key switches, you are able to shift the first and last steps by the count of the overall pattern length. This allows you to play different sections as if they were different parts of a song.

For example, if your first step is step 1, and your last step is step 8 (making a pattern length of 8), by pressing the Shift switch and the Section Up Key switch, the first step becomes 9 and the last step becomes 16.

Section jumping is designed to maintain the relative note in the sequence, so your song doesn't 'break' if you section jump mid-pattern.

We are limited to the 32 steps of the sequencer, so we can only section jump in pattern lengths of 16 or less. I could describe how this works exhaustively, but just play around with this feature and you'll see what it can/can't do.

#### Pattern Rotation

By holding the Copy Switch and pressing the Section - or Section + Switches, you can rotate the steps in the pattern from the First Step to the Last Step.

If the First Step is Step 1, and the Last Step is Step 8 (for example), a Pattern Rotation using the Copy Switch and the Section + Switch will shift all Step Data forward by one Step, and replace the First Step with the Last Step. Vice Versa if pressing the Section - Switch. All other steps will not be rotated.

If the First Step is Step 1, the Last Step is Step 32, and the Switches mentioned above are pressed, the entire pattern will rotate in the respective direction.

#### Pattern Clear

Holding the Shift Switch and pressing the Gen New Switch will clear the entire pattern, erasing all steps and associated Probability and Parameter Lock data.

#### Step Copy

By holding the Key Switch for any step and pressing the Copy Switch, the Step Data will be copied to the Sequencer Parameters (excluding Probability and Parameter Lock data), so that the next written step will have the copied step's Note, Velocity, and Length.

Specifically, when you execute a step copy, you will see the data of the copied Step in the Sequencer Layer parameters. There's no clipboard or paste function.

# Settings

To navigate to the Settings View, hold the Shift switch and press the Sequencer switch.

The Settings View allows for the configuration of global and preset-specific settings. From here, you can control the processing of MIDI messages, set patch-specific controls, initialize a preset, and enable the Oscilloscope.

This section describes the different settings in the Settings menu and how to control them. For this section it is assumed that you are in the settings menu.

### List of Parametric Settings

This table contains the settings within the settings menu, a short description, the default value, and whether the parameter is Global (affects all presets) or Preset Specific.

Note: Global settings are saved when Saving a Preset.

Links are included to sections with more in-depth descriptions.

Setting | Description | Default value | Global or Preset Specific
Preset Number | Select the preset number that will be loaded or saved to | 1 | Global
Preset Name | Where the preset name is displayed and edited | The name of Preset 1 | Global
Channel | Selects the MIDI channel that Iosefka will receive messages from.* | 1 | Global
Src: | Select the MIDI Modulation source here to select the Modulation Destination setting below will affect.** | Velo | Preset
Mod Destination | Select the Modulation Destination that the Modulation Source above affects** | None | Preset
Legato | Toggles Legato on/off. With legato on, envelopes are not retriggered when new notes are pressed | On | Preset
Osc Duo | Toggles Osc Duo on/off. This is a paraphonic mode, giving the ability to play a separate note with each oscillator | Off | Preset
VCA Velo | Toggles VCA Velocity on/off. Turning this setting off decouples the Velocity Mod Source from the VCA, so any entered notes will always be at full Velocity | On | Preset
Clock RX | Toggles MIDI Clock Receive on/off. With this setting off, Iosefka will ignore external clock messages and run only on the internal sequencer clock* | On | Global
Trnsprt RX | Toggles MIDI Transport messages on/off. With this setting off, Iosefka will ignore external Play and Stop MIDI messages* | On | Global
Pgm Chg RX | Toggles MIDI Program Change Receive on/off. With this setting off, Iosefka will ignore external Program Change messages* | On | Global
Latch | Toggles Parameter Latch on/off. With Latch enabled, Parameters will not change until the corresponding Potentiometer is near the parameter value. This prevents a parameter from 'jumping' to a value drastically different than the current value | Off | Global
P.B. Dpth | Selects the Pitch Bend Depth in musical semitones. The value set will be +/- this number. For example, a setting of '1' means that the pitch bend will be +1 and -1 semitones at the extremes | 1 | Global
Rec Click | Toggles the click on/off when Live Step Recording into the sequencer | Off | Global
Scope | Switches OLED Display to Oscilloscope | N/A | N/A
Init (Shift) | When shift is held, this setting initializes the preset to the 'factory' default. This is the default preset for all presets. | N/A | Preset

* More information can be found in the MIDI Implementation section ** A list of Mod Destinations can be found in the Modulation Destinations section

### Using the Settings menu

When first visiting the Settings menu after starting up the machine, the Data rotary encoder is in the Settings Scroll Mode which controls scrolling through the Settings menu items, indicated by the circle icon on the left of the OLED Display. Pressing down on the Data rotary encoder switch, does different things depending on the setting:

- For settings with numbers or text to the right, the Data rotary encoder now switches Modes and increments/decrements the value of the setting. Horizontal parallel lines will appear above and below the setting name to indicate that the setting is being edited.
- To return to the Settings Scroll Mode, click the Data rotary encoder switch again.
- For settings related to Presets, and settings related to Mod Source/Destination, the horizontal lines will encompass two lines, indicating that those settings are related. The selected setting is indicated by the circle icon on the left.
- For settings with square checkboxes, the Data rotary encoder switch will toggle that item on and off.
- Some Settings menu items such as the Preset Name entry, enabling the Oscilloscope, and Initializing a Preset have slightly different control types. Those will be explained in their own sections.

To minimize redundancy, in the rest of the Settings section, the term "scroll to and select" will be used to describe scrolling to the menu item while in Settings Scroll Mode and selecting the setting using the Data rotary encoder switch.

### Presets

Iosefka contains 64 presets which allow for the saving of every machine Parameter, including sequencer Parameters and steps.

#### Selecting a preset

To save or load a preset of your choice, scroll to and select "preset" or press the Preset Key Switch which enables the Preset Mode ("preset" will be outlined as in the picture below), and turn the Data rotary encoder to the preset number of your choosing.

The currently loaded preset is indicated by a ">>" next to the name "preset".

Note that the preset number is in decimal not hexadecimal.

#### Saving a Preset

With the preset number that you wish to save selected, ready the save state of the machine by pressing the Save Key switch. This brings up the following screen on the OLED Display.

Screen Save

If you are certain that you are ready to save, execute the save by holding the Shift switch and pressing the Save Key switch again. The machine confirms that the preset has been saved with this screen.

Screen Save Complete

#### Loading a Preset

With the preset number that you wish to load selected, ready the load state of the machine by pressing the Load Key switch. This brings up the Load screen on the OLED Display (same screen in as Saving a Preset, but 'save' is replaced with 'load').

If you are certain that you are ready to load, execute the load by holding the Shift switch and pressing the Load Key switch again. The machine confirms that the preset has been loaded with this screen.

#### Editing the Preset name

Each preset can have an 8 character name which is loaded on startup and can be seen when selecting a preset.

Navigate to and select the row beneath "preset". This row will be blank if no preset name has been entered. A highlighted square will appear, and you can select the alphanumeric character with the Data rotary encoder. For ease of use, only lowercase letters, numbers, and "." "-" characters will appear.

To move to the next character, hold the Shift Switch and turn the Data rotary encoder. Do this multiple times to scan through multiple characters. To save the Preset name, you must save the Preset.

# Supplemental Information

## View Charts

These charts represent the default Layers, Pages, and Modes upon device startup. These three can be changed depending on the View, and sometimes persist beyond View changes. For example, if the Mode is changed in the Settings View, that mode will persist when leaving and returning to the Settings View.

View Name | Accessing this View | Layers | Pages | Modes
Synth 1 | Synth 1 View switch_* | Synth 1 | Kbd | kbd oct (Keyboard Octave)
Synth 2 | Synth 2/User View switch | Synth 2 | Kbd | kbd oct (Keyboard Octave)
User | Shift switch + Synth 2/User View switch | User | Kbd | kbd oct (Keyboard Octave)
Envelope | Envelope View switch | Envelope | Kbd | Envelope 1, 2, 3
LFO | LFO View switch | LFO | Kbd | LFO 1, 2, 3
Sequencer | Sequencer View switch | Sequencer | Seq | seq bpm (Sequencer BPM)
Settings | Shift switch + Sequencer View switch | N/A** | Set

*Hitting this switch multiple times toggles between Synth 1 View and Synth Env View. Whichever View was active when leaving the View by hitting another View switch will be the view that is active when hitting the Synth 1/Synth Env View switch again. Iosefka always starts up in Synth 1 View.

** When in the Settings View, the most recent layer from the previous view remains active.

## Page Switch Function Chart

### Kbd

Key switch | Function
All Key switches | 1 octave + 1 note, in the layout of a piano keyboard

### Seq

Key switch | Function
Section - | Jogs through the Step Sections counting down in steps. If the Shift Switch is held, a Section Jump downward occurs. If the Copy Switch is held, a
Section + | Jogs through the Step Sections counting down
Generator On/Off | Enables/Disables the Generator for Running Generation
Generate New | Generates a Pattern via Immediate Generation
1 - 8 | Programs the step corresponding to the current Step Section See Manual Programming subsection for an in-depth description of using these switches to program a Pattern in the Sequencer

### Set

Key switch | Function
Save | - Pressing once readies the Save state - Pressing Shift key plus Save Key switch while in Save state saves to the current preset
Load | - Pressing once readies the Load state - Pressing Shift key plus Save Key switch while in Load state saves to the current preset
Preset | Sets the Mode to Preset Select
Channel Select | Sets the Mode to Channel Select
Velocity Dst. | Sets the Mode to Velocity Destination Select
Mod Wheel Dst. | Sets the Mode to Mod Wheel Destination Select
Aftertouch Dst. | Sets the Mode to Aftertouch Destination Select
Clock Rx | Enables Clock Receive from the input MIDI source
Transport Rx | Enables Transport Receive from the input MIDI source
Pitch Bend Depth | Sets the Mode to Pitch Bend Depth Select
Param Latch | Toggles the Parameter Latch function on/off. See the List of Parametric Settings

## Layer Parameter Control Chart

In the photos below, the text for each parameter below the Potentiometer is highlighted respective to the current layer.

See "Parameters" sections in The Synthesizer and The Sequencer for in-depth explanations on these Parameters

### Synth 1

Layer_Synth1

Note/Pitch (Oscillator 1) | Note/Pitch (Oscillator 2) | Portamento | Mix 1, shift = VCA | Cutoff
X Wave (Oscillator 1) | X Wave (Oscillator 2) | Phase Mod | Mix 2 | Resonance
Y Wave (Oscillator 1) | Y Wave (Oscillator 2) | Osc Sync | Mix Noise | F. Env. Level

### Synth 2

Layer_Synth2

Octave (Oscillator 1) | Octave (Oscillator 2) | D. Level | F. Type | Cutoff
SRR | D. Type | D. Rate | F. FM | Resonance
BRR | D. Input | D. Fdbk | F. Track | F. Env. Level

### User

See User Parameters section for how to access and set User Parameters.

Layer_User

### Envelope

Layer_Env

Attack (Envelope 1) | Decay, Shift = Loop (Envelope 1) | Sustain (Envelope 1) | Release (Envelope 1) | - Level + (Envelope 1)
Attack (Envelope 2) | Decay, Shift = Loop (Envelope 2) | Sustain (Envelope 2) | Release (Envelope 2) | - Level + (Envelope 2)
Attack (Envelope 3) | Decay, Shift = Loop (Envelope 3) | Sustain (Envelope 3) | Release (Envelope 3) | - Level + (Envelope 3)

### LFO

Layer_LFO

Rate (LFO 1) | Shape (LFO 1) | Phase (LFO 1) | Reset/Sync (LFO 1) | - Level + (LFO 1)
Rate (LFO 2) | Shape (LFO 2) | Phase (LFO 2) | Reset/Sync (LFO 2) | - Level + (LFO 2)
Rate (LFO 3) | Shape (LFO 3) | Phase (LFO 3) | Reset/Sync (LFO 3) | - Level + (LFO 3)

### Sequencer

Layer_Seq

Note | Octave/Scale | Length | Velocity | Transpose
Direction | Swing | Clock Div. | First Step | Last Step
Probability | G. Chance | G. Length | G. Repeat | G. Octave

## Mode Encoder Data List

### kbd oct (Keyboard Octave)

Sets octave played the Key switches on the Kbd Page in a five octave range from 2 - 7.

Why 2 - 7 and not 0 - 9 for more octaves? This is so that the Synthesizer Octave Parameters are still useful.

### seq bpm (Sequencer BPM)

Sets the Sequencer speed from 30 - 300 BPM (beats per minute).

### preset (Preset Number)

Selects from the 64 presets on Iosefka. Note that the number counts from 1 - 64, note hexadecimal.

### channel (MIDI Channel)

Selects from MIDI channel 1 - 16.

Incoming MIDI messages such as Note On, Note Off, Velocity, CC, Mod Wheel, Aftertouch, which are sent to this channel will take effect according to machine settings. All messages of those types on other channels will be ignored.

### Modulation Destination Modes

In these Modes, the Data rotary encoder is used to select the Modulation Destination assigned to the respective Modulation Source.

The options are the same for every Mode below, as all modulation sources have access to all modulation destinations.

#### Mod Destination Jump

When selecting a Mod Destination for a Mod Source, there are dozens to choose from. The destinations have been grouped in the UI to be relevant to which erm... 'module' the Mod Destination is a part of.

When Pressing and Holding the Encoder Switch while turning the Rotary Encoder, the selected Mod Destination will jump to the first parameter per each group of relevant parameters, for easier navigation of the Mod Destinations. The below table shows the Mod Destinations jumped to when performing this action.

none

oscs pitch c

osc 1 pitch c

osc 2 pitch c

portamento

mixer osc 1

filter cutoff

vca

delay rate

env 1 rate

env 2 rate

env 3 rate

lfo 1 rate

lfo 2 rate

lfo 3 rate

#### Envelope 1, 2, 3

For the Envelopes. To see how to select these modes, refer to the Selecting Envelope and LFO modulation destinations section.

#### LFO 1, 2, 3

For the LFOs. To see how to select these modes, refer to the Selecting Envelope and LFO modulation destinations section.

#### vel (Velocity)

For Velocity from both the Sequencer steps and the incoming MIDI notes

#### m.w. (Mod Wheel)

For Mod Wheel messages coming from the MIDI input

#### a.t. (Aftertouch)

For Channel Aftertouch messages coming from the MIDI input

## User Parameters

For performance, and overall ease of use, users are able to assign fifteen synthesizer parameters on the User Parameter Layer. Every Preset can have its own user parameters.

By default, there are user parameters that are already set. These are parameters that require the use of the Shift Switch on their respective layers. The Potentiometer assigned to these default User Parameters are: - 12: Envelope 1 Loop - 13: Envelope 2 Loop - 14: Envelope 3 Loop - 15: VCA Level

Note: Sequencer parameters cannot be set as user parameters.

#### Navigating to User Parameters View

Navigate to the User Parameter Layer by holding the Shift switch and pressing the Synth 2 switch.

#### Selecting the Potentiometer the User Parameter is assigned to

Select the Potentiometer which will be assigned a parameter by holding the Shift switch and turning the Data rotary encoder. A box will be drawn around the currently selected parameter.

#### Selecting the User Parameter

From here, turning the Data rotary encoder selects the parameter which can be assigned. The parameter value of the current preset will be shown. Note: Changing the parameter value here will change the value on the respective layer and vice versa.

Some parameters cannot be assigned, and are indicated by a "--" in place of the parameter value when that parameter is selected. This is how all parameters appear on a new Preset.

## Layer Decoupling

Using Layer Decoupling, you can do like the following: - Enter synthesizer parameter locks to sequencer steps - Live step record while tweaking Sequencer parameters

To do this: - Press and hold the View Switch of the layer you'd like to maintain - Press the View Switch of the Page and Mode you'd like to use

For example, press and hold the Synth 1 View Switch, then press the Seq View Switch. You will see the Seq Page LED light up and the Sequencer BPM Mode Hanging Display.

## Wavetable Chart

Below is a chart of wavetables in Iosefka. The wavetables are represented by X values horizontally and Y values vertically, meaning that when you turn the X Wave Potentiometer, you are scanning the chart below from left to right, and when you turn the Y Wave Potentiometer, you are scanning the table from top to bottom.

The wavetables are arranged in the machine such that each Y value wavetable represents a different type of instrument/timbre/synthesis, and each X value is a variation of that timbre.

waves_cropped

The wavetables represented by the chart above:

1. Metallized saw wave (1-8), notched saw wave (9-16)
2. Metallized square wave (1-8), PWM square wave (9-16)
3. Triangle wave experimentations
4. Frequency modulated sine (1-8), sine with increasing octaves (9-16)
5. Drawbar organ tones
6. Piano (1-8), e piano (9-16)
7. Clarinet (1-5), Oboe (6-10), saxophone (11-16)
8. Violin (1-8), cello (9-16)
9. Electric guitar (1-8), acoustic guitar (9-16)
10. Asst. wavetables from Mutable Instruments Plaits
11. Asst. bell sounds
12. Asst. harmonically-rich wavetables
13. Formant synthesis wavetables from Mutable Instruments Braids
14. PPG waveforms
15. Yamaha-style OPL FM chip waveforms
16. Assorted Ensoniq wavetables

A higher quality version of the chart below can be found here.

## Modulation Destinations

Destination name | Affected Parameter(s)
None | None
oscs pitch c | Both Oscillators Coarse Pitch across 8 octaves
oscs pitch f | Both Oscillators Fine Pitch across 2 semitones
oscs octave | Both Oscillators Octave
oscs x morph | Both Oscillators X Wave
oscs y morph | Both Oscillators Y Wave
osc 1 pitch c | Oscillator 1 coarse pitch across 8 octaves
osc 1 pitch f | Oscillator 1 fine pitch across 2 semitones (for vibrato like effects)
osc 1 octave | Oscillator 1 octave
osc 1 x morph | Oscillator 1 X Wave
osc 1 y morph | Oscillator 1 Y Wave
osc 2 pitch c | Oscillator 2 coarse pitch across 8 octaves
osc 2 pitch f | Oscillator 2 fine pitch across 2 semitones (for vibrato like effects)
osc 2 octave | Oscillator 2 octave
osc 2 x morph | Oscillator 2 X Wave
osc 2 y morph | Oscillator 2 Y Wave
portamento | Portamento
phase mod | Phase Modulation
sync | Oscillator sync
brr | Bit-rate Reduction
srr | Sample-rate reduction
mixer osc 1 | Oscillator 1 Mixer Level
mixer osc 2 | Oscillator 2 Mixer Level
mixer noise | Noise Generator Mixer Level
unused | Unused (for now)
filter cutoff | Filter Cutoff
filter res | Filter Resonance
filter env amt | Filter Envelope Level
filter type | Filter Type
filter fm | Filter Frequency Modulation
filter tracking | Filter Tracking
vca | VCA Level
delay rate | Delay Rate
delay feedback | Delay Feedback
delay level | Delay Level
delay type | Delay Type
delay input | Delay Input Level
env 1 attack | Envelope 1 Attack
env 1 decay | Envelope 1 Decay
env 1 sustain | Envelope 1 Sustain
env 1 release | Envelope 1 Release
env 1 level | Envelope 1 Level
env 1 loop | Envelope 1 Loop
env 1 dst | Envelope 1 Destination
env 2 attack | Envelope 2 Attack
env 2 decay | Envelope 2 Decay
env 2 sustain | Envelope 2 Sustain
env 2 release | Envelope 2 Release
env 2 level | Envelope 2 Level
env 2 loop | Envelope 2 Loop
env 2 dst | Envelope 2 Destination
env 3 attack | Envelope 3 Attack
env 3 decay | Envelope 3 Decay
env 3 sustain | Envelope 3 Sustain
env 3 release | Envelope 3 Release
env 3 level | Envelope 3 Level
env 3 loop | Envelope 3 Loop
env 3 dst | Envelope 3 Destination
lfo 1 rate | LFO 1 Rate
lfo 1 shape | LFO 1 Shape
lfo 1 phase | LFO 1 Phase
lfo 1 sync | LFO 1 Reset/Sync
lfo 1 level | LFO 1 Level
lfo 1 dst | LFO 1 Destination
lfo 2 rate | LFO 2 Rate
lfo 2 shape | LFO 2 Shape
lfo 2 phase | LFO 2 Phase
lfo 2 sync | LFO 2 Reset/Sync
lfo 2 level | LFO 2 Level
lfo 2 dst | LFO 2 Destination
lfo 3 rate | LFO 3 Rate
lfo 3 shape | LFO 3 Shape
lfo 3 phase | LFO 3 Phase
lfo 3 sync | LFO 3 Reset/Sync
lfo 3 level | LFO 3 Level
lfo 3 dst | LFO 3 Destination

## Oscilloscope

Users can view the VCA output waveform of the synthesizer using the oscilloscope. The audio is fed back into Iosefka's processor using the same buffer as the delay. The delay output is not displayed in the oscilloscope.

The oscilloscope captures the output waveform in real time and displays them to the user from one of four user selected magnifications. The magnification value shown on the OLED Display shows how zoomed in the oscilloscope is, relative to the samples captured. To best see lower notes, a value of 1x is best. To see higher notes, a value of 8x is best.

Magnification value | Sample size | Sample division (display every n samples)
1x | 1024 | 8
2x | 512 | 4
4x | 256 | 2
8x | 128 | 1

The oscilloscope is phase-locked to oscillator 1, meaning that the waveform should stay in the same place on the screen regardless of the pitch of the note that's playing. This is done by triggering a reset of the oscillator's capture window when oscillator 1's phase overflows, as indicated by the oscillator sync buffer.

The phase will not appear locked with the audio in the following scenarios: - Oscillator 1 and 2 pitch are dissonant - Oscillator 1 is low or off, and Oscillator 2 or resonant filter is the primary audio source - Oscillator 1's pitch is lower than the magnification can capture in one screen (if the waveform is 'larger' than will fit in one screen)

Only 128 discrete points are rendered for each 'frame' of the oscilloscope, meaning that harmonically rich waveforms, or viewing higher pitches on lower magnifications will make the oscilloscope appear more 'broken up'. While the solution would be to draw a line between each discrete point, this is not possible due to processor limitations. I tried folks.

## Initializing All Presets

When you initialize all presets you are permanently overwriting the EEPROM to reset all presets and settings to their factory default.

If you have just built a Iosefka, this step is necessary to format the EEPROM.

### How to

With the device powered OFF (with power unplugged), hold down the following Switches:

- Play Switch
- Synth 1 Switch
- Envelope Switch
- Sequencer Switch

With these Switches pressed, power the device on. You will see a screen on the OLED Display that says "writing new presets. please wait" with a counter of the currently written preset.

Once this process is complete, you will be brought to the Synth 1 Page, and all Parameters will be set to default.

# MIDI Implementation

## MIDI Input

### MIDI Rx Messages

Message Type | Description
Clock | Receives 24 PPQ MIDI clock to sync with Sequencer and other clock-dependent systems
Transport Start | Starts the Sequencer (same function as pressing the Play switch when Sequencer is OFF)
Transport Stop | Stops the Sequencer (same function as pressing the Play switch when Sequencer is ON)
Program Change | Loads the selected Preset* (limited to number of Presets on Iosefka)
CC (Continuous Controller) | Changes the specified parameter on the device* (See MIDI CC (Continuous Controller) chart)
Pitch Bend | Adjusts the oscillator pitch according to the amount of bend applied*

*Iosefka must be set to the same MIDI Channel as the transmitting device for these messages to be received

### MIDI CC (Continuous Controller) chart

CC Number | Parameter
1 | Mod Wheel
2 | Breath Control
10 | Pitch (Oscillator 1)
11 | Octave (Oscillator 1)
12 | X Wave (Oscillator 1)
13 | Y Wave (Oscillator 1)
14 | Pitch (Oscillator 2)
15 | Octave (Oscillator 2)
16 | X Wave (Oscillator 2)
17 | Y Wave (Oscillator 2)
5 | Portamento
18 | Phase Modulation
19 | Oscillator Sync
20 | Mix 1 (Oscillator 1 Mixer Level)
21 | Mix 2 (Oscillator 2 Mixer Level)
22 | Mix Noise (Noise Generator Mixer Level)
74 | Filter Cutoff
71 | Filter Resonance
72 | Filter Type
73 | Filter FM
76 | Filter Tracking
75 | Filter Envelope Level
25 | Attack (Envelope 1)
26 | Decay (Envelope 1)
27 | Sustain (Envelope 1)
28 | Release (Envelope 1)
29 | Modulation Level (Envelope 1)
30 | Attack (Envelope 2)
31 | Decay (Envelope 2)
32 | Sustain (Envelope 2)
33 | Release (Envelope 2)
34 | Modulation Level (Envelope 2)
35 | Attack (Envelope 3)
36 | Decay (Envelope 3)
37 | Sustain (Envelope 3)
38 | Release (Envelope 3)
39 | Modulation Level (Envelope 3)
40 | Rate (LFO 1)
41 | Shape (LFO 1)
42 | Phase (LFO 1)
43 | Reset/Sync (LFO 1)
44 | Modulation Level (LFO 1)
45 | Rate (LFO 2)
46 | Shape (LFO 2)
47 | Phase (LFO 2)
48 | Reset/Sync (LFO 2)
49 | Modulation Level (LFO 2)
50 | Rate (LFO 3)
51 | Shape (LFO 3)
52 | Phase (LFO 3)
53 | Reset/Sync (LFO 3)
54 | Modulation Level (LFO 3)
55 | Modulation Destination (Envelope 1)
56 | Modulation Destination (Envelope 2)
57 | Modulation Destination (Envelope 3)
58 | Modulation Destination (LFO 1)
59 | Modulation Destination (LFO 2)
60 | Modulation Destination (LFO 3)
61 | Delay Rate
62 | Delay Feedback
63 | Delay Level
64 | Delay Type
65 | Delay Input Level
85 | Bitrate Reduction
86 | Samplerate Reduction
87 | VCA level (Drone mode on above 1)
88 | Loop (Envelope 1)
89 | Loop (Envelope 2)
90 | Loop (Envelope 3)
## MIDI Output

Iosefka is capable of transmitting the following messages via the MIDI Output jack:
### Note On/Off

Notes played on the Key Switches, as well as notes played via the Sequencer, and notes that are sent to the MIDI Input jack that are on the current MIDI Channel will all be transmitted.
### Clock

Clock messages are sent from Iosefka's internal Sequencer clock unless there is an incoming MIDI clock and the MIDI Clock RX setting is ON, in which case Iosefka passes the external clock message from the transmitting device to the MIDI Output.
### Transport

MIDI Start and Stop messages are sent when the Play Switch is pressed, and will start and stop respectively with the sequencer state. If MIDI Transport RX setting is ON, MIDI Start and Stop messages sent to the MIDI Input will be passed to the output from the transmitting device.

# Credits, Acknowledgements, and More

## Credits and Acknowledgements

Iosefka is created by Cory Oleson under the title Global Sequence.

Iosefka would not be possible without the explicit help of many helpful anonymous strangers on the internet, and the implicit assistance of countless open source projects on the internet.

An extra special shout out goes to Frédéric Meslin of Fred's Lab and Èmilie Gillet of the late Mutable Instruments. Also for Maffez's version of the 2140 pole mixing filter which was very helpful alongside Sound Semiconductor's documentation.

This synthesizer is fully open source under the GPL-3.0 license.

## A Note on the Use of Artificial Intelligence

### What AI was used for in this project

- As an aide to answer general programming questions relating to design patterns, both C and C++ languages, Git/GitHub, interpreting some open source code, etc.
- Assistance understanding DSP concepts
- As a way of creating and editing large enums and arrays from existing values
- Occasionally detecting errors in code
- The one line of ASM for the phase overflow flag used in the oscillator sync functionality
- Generating the text that goes into every .h, .c, and .cpp file, with the basic includes at the top. Example:

#ifndef EXAMPLE_H  
#define EXAMPLE_H  

#include <stdio.h>  
#include "pico/stdlib.h"  

#ifdef __cplusplus  
extern "C"  
{  
#endif  

// C header here  

#ifdef __cplusplus  
}  
#endif  

#endif

### What AI was NOT used for in this project

- Vibe coding - No whole functions, classes, or files were written by AI tools
- The concept, architecture, or structure of the synthesizer itself
- Any of the hardware design and layout
- Writing the manual
- ... and for better or for worse, I believe it shows.

# Build Guide

This will walk you through the step-by-step process of populating the Iosefka PCB using components from the Bill of Materials, as well as uploading the firmware to the microcontroller.

Note: This guide was made using an older version of the PCB. The only differences are a few of the component values (follow values on your PCB and you'll be fine), the omission of the 1M resistor which is now DNP (do not place) on the new PCB, some silk screen labels on the control board, and the addition of the 6th spacer between the Switch Keys.

## DISCLAIMER

We are not responsible for any accidents that arise during the build process, or in the course of operation. Any safety precautions involved with working with solder, electrical components, and anything else are the responsibility of the builder.

## Tools

Required

- Soldering Iron
- Solder (leaded or lead free, you do you)
- Wire cutters
- Small phillips screwdriver
- Small flathead screwdriver Tools - Required

Optional (but recommended)

- "Helping hands" clips for soldering (pictured in two different sizes)
- Soldering flux paste
- Electronics tweezers
- Desoldering wick
- (not pictured) Painter's tape
- (not pictured) Rubber bands
- (not pictured) Rubbing alcohol
- (not pictured) Q-tips or microfiber rag Tools - Optional

## Step 0: Flashing the Raspberry Pi Pico

Flashing the firmware to the Raspberry Pi Pico is easy.

- Download the iosefka.uf2 firmware file from here:
  - https://github.com/GlobalSequence/iosefka/releases
- Plug a micro USB cable into the Raspberry Pi Pico
- Press the BOOTSEL switch on the Pico
- With the BOOTSEL switch held down, plug the USB cable into the computer
- The Raspberry Pi Pico will appear as a drive on your computer
- Drag and drop the iosefka.uf2 file directly into the drive

## Control Board

First, populate the IC sockets. Some people put the sockets on later, but I prefer to put them on first when no other components are in the way. Up to you!

cb_1_sockets

Important! Make sure that the scallop in the socket lines up with the crescent shape on the PCB silkscreen.

Control Board - IC direction

You can run a rubber band along the IC sockets to hold them in place when soldering them in upside down. Painters tape also works well.

Control Board - Rubber Band Top

Control Board - Rubber Band Bottom

Note on LED Direction: The long leg of the LED is the anode (+) which goes into the round hole, the short leg is the cathode (-) which goes into the square hole.

Control Board - LED Direction

Kinda hard to tell, but the cathode side of the LED is flat, which helps to make sure that you put it in the correct way.

Control Board - LED Flat side

Place the diodes (this includes the LEDs).

cb_3_diodes

Place the resistors.

IMPORTANT! Don't place the 470 Ohm resistors that go under the OLED on the top side of the board! Those go underneath.

cb_4_resistors

Place the capacitors.

cb_5_caps

Place the switches. Press them down so they're flush with the PCB before soldering. Also place the encoder.

cb_6_sw

Place the potentiometers. It's kind of tricky, I like to put one of the anchors in, then guide the three pins in, and then press the second anchor in with my thumb. Also, up to you but I don't solder the anchors. God forbid we have to remove one or more of these one day.

I've also placed the encoder in at this point.

cb_7_pots

Now place the resistors on the underside of the board. When you cut the leads on these, cut them as short as possible, so they don't touch the OLED when it is in place.

cb_8_resistors

Place the MIDI sockets. Hold them in place with some tape or a rubber band if necessary.

cb_9_midi

Place the pin headers and solder them on the top of the board. Here I'm holding the headers in place and in alignment with some painter's tape.

cb_10_pins

Use 2M Screws for the OLED screen, and fasten the nuts on the underside. The nuts might get caught on the pin header, if so, twist the screw itself and the nuts will spin into place. If the OLED comes with pin headers already soldered in, then solder the pin headers straight into the board.

Note 1: The nuts are shorter than the plastic piece on the pin header. If this is undesirable, you can double up on the nuts on the underside of the display.

Note 2: The holes for the screws are larger than the M2 screws, this is because these OLED displays are not at all standardized so the screw holes on your display may vary in width and vertical placement from another one.

![[IMG_2567.webp]]

Fasten the OLED in place after soldering it in.

![[IMG_2568.webp]]

Since you're soldering some components on the top side of the control board, some unsightly flux residue may occur. You can get it off with some rubbing alcohol. Thus far, I have not removed any silkscreen this way, but might be a good idea to do a small test swab to see if it's safe depending on where you get your board fab'd.

Control Board - Removing Flux

Ain't it beautiful? If you purchased a cap for the encoder, you can christen the control board with it now.

Control Board - Complete

## Motherboard

As above, so below. Place the DIP sockets first.

mb_1_sockets

Note: Make sure that the MCP4822 and MCP3201 sockets are facing each other as in this picture. The MCP3201 socket (and consequently the MCP3201 chip lol) faces down.

mb_2_sockets

I highly recommend putting the female pin headers in next, as I use painters tape to secure the pin headers to the PCB before soldering, which gets a bit harder if there are a bunch of resistors and caps in the way.

Note: These are the short-pinned female pin headers. The long pinned ones will be used further down in the build guide.

I also place the audio jacks and the barrel jack for the power for the same reasons. It's easier to hold them in place when the board is not populated.

mb_3_headers

Place the resistors and diodes. I did the resistors and diodes in one go cuz there's like 3 diodes.

NOTE: Ignore the resistor marked as DNP (do not place) on the PCB. This is from an older version and not in use. This resistor is marked as DNP on the PCB, you can't miss it.

mb_4_resistors

Place the ceramic caps. Ignore the fact that all my 100nf caps are the floppy circular kind. I got a billion of them in bulk.

mb_5_caps

Place the electrolytic caps. Long pin goes into the black side, short pin goes into the white side.

mb_6_elec_caps

Now for the miscellaneous components along the top.

mb_7_misc

Let's do a quick power test now. Insert the LT1054 IC and the Raspberry Pi Pico board.

!IMPORTANT!: Before plugging in the power adapter, make sure that the motherboard is NOT on a metal or conductive surface. Ideally, the PCB should be suspended.

Plug the power supply into the barrel jack.

mb_8_test1

With a multimeter, find the CD4051 socket in the bottom right of the motherboard and put the black lead on the ground pin (GREEN), and use the red lead to test the +5v and -5v pins pictured below.

mb_9_test2

Find the 24LC256 socket (above the Raspberry Pi Pico). Again with the multimeter, put the black lead on the ground pin and the red lead on pin 8, see picture below.

mb_10_test3

If the power is supplied in the way listed in the two pictures above, proceed to place the ICs, microcontroller, and breakout boards (see section below for soldering breakout boards and microcontroller). Brings a tear to yer eye.

Motherboard - Components Placed

## Breakout Boards

Time for some SMD soldering folks! For both the LM13700 and SSI2140, the instructions are the same.

Note: The SMD instructions here are by no means comprehensive, I recommend one of the many helpful YouTube videos on soldering SMD chips. It's not as intimidating as it sounds, but it's more than I think is appropriate to type out in the build guide.

Note: There is a spot on the Motherboard PCB where you can solder the SMD components directly, but I prefer breakout boards for easy future maintenance if necessary. Up to you.

First, apply some flux to the pins on each corner of the breakout.

Breakout - Flux Corners

Place the IC making sure that the first pin is in the correct corner, as indicated by the small circle on the IC, and the arrow on the breakout.

Breakout - Placing IC

Apply solder to the two pins with flux.

Apply flux to all the other pins and solder them, ensuring that there is no solder bridges.

Then make sure to remove all the extra flux with rubbing alcohol and a q-tip or microfiber rag.

Breakout - Soldering Pins

For both the microcontroller and the breakout boards, it is helpful to secure the pin headers by resting them on a breadboard, and then putting the components on top as pictured below. I don't recommend pressing the pins into the breadboard, as it may affect the pins' vertical alignment. Breakout - Breadboard Alignment

Solder the corner of one side first, ensuring that the pins are as vertical as possible. You can use this single solder point to align both pin headers. For example, if you solder the one corner and the pin headers are slanted, you can reheat the single solder joint while aligning the board with your finger on top, then let the solder cool. The pins should now stay aligned while you solder the rest in.

Breakout - Soldering Corners

Solder the rest!

Breakout - Soldering Pins

## Assembling the Boards

On the Control Board, put the hex screws through the top side and screw the spacers into the bottom side by hand. Hand-tight is fine, don't go damaging your board now.

Assembly - Hex Screw and Spacers

All screws/spacers in.

Assembly - Hex Screws and Spacers All

In the Bottom Board (with the Iosefka logo), screw in the screws and the plastic nuts, leaving some slack in the screw, so that the screw can turn when connecting boards.

Assembly - Bottom Screw and Spacers

Iosefka uses two female pin headers as spacers to connect the pins that lead from the Motherboard to the Control Board. The standard female pin headers don't have pins long enough, and the long-pinned pin headers are too long, so we have to compromise by cutting the pins on the long-pinned ones.

In this picture, I've put the female pin headers side by side with the male pin header to show the length that the leads need to be cut to.

Assembly - Pin Comparison

Really, you can eyeball it. As long as the cut pins are roughly the length of the male pin header. A few millimeters short or long should be fine. However, if you want to be thorough, you can put the male pin header atop the female one, and use a marker to trace along the bottom of the male pin header to see where you should cut. Cut slightly above the marked line.

Assembly - Marking Pins

As you can see, it's not perfect, but it works just fine!

Assembly - Cut Pins

Place the pin headers in the pin sockets on the control board.

Assembly - Pin header

Attach the Control Board to the Motherboard by placing the male pin headers into the female pin headers.

Assembly - Attaching Control Board to Motherboard

Align the Bottom Board with the Motherboard and screw the screws into the Control Board spacers.

Assembly - Screwing Bottom Board to Motherboard

Go nuts and place rubber feet wherever the hell you want. Just make sure there's four of 'em!

Assembly - Placing Rubber Feet

Behold your work!

Assembly - Complete

At this point, you should be able to plug power into your Iosefka model and it will power up.

Before plugging Iosefka into audio, you must now format the EEPROM.

## Formatting the EEPROM

You just need to hold down some buttons with the power off, then plug the device in. See the Initializing All Presets section for the exact details.

Now! If you plug the synth into a speaker and hit one of the keyboard switches and hear sound, that's a great sign!

Lastly, we just need some...

## Calibration

The two trimpots on the back of the synth are for: - Filter Cutoff Offset - ensuring that the filter is in the correct frequency range - Filter Tracking - Making sure that the filter plays musically across a certain octave range

Calibration - Setting Offset and Trim

### Cutoff Calibration

The filter on Iosefka ranges between roughly 20Hz to 20kHz. You can use an oscilloscope to calibrate the cutoff, but we can also just calibrate this by ear using the self-resonance. With the synth on:

- Navigate to the Synth 1 View
  - Turn down Mix 1, Mix 2, and Mix Noise parameters to 00
  - Turn Cutoff to 00
  - Turn Resonance to FF
- Navigate to Synth 1 View
  - Hold shift and turn the VCA Parameter to FF
- Navigate to the Synth 2 View
  - Ensure the F. Type parameter is L4
  - Turn the F. Track parameter to 00

You should now hear a sine wave from the filter self-oscillating. Looking directly at the back of the synth (like in the pic above), turn the Offset trimpot to the left until the sound is too low to hear. Now if you turn the Cutoff parameter to FF, and you still hear a super high pitch, turn the Offset trimpot to the right until the sound is too high pitch to hear, then turn it just a smidge more if you're 30 or older.

### Tracking Calibration

We will now use the built-in sequencer on Iosefka to test the tracking across 5 octaves. We will enter 6 octaves in the sequencer just to see if we get lucky.

A musical tuner will help us with this one With the synth on:

- Navigate to the Synth 1 View
  - Turn down Mix 1, Mix 2, and Mix Noise parameters to 00
  - Turn Cutoff to 40
  - Turn Resonance to FF
- Navigate to Synth 1 View
  - Hold shift and turn the VCA Parameter to FF
- Navigate to the Synth 2 View
  - Ensure the F. Type parameter is L4
  - Turn the F. Track parameter to FF (Make sure it's on FF not 00!)

At this point, you should hear the sequencer self-oscillating in perpetuity. Make sure it's loud enough so that your neighbors can hear its glory!

- Navigate to the Sequencer view
  - Make sure that the Sequencer pattern is empty. If it is not, load a blank preset, which should have an empty pattern and start from the top.
  - Turn the First Step parameter to 00
  - Turn the Last Step parameter to 05
  - Turn the Clock Div parameter to *8
  - Turn the Octave parameter so that the note in the top left of the OLED Display reads "C1"
  - Hit Key Switch 1 to place a step with the value C1 on step 1
  - Repeat the last two steps turning the Octave parameter so that it reads "C2", then hitting Key switch 2, and so on until the you place C6 by hitting Key switch 6. You should now have a sequence of 6 steps ascending one octave per step.
- Press the Play switch. You should now hear the sequencer playing a sequence ascending by roughly 1 octave.
- Turn the Tracking trimpot in either direction until the sequence comes into tune. Each note should represent one musical octave.

Calibration - Sequencer Steps

Documentation built with MkDocs (http://www.mkdocs.org/) using Windmill Dark theme by None (noraj).
