GlobalSequence/iosefka/CHANGELOG.md

# Change Log

## [v1.1.0] 2026-10-17
---
### Added
- Delay Stutter mode, a clock-synced repeating delay
- Version number added to splash screen
### Changed

### Fixed
- After ~71 minutes, an integer overflow caused the following issues
	- The hanging screen would no longer be visible
	- Saving a Preset would not save sequencer data

## [v1.0.0] 2026-06-18
---
Initial public release.

This release includes:

- Source code
- Hardware design files
- Documentation
- Precompiled firmware

Please see the README for more information about sourcing and building this project.
