GlobalSequence/iosefka/hardware/iosefka_motherboard/iosefka_motherboard.kicad_pcb

## KiCad design hardware/iosefka_motherboard/iosefka_motherboard.kicad_pcb (2026-05-10)

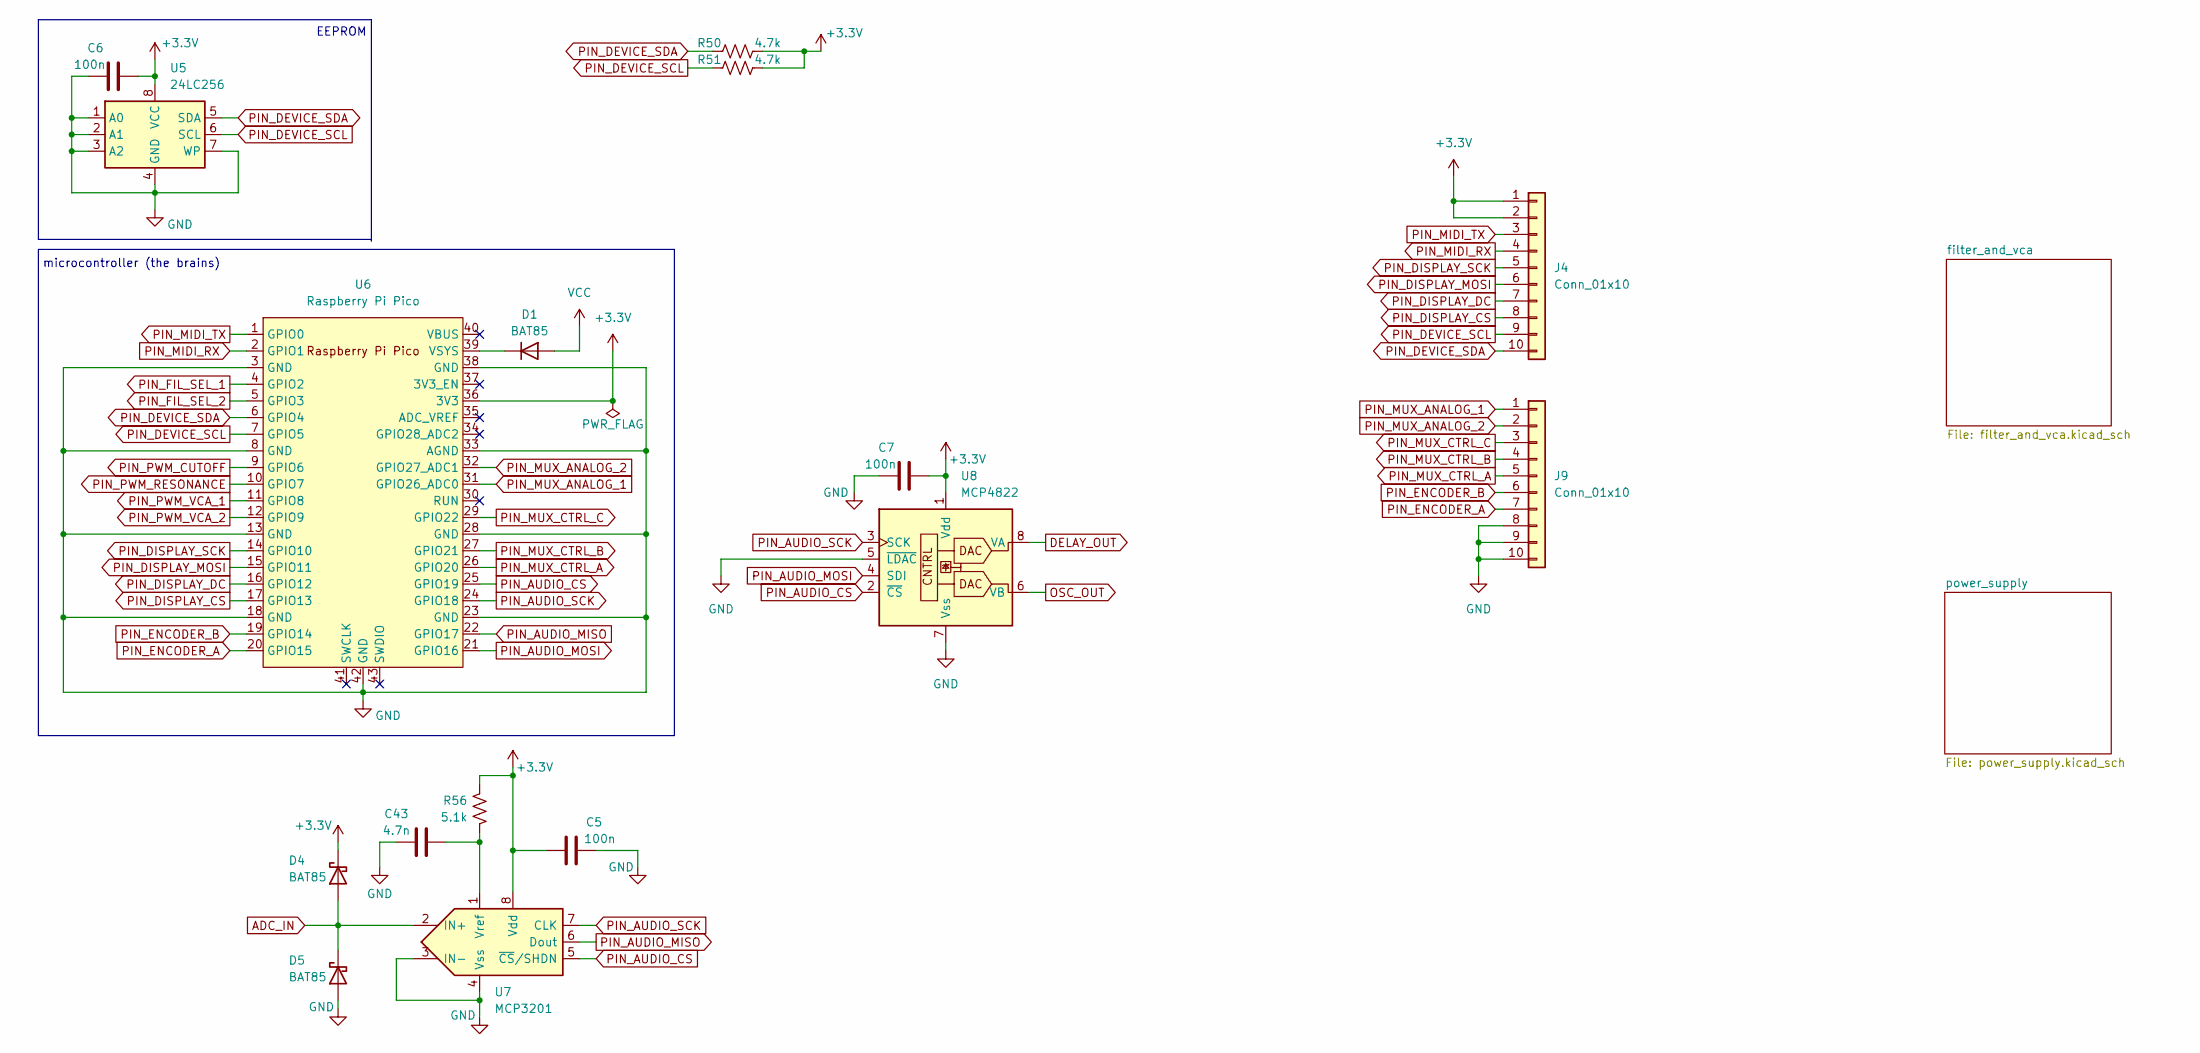
[picture p97: schematic iosefka_motherboard.kicad_sch]

Parts:
C5, C6, C7: 100n; C_Disc_D5.0mm_W2.5mm_P5.00mm
C43: 4.7n; C_Disc_D5.0mm_W2.5mm_P5.00mm
D1, D4, D5: BAT85; D_DO-35_SOD27_P7.62mm_Horizontal
J4, J9: Conn_01x10; PinSocket_1x10_P2.54mm_Vertical
R50, R51: 4.7k; R_Axial_DIN0207_L6.3mm_D2.5mm_P10.16mm_Horizontal
R56: 5.1k; R_Axial_DIN0207_L6.3mm_D2.5mm_P10.16mm_Horizontal
U5: 24LC256; DIP-8_W7.62mm_Socket
U6: Raspberry Pi Pico; RaspberryPi_Pico_Common_THT_NO_WIFI
U7: MCP3201; DIP-8_W7.62mm_Socket
U8: MCP4822; DIP-8_W7.62mm_Socket

Connections:
+3.3V: C5.1, C6.1, C7.1, D4.1 (K), J4.1, J4.2, R50.2, R51.2, R56.1, U5.8 (VCC), U6.36 (3V3), U7.8 (Vdd), U8.1 (Vdd)
ADC_IN: D4.2 (A), D5.1 (K), U7.2 (IN+); also elsewhere on the board
DELAY_OUT: U8.8 (VA); also elsewhere on the board
GND: C5.2, C6.2, C7.2, C43.1, D5.2 (A), J9.8, J9.9, J9.10, U5.1 (A0), U5.2 (A1), U5.3 (A2), U5.4 (GND), U5.7 (WP), U6.3 (GND), U6.8 (GND), U6.13 (GND), U6.18 (GND), U6.23 (GND), U6.28 (GND), U6.33 (AGND), U6.38 (GND), U6.42 (GND), U7.3 (IN-), U7.4 (Vss), U8.5 (~LDAC), U8.7 (Vss); also elsewhere on the board
unnamed: D1.1 (K), U6.39 (VSYS)
unnamed: C43.2, R56.2, U7.1 (Vref)
OSC_OUT: U8.6 (VB); also elsewhere on the board
PIN_AUDIO_CS: U6.25 (GPIO19), U7.5 (~CS/SHDN), U8.2 (~CS)
PIN_AUDIO_MISO: U6.22 (GPIO17), U7.6 (Dout)
PIN_AUDIO_MOSI: U6.21 (GPIO16), U8.4 (SDI)
PIN_AUDIO_SCK: U6.24 (GPIO18), U7.7 (CLK), U8.3 (SCK)
PIN_DEVICE_SCL: J4.9, R51.1, U5.6 (SCL), U6.7 (GPIO5)
PIN_DEVICE_SDA: J4.10, R50.1, U5.5 (SDA), U6.6 (GPIO4)
PIN_DISPLAY_CS: J4.8, U6.17 (GPIO13)
PIN_DISPLAY_DC: J4.7, U6.16 (GPIO12)
PIN_DISPLAY_MOSI: J4.6, U6.15 (GPIO11)
PIN_DISPLAY_SCK: J4.5, U6.14 (GPIO10)
PIN_ENCODER_A: J9.7, U6.20 (GPIO15)
PIN_ENCODER_B: J9.6, U6.19 (GPIO14)
PIN_FIL_SEL_1: U6.4 (GPIO2); also elsewhere on the board
PIN_FIL_SEL_2: U6.5 (GPIO3); also elsewhere on the board
PIN_MIDI_RX: J4.4, U6.2 (GPIO1)
PIN_MIDI_TX: J4.3, U6.1 (GPIO0)
PIN_MUX_ANALOG_1: J9.1, U6.31 (GPIO26_ADC0)
PIN_MUX_ANALOG_2: J9.2, U6.32 (GPIO27_ADC1)
PIN_MUX_CTRL_A: J9.5, U6.26 (GPIO20)
PIN_MUX_CTRL_B: J9.4, U6.27 (GPIO21)
PIN_MUX_CTRL_C: J9.3, U6.29 (GPIO22)
PIN_PWM_CUTOFF: U6.9 (GPIO6); also elsewhere on the board
PIN_PWM_RESONANCE: U6.10 (GPIO7); also elsewhere on the board
PIN_PWM_VCA_1: U6.11 (GPIO8); also elsewhere on the board
PIN_PWM_VCA_2: U6.12 (GPIO9); also elsewhere on the board
VCC: D1.2 (A); also elsewhere on the board

Notes on the sheet:
microcontroller (the brains)
EEPROM

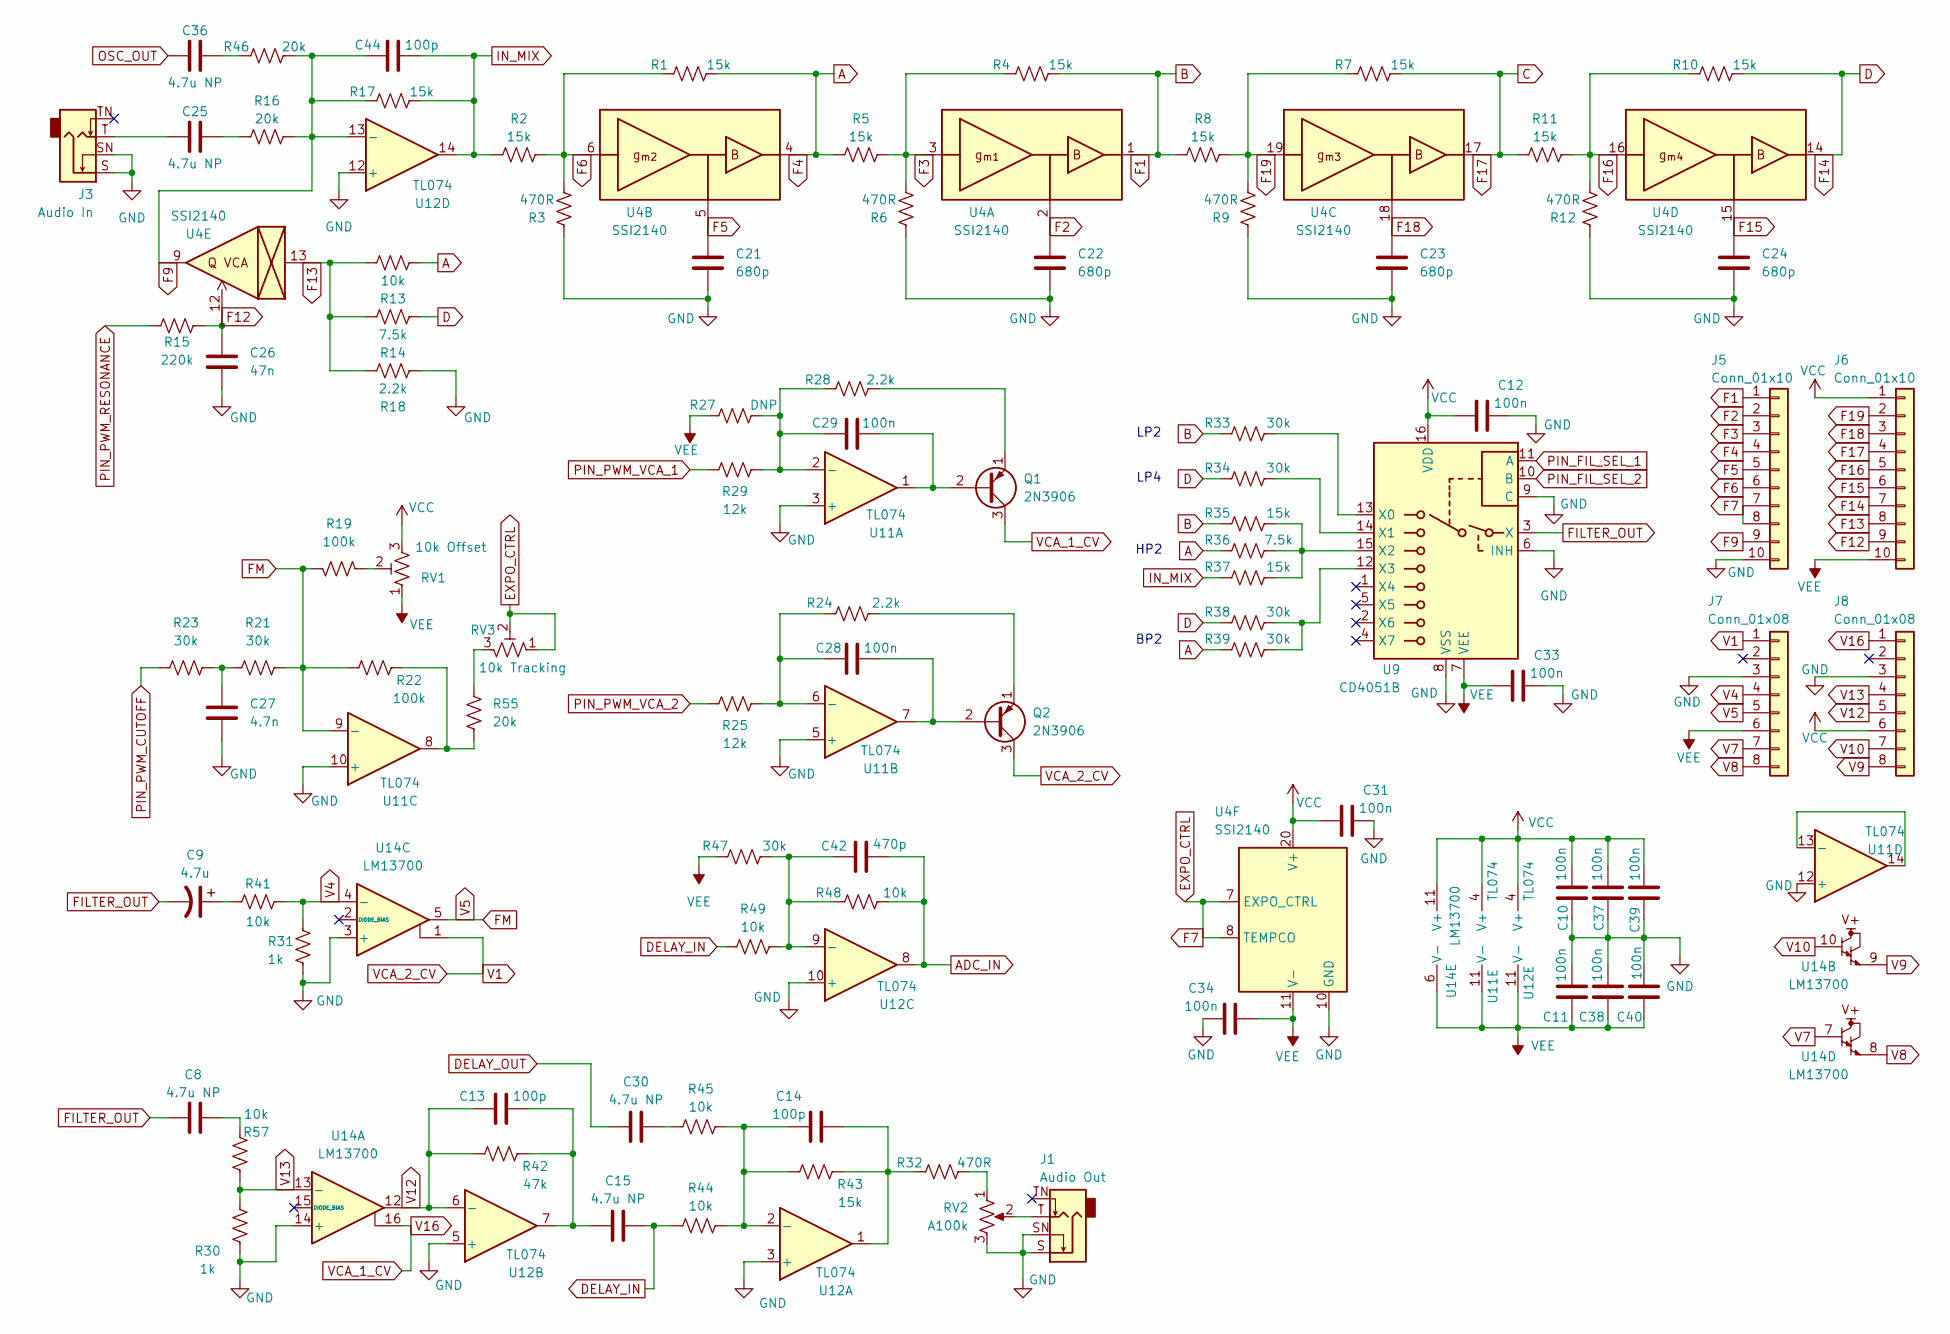
[picture p98: schematic filter_and_vca.kicad_sch]

Parts:
C8, C15, C25, C30, C36: 4.7u NP; CP_Radial_D6.3mm_P2.50mm_VALUE
C9: 4.7u; CP_Radial_D6.3mm_P2.50mm_VALUE
C10, C11, C12, C28, C29, C31, C33, C34, C37, C38, C39, C40: 100n; C_Disc_D5.0mm_W2.5mm_P5.00mm
C13, C14, C44: 100p; C_Disc_D5.0mm_W2.5mm_P5.00mm
C21, C22, C23, C24: 680p; C_Disc_D5.0mm_W2.5mm_P5.00mm
C26: 47n; C_Disc_D5.0mm_W2.5mm_P5.00mm
C27: 4.7n; C_Disc_D5.0mm_W2.5mm_P5.00mm
C42: 470p; C_Disc_D5.0mm_W2.5mm_P5.00mm
J1: Audio Out; Jack_6.35mm_Neutrik_NMJ4HCD2_Horizontal
J3: Audio In; Jack_6.35mm_Neutrik_NMJ4HCD2_Horizontal
J5, J6: Conn_01x10
J7, J8: Conn_01x08
Q1, Q2: 2N3906; TO-92_Inline_Wide
R1, R2, R4, R5, R7, R8, R10, R11, R17, R35, R37, R43: 15k; R_Axial_DIN0207_L6.3mm_D2.5mm_P10.16mm_Horizontal
R3, R6, R9, R12, R32: 470R; R_Axial_DIN0207_L6.3mm_D2.5mm_P10.16mm_Horizontal
R13, R41, R44, R45, R48, R49, R57: 10k; R_Axial_DIN0207_L6.3mm_D2.5mm_P10.16mm_Horizontal
R14, R36: 7.5k; R_Axial_DIN0207_L6.3mm_D2.5mm_P10.16mm_Horizontal
R15: 220k; R_Axial_DIN0207_L6.3mm_D2.5mm_P10.16mm_Horizontal
R16, R46, R55: 20k; R_Axial_DIN0207_L6.3mm_D2.5mm_P10.16mm_Horizontal
R18, R24, R28: 2.2k; R_Axial_DIN0207_L6.3mm_D2.5mm_P10.16mm_Horizontal
R19, R22: 100k; R_Axial_DIN0207_L6.3mm_D2.5mm_P10.16mm_Horizontal
R21, R23, R33, R34, R38, R39, R47: 30k; R_Axial_DIN0207_L6.3mm_D2.5mm_P10.16mm_Horizontal
R25, R29: 12k; R_Axial_DIN0207_L6.3mm_D2.5mm_P10.16mm_Horizontal
R27: DNP; R_Axial_DIN0207_L6.3mm_D2.5mm_P10.16mm_Horizontal
R30, R31: 1k; R_Axial_DIN0207_L6.3mm_D2.5mm_P10.16mm_Horizontal
R42: 47k; R_Axial_DIN0207_L6.3mm_D2.5mm_P10.16mm_Horizontal
RV1: 10k Offset; Potentiometer_Bourns_3266Z_Horizontal
RV2: A100k; Potentiometer_Bourns_PTV09A-2_Single_Horizontal
RV3: 10k Tracking; Potentiometer_Bourns_3266Z_Horizontal
U4: SSI2140; SSOP-20_5.3x7.2mm_P0.65mm
U9: CD4051B; DIP-16_W7.62mm_Socket
U11, U12: TL074; DIP-14_W7.62mm_Socket
U14: LM13700; SOIC-16_3.9x9.9mm_P1.27mm

Connections:
A: J5.4, R1.2, R5.1, R13.1, R36.1, R39.1, U4.4
ADC_IN: C42.2, R48.2, U12.8; also elsewhere on the board
B: J5.1, R4.2, R8.1, R33.1, R35.1, U4.1
C: J6.4, R7.2, R11.1, U4.17
D: J6.7, R10.2, R14.1, R34.1, R38.1, U4.14
DELAY_IN: C15.2, R44.1, R49.1
DELAY_OUT: C30.1; also elsewhere on the board
EXPO_CTRL: J5.7, J5.8, RV3.1, RV3.2, U4.7 (EXPO_CTRL), U4.8 (TEMPCO)
F2: C22.2, J5.2, U4.2
F3: J5.3, R4.1, R5.2, R6.2, U4.3
F5: C21.2, J5.5, U4.5
F6: J5.6, R1.1, R2.2, R3.2, U4.6
F9: C44.1, J5.9, R16.2, R17.1, R46.2, U4.9, U12.13 (-)
F12: C26.2, J6.9, R15.2, U4.12
F13: J6.8, R13.2, R14.2, R18.2, U4.13
F15: C24.2, J6.6, U4.15
F16: J6.5, R10.1, R11.2, R12.2, U4.16
F18: C23.2, J6.3, U4.18
F19: J6.2, R7.1, R8.2, R9.2, U4.19
FILTER_OUT: C8.1, C9.2, U9.3 (X)
FM: J7.5, R19.2, R21.2, R22.1, U11.9 (-), U14.5
GND: C10.1, C11.2, C12.2, C21.1, C22.1, C23.1, C24.1, C26.1, C27.2, C31.2, C33.2, C34.2, C37.1, C38.2, C39.1, C40.2, J1.S, J1.SN, J3.S, J3.SN, J5.10, J7.3, J8.3, R3.1, R6.1, R9.1, R12.1, R18.1, R30.2, R31.2, RV2.3, U4.10 (GND), U9.6 (INH), U9.8 (VSS), U9.9 (C), U11.3 (+), U11.5 (+), U11.10 (+), U11.12 (+), U12.3 (+), U12.5 (+), U12.10 (+), U12.12 (+), U14.3 (+), U14.14 (+); also elsewhere on the board
IN_MIX: C44.2, R2.1, R17.2, R37.1, U12.14
unnamed: C8.2, R57.2
unnamed: C9.1, R41.1
unnamed: C13.2, C15.1, R42.2, U12.7
unnamed: C14.2, R32.1, R43.2, U12.1
unnamed: C25.1, J3.T
unnamed: C25.2, R16.1
unnamed: C27.1, R21.1, R23.2
unnamed: C30.2, R45.1
unnamed: C36.2, R46.1
unnamed: J1.T, RV2.2
unnamed: C29.2, Q1.2 (B), U11.1
unnamed: Q1.1 (E), R28.2
unnamed: C28.2, Q2.2 (B), U11.7
unnamed: Q2.1 (E), R24.2
unnamed: R19.1, RV1.2
unnamed: R22.2, R55.2, U11.8
unnamed: R32.2, RV2.1
unnamed: R55.1, RV3.3
unnamed: R33.2, U9.13 (X0)
unnamed: R34.2, U9.14 (X1)
unnamed: R35.2, R36.2, R37.2, U9.15 (X2)
unnamed: R38.2, R39.2, U9.12 (X3)
unnamed: C29.1, R27.2, R28.1, R29.2, U11.2 (-)
unnamed: C28.1, R24.1, R25.2, U11.6 (-)
unnamed: U11.13 (-), U11.14
unnamed: C14.1, R43.1, R44.2, R45.2, U12.2 (-)
unnamed: C42.1, R47.2, R48.1, R49.2, U12.9 (-)
OSC_OUT: C36.1; also elsewhere on the board
PIN_FIL_SEL_1: U9.11 (A); also elsewhere on the board
PIN_FIL_SEL_2: U9.10 (B); also elsewhere on the board
PIN_PWM_CUTOFF: R23.1; also elsewhere on the board
PIN_PWM_RESONANCE: R15.1; also elsewhere on the board
PIN_PWM_VCA_1: R29.1; also elsewhere on the board
PIN_PWM_VCA_2: R25.1; also elsewhere on the board
V1: J7.1, Q2.3 (C), U14.1
V4: J7.4, R31.1, R41.2, U14.4 (-)
V7: J7.7, U14.7
V8: J7.8, U14.8
V9: J8.8, U14.9
V10: J8.7, U14.10
V12: C13.1, J8.5, R42.1, U12.6 (-), U14.12
V13: J8.4, R30.1, R57.1, U14.13 (-)
V16: J8.1, Q1.3 (C), U14.16
VCC: C10.2, C12.1, C31.1, C37.2, C39.2, J6.1, J8.6, RV1.3, U4.20 (V+), U9.16 (VDD), U11.4 (V+), U12.4 (V+), U14.11 (V+); also elsewhere on the board
VEE: C11.1, C33.1, C34.1, C38.1, C40.1, J6.10, J7.6, R27.1, R47.1, RV1.1, U4.11 (V-), U9.7 (VEE), U11.11 (V-), U12.11 (V-), U14.6 (V-); also elsewhere on the board

Notes on the sheet:
BP2
LP2
LP4
HP2

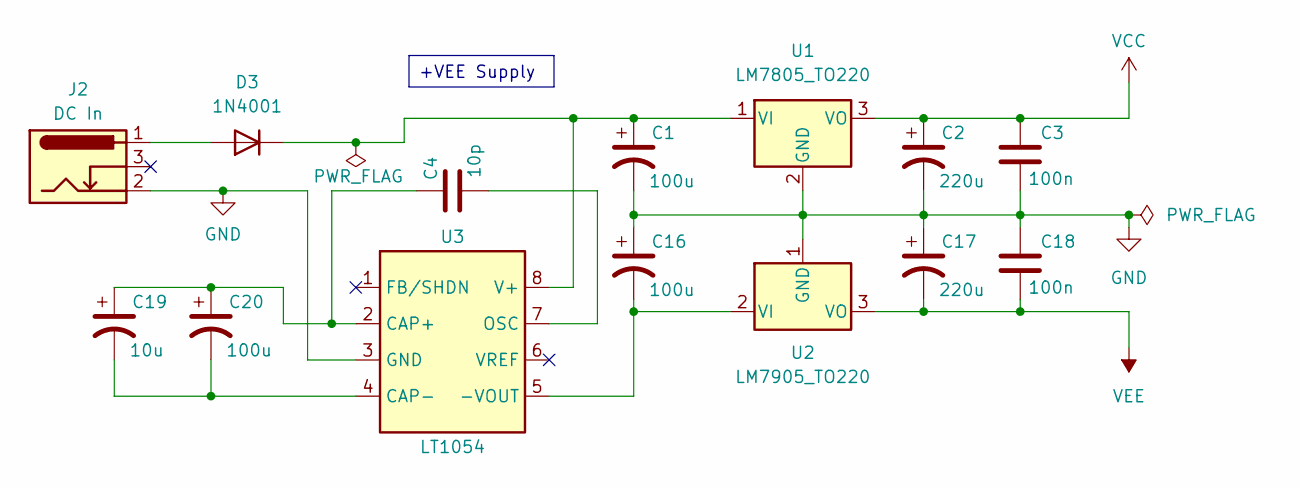
[picture p99: schematic power_supply.kicad_sch]

Parts:
C1, C16, C20: 100u; CP_Radial_D6.3mm_P2.50mm_VALUE
C2, C17: 220u; CP_Radial_D8.0mm_P2.50mm_VALUE
C3, C18: 100n; C_Disc_D5.0mm_W2.5mm_P5.00mm
C4: 10p; C_Disc_D5.0mm_W2.5mm_P5.00mm
C19: 10u; CP_Radial_D5.0mm_P2.50mm
D3: 1N4001; D_DO-41_SOD81_P10.16mm_Horizontal
J2: DC In; BarrelJack_Horizontal
U1: LM7805_TO220; TO-220-3_Horizontal_TabDown
U2: LM7905_TO220; TO-220-3_Horizontal_TabDown
U3: LT1054; DIP-8_W7.62mm_Socket

Connections:
GND: C1.2, C2.2, C3.2, C16.1, C17.1, C18.1, J2.2, U1.2 (GND), U2.1 (GND), U3.3 (GND); also elsewhere on the board
unnamed: D3.2 (A), J2.1
unnamed: C1.1, D3.1 (K), U1.1 (VI), U3.8 (V+)
unnamed: C16.2, U2.2 (VI), U3.5 (-VOUT)
unnamed: C4.1, C19.1, C20.1, U3.2 (CAP+)
unnamed: C19.2, C20.2, U3.4 (CAP-)
unnamed: C4.2, U3.7 (OSC)
VCC: C2.1, C3.1, U1.3 (VO); also elsewhere on the board
VEE: C17.2, C18.2, U2.3 (VO); also elsewhere on the board

Notes on the sheet:
+VEE Supply

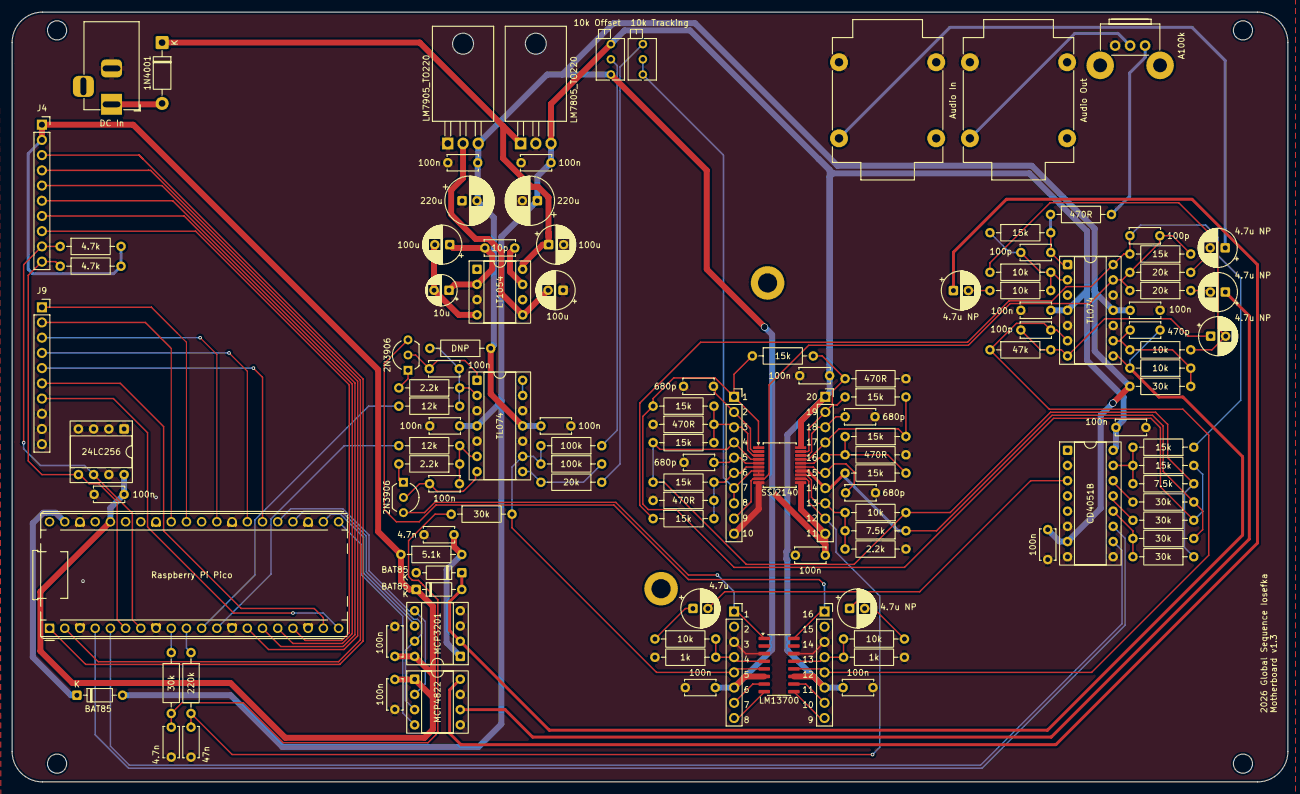
[picture p100: board iosefka_motherboard.kicad_pcb from above]

Board: 2 copper layers, 213.0 x 128.5 mm, 122 parts (0 on the bottom side), 96 nets.
