GlobalSequence/iosefka/hardware/iosefka_controlboard/iosefka_controlboard.kicad_pcb

## KiCad design hardware/iosefka_controlboard/iosefka_controlboard.kicad_pcb (2026-05-10)

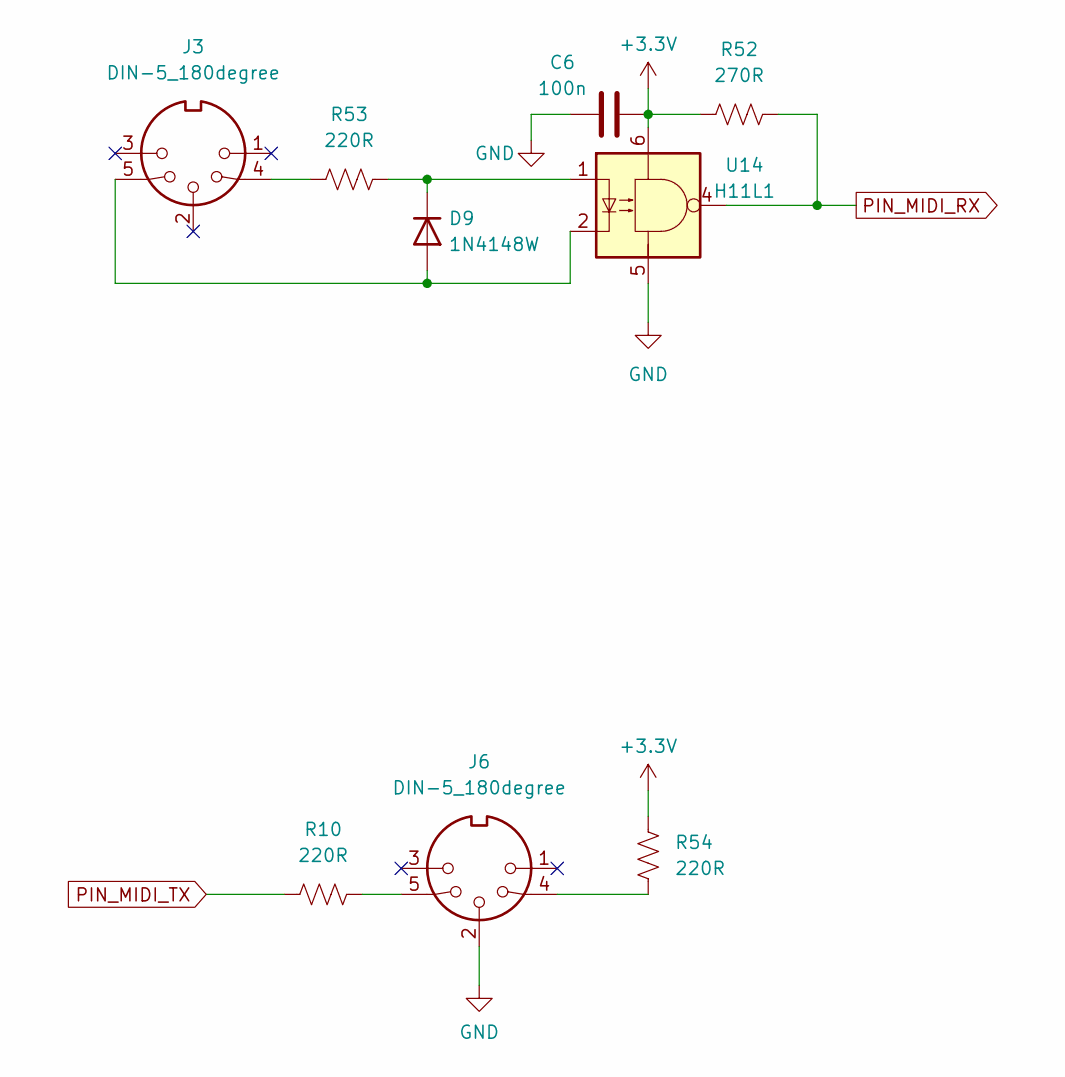
[picture p101: schematic midi_io.kicad_sch]

Parts:
C6: 100n; C_Rect_L7.0mm_W2.0mm_P5.00mm
D9: 1N4148W; D_DO-35_SOD27_P7.62mm_Horizontal
J3, J6: DIN-5_180degree; MIDI_DIN5
R10, R53, R54: 220R; R_Axial_DIN0207_L6.3mm_D2.5mm_P10.16mm_Horizontal
R52: 270R; R_Axial_DIN0207_L6.3mm_D2.5mm_P10.16mm_Horizontal
U14: H11L1; DIP-6_W7.62mm_Socket

Connections:
+3.3V: C6.2, R52.1, R54.1, U14.6; also elsewhere on the board
GND: C6.1, J6.2, U14.5; also elsewhere on the board
unnamed: D9.2 (A), J3.5, U14.2
unnamed: D9.1 (K), R53.2, U14.1
unnamed: J3.4, R53.1
unnamed: J6.4, R54.2
unnamed: J6.5, R10.2
PIN_MIDI_RX: R52.2, U14.4; also elsewhere on the board
PIN_MIDI_TX: R10.1; also elsewhere on the board

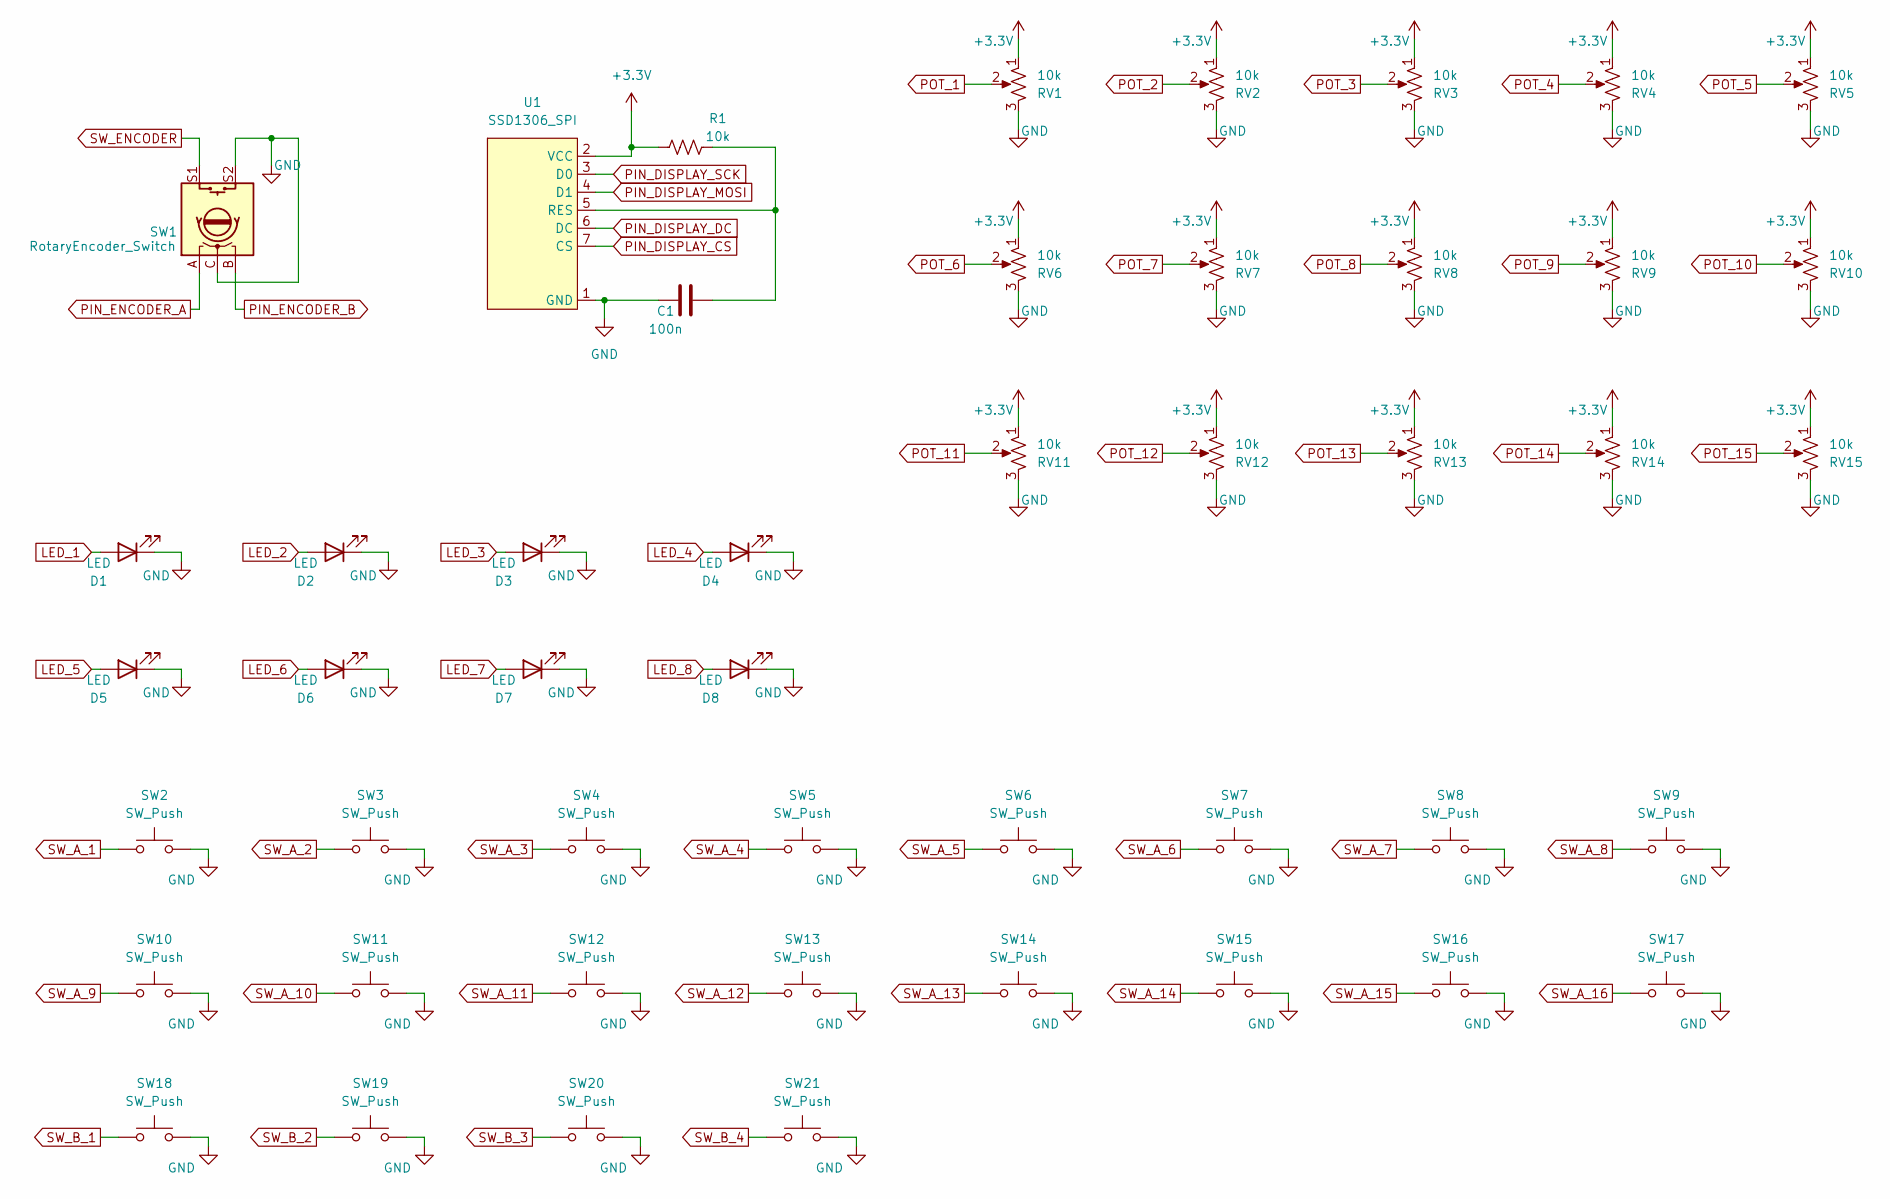
[picture p102: schematic components_and_display.kicad_sch]

Parts:
C1: 100n; C_Rect_L7.0mm_W2.0mm_P5.00mm
D1, D2, D3, D4, D5, D6, D7, D8: LED; LED_D3.0mm
R1: 10k; R_Axial_DIN0207_L6.3mm_D2.5mm_P10.16mm_Horizontal
RV1, RV2, RV3, RV4, RV5, RV6, RV7, RV8, RV9, RV10, RV11, RV12, RV13, RV14, RV15: 10k; Potentiometer_Bourns_PTV09A-1_Single_Vertical
SW1: RotaryEncoder_Switch; RotaryEncoder_Alps_EC11E-Switch_Vertical_H20mm
SW2, SW3, SW4, SW5, SW6, SW7, SW8, SW9, SW10, SW11, SW12, SW13, SW14, SW15, SW16, SW17, SW18, SW19, SW20, SW21: SW_Push; SW_PUSH_6mm
U1: SSD1306_SPI; 128x64_0.96_Disp_Module

Connections:
+3.3V: R1.1, RV1.1, RV2.1, RV3.1, RV4.1, RV5.1, RV6.1, RV7.1, RV8.1, RV9.1, RV10.1, RV11.1, RV12.1, RV13.1, RV14.1, RV15.1, U1.2 (VCC); also elsewhere on the board
GND: C1.1, D1.1 (K), D2.1 (K), D3.1 (K), D4.1 (K), D5.1 (K), D6.1 (K), D7.1 (K), D8.1 (K), RV1.3, RV2.3, RV3.3, RV4.3, RV5.3, RV6.3, RV7.3, RV8.3, RV9.3, RV10.3, RV11.3, RV12.3, RV13.3, RV14.3, RV15.3, SW1.C, SW1.S2, SW2.2, SW3.2, SW4.2, SW5.2, SW6.2, SW7.2, SW8.2, SW9.2, SW10.2, SW11.2, SW12.2, SW13.2, SW14.2, SW15.2, SW16.2, SW17.2, SW18.2, SW19.2, SW20.2, SW21.2, U1.1 (GND); also elsewhere on the board
LED_1: D1.2 (A); also elsewhere on the board
LED_2: D2.2 (A); also elsewhere on the board
LED_3: D3.2 (A); also elsewhere on the board
LED_4: D4.2 (A); also elsewhere on the board
LED_5: D5.2 (A); also elsewhere on the board
LED_6: D6.2 (A); also elsewhere on the board
LED_7: D7.2 (A); also elsewhere on the board
LED_8: D8.2 (A); also elsewhere on the board
unnamed: C1.2, R1.2, U1.5 (RES)
PIN_DISPLAY_CS: U1.7 (CS); also elsewhere on the board
PIN_DISPLAY_DC: U1.6 (DC); also elsewhere on the board
PIN_DISPLAY_MOSI: U1.4 (D1); also elsewhere on the board
PIN_DISPLAY_SCK: U1.3 (D0); also elsewhere on the board
PIN_ENCODER_A: SW1.A; also elsewhere on the board
PIN_ENCODER_B: SW1.B; also elsewhere on the board
POT_1: RV1.2; also elsewhere on the board
POT_2: RV2.2; also elsewhere on the board
POT_3: RV3.2; also elsewhere on the board
POT_4: RV4.2; also elsewhere on the board
POT_5: RV5.2; also elsewhere on the board
POT_6: RV6.2; also elsewhere on the board
POT_7: RV7.2; also elsewhere on the board
POT_8: RV8.2; also elsewhere on the board
POT_9: RV9.2; also elsewhere on the board
POT_10: RV10.2; also elsewhere on the board
POT_11: RV11.2; also elsewhere on the board
POT_12: RV12.2; also elsewhere on the board
POT_13: RV13.2; also elsewhere on the board
POT_14: RV14.2; also elsewhere on the board
POT_15: RV15.2; also elsewhere on the board
SW_A_1: SW2.1; also elsewhere on the board
SW_A_2: SW3.1; also elsewhere on the board
SW_A_3: SW4.1; also elsewhere on the board
SW_A_4: SW5.1; also elsewhere on the board
SW_A_5: SW6.1; also elsewhere on the board
SW_A_6: SW7.1; also elsewhere on the board
SW_A_7: SW8.1; also elsewhere on the board
SW_A_8: SW9.1; also elsewhere on the board
SW_A_9: SW10.1; also elsewhere on the board
SW_A_10: SW11.1; also elsewhere on the board
SW_A_11: SW12.1; also elsewhere on the board
SW_A_12: SW13.1; also elsewhere on the board
SW_A_13: SW14.1; also elsewhere on the board
SW_A_14: SW15.1; also elsewhere on the board
SW_A_15: SW16.1; also elsewhere on the board
SW_A_16: SW17.1; also elsewhere on the board
SW_B_1: SW18.1; also elsewhere on the board
SW_B_2: SW19.1; also elsewhere on the board
SW_B_3: SW20.1; also elsewhere on the board
SW_B_4: SW21.1; also elsewhere on the board
SW_ENCODER: SW1.S1; also elsewhere on the board

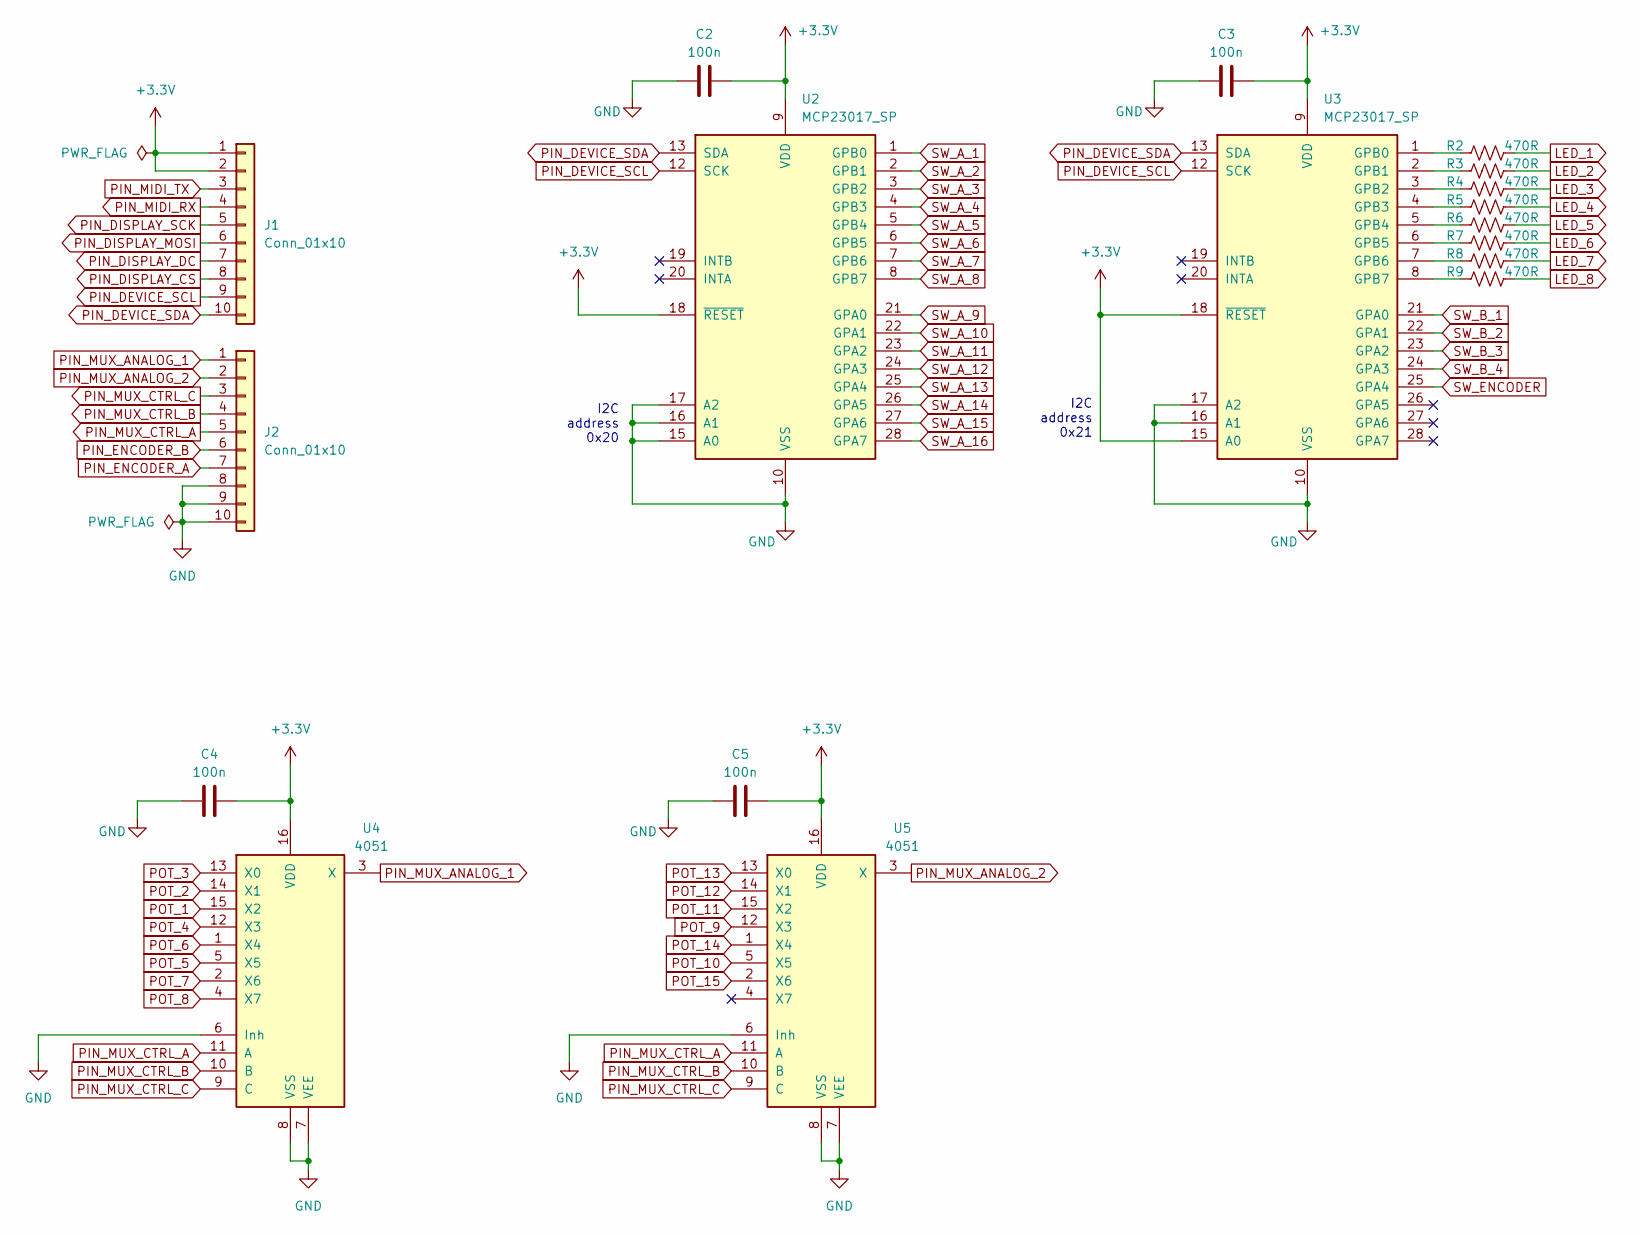
[picture p103: schematic ics_and_pin_headers.kicad_sch]

Parts:
C2, C3, C4, C5: 100n; C_Rect_L7.0mm_W2.0mm_P5.00mm
J1, J2: Conn_01x10; PinSocket_1x10_P2.54mm_Vertical
R2, R3, R4, R5, R6, R7, R8, R9: 470R; R_Axial_DIN0207_L6.3mm_D2.5mm_P10.16mm_Horizontal
U2, U3: MCP23017_SP; DIP-28_W7.62mm_Socket
U4, U5: 4051; DIP-16_W7.62mm_Socket

Connections:
+3.3V: C2.2, C3.2, C4.2, C5.2, J1.1, J1.2, U2.9 (VDD), U2.18 (~RESET), U3.9 (VDD), U3.15 (A0), U3.18 (~RESET), U4.16 (VDD), U5.16 (VDD); also elsewhere on the board
GND: C2.1, C3.1, C4.1, C5.1, J2.8, J2.9, J2.10, U2.10 (VSS), U2.15 (A0), U2.16 (A1), U2.17 (A2), U3.10 (VSS), U3.16 (A1), U3.17 (A2), U4.6 (Inh), U4.7 (VEE), U4.8 (VSS), U5.6 (Inh), U5.7 (VEE), U5.8 (VSS); also elsewhere on the board
LED_1: R2.2; also elsewhere on the board
LED_2: R3.2; also elsewhere on the board
LED_3: R4.2; also elsewhere on the board
LED_4: R5.2; also elsewhere on the board
LED_5: R6.2; also elsewhere on the board
LED_6: R7.2; also elsewhere on the board
LED_7: R8.2; also elsewhere on the board
LED_8: R9.2; also elsewhere on the board
unnamed: R2.1, U3.1 (GPB0)
unnamed: R3.1, U3.2 (GPB1)
unnamed: R4.1, U3.3 (GPB2)
unnamed: R5.1, U3.4 (GPB3)
unnamed: R6.1, U3.5 (GPB4)
unnamed: R7.1, U3.6 (GPB5)
unnamed: R8.1, U3.7 (GPB6)
unnamed: R9.1, U3.8 (GPB7)
PIN_DEVICE_SCL: J1.9, U2.12 (SCK), U3.12 (SCK)
PIN_DEVICE_SDA: J1.10, U2.13 (SDA), U3.13 (SDA)
PIN_DISPLAY_CS: J1.8; also elsewhere on the board
PIN_DISPLAY_DC: J1.7; also elsewhere on the board
PIN_DISPLAY_MOSI: J1.6; also elsewhere on the board
PIN_DISPLAY_SCK: J1.5; also elsewhere on the board
PIN_ENCODER_A: J2.7; also elsewhere on the board
PIN_ENCODER_B: J2.6; also elsewhere on the board
PIN_MIDI_RX: J1.4; also elsewhere on the board
PIN_MIDI_TX: J1.3; also elsewhere on the board
PIN_MUX_ANALOG_1: J2.1, U4.3 (X)
PIN_MUX_ANALOG_2: J2.2, U5.3 (X)
PIN_MUX_CTRL_A: J2.5, U4.11 (A), U5.11 (A)
PIN_MUX_CTRL_B: J2.4, U4.10 (B), U5.10 (B)
PIN_MUX_CTRL_C: J2.3, U4.9 (C), U5.9 (C)
POT_1: U4.15 (X2); also elsewhere on the board
POT_2: U4.14 (X1); also elsewhere on the board
POT_3: U4.13 (X0); also elsewhere on the board
POT_4: U4.12 (X3); also elsewhere on the board
POT_5: U4.5 (X5); also elsewhere on the board
POT_6: U4.1 (X4); also elsewhere on the board
POT_7: U4.2 (X6); also elsewhere on the board
POT_8: U4.4 (X7); also elsewhere on the board
POT_9: U5.12 (X3); also elsewhere on the board
POT_10: U5.5 (X5); also elsewhere on the board
POT_11: U5.15 (X2); also elsewhere on the board
POT_12: U5.14 (X1); also elsewhere on the board
POT_13: U5.13 (X0); also elsewhere on the board
POT_14: U5.1 (X4); also elsewhere on the board
POT_15: U5.2 (X6); also elsewhere on the board
SW_A_1: U2.1 (GPB0); also elsewhere on the board
SW_A_2: U2.2 (GPB1); also elsewhere on the board
SW_A_3: U2.3 (GPB2); also elsewhere on the board
SW_A_4: U2.4 (GPB3); also elsewhere on the board
SW_A_5: U2.5 (GPB4); also elsewhere on the board
SW_A_6: U2.6 (GPB5); also elsewhere on the board
SW_A_7: U2.7 (GPB6); also elsewhere on the board
SW_A_8: U2.8 (GPB7); also elsewhere on the board
SW_A_9: U2.21 (GPA0); also elsewhere on the board
SW_A_10: U2.22 (GPA1); also elsewhere on the board
SW_A_11: U2.23 (GPA2); also elsewhere on the board
SW_A_12: U2.24 (GPA3); also elsewhere on the board
SW_A_13: U2.25 (GPA4); also elsewhere on the board
SW_A_14: U2.26 (GPA5); also elsewhere on the board
SW_A_15: U2.27 (GPA6); also elsewhere on the board
SW_A_16: U2.28 (GPA7); also elsewhere on the board
SW_B_1: U3.21 (GPA0); also elsewhere on the board
SW_B_2: U3.22 (GPA1); also elsewhere on the board
SW_B_3: U3.23 (GPA2); also elsewhere on the board
SW_B_4: U3.24 (GPA3); also elsewhere on the board
SW_ENCODER: U3.25 (GPA4); also elsewhere on the board

Notes on the sheet:
I2C address 0x21
I2C address 0x20
