GlobalSequence/iosefka/hardware/iosefka_controlboard/iosefka_controlboard.kicad_pcb

## KiCad design hardware/iosefka_controlboard/iosefka_controlboard.kicad_pcb (continued)

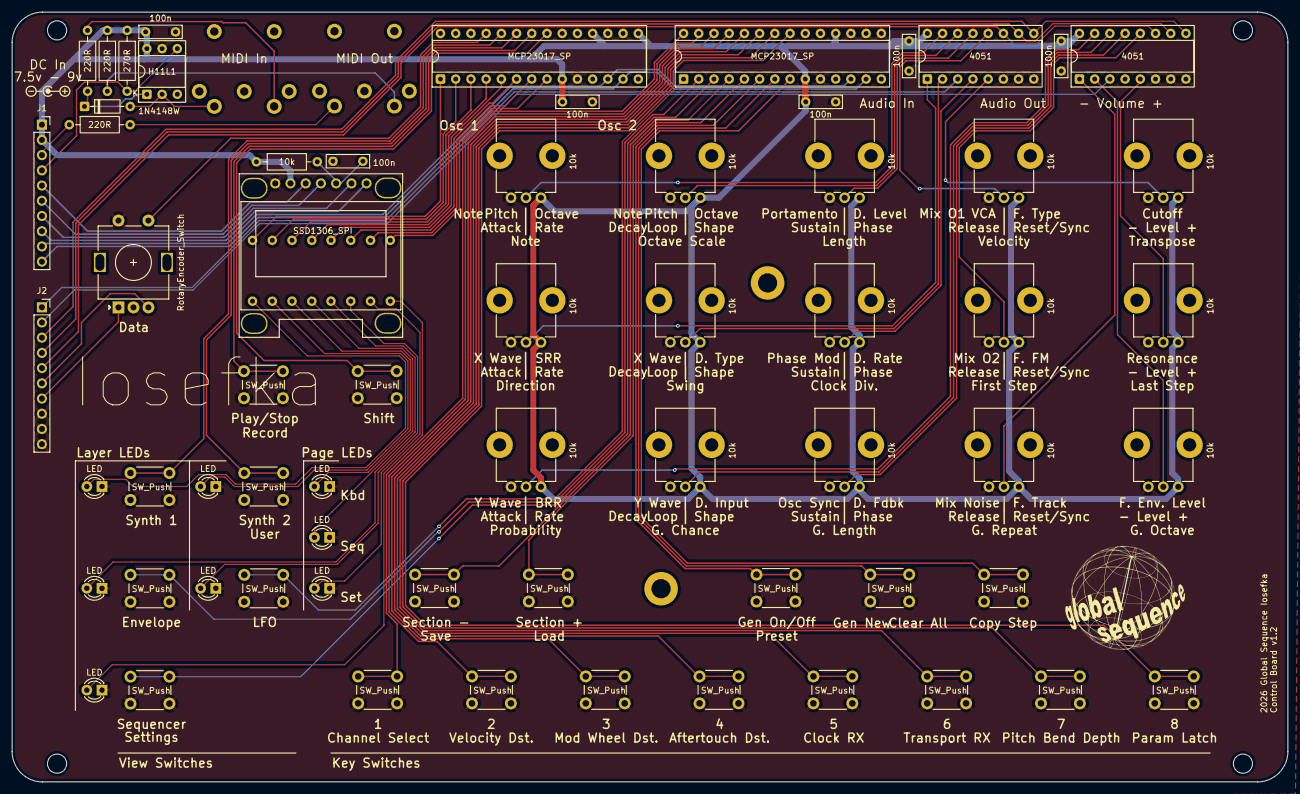
[picture p104: board iosefka_controlboard.kicad_pcb from above]

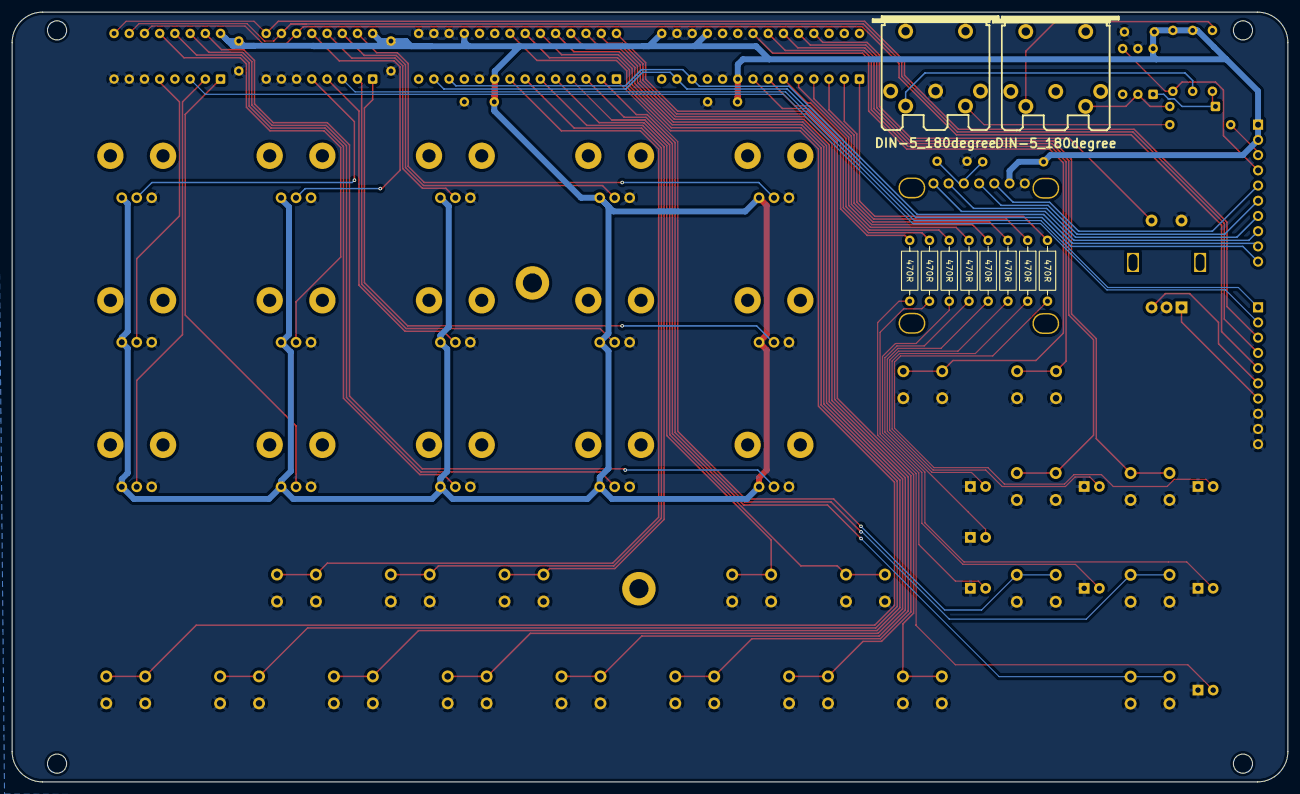
[picture p105: board iosefka_controlboard.kicad_pcb from below]

Board: 2 copper layers, 213.0 x 128.5 mm, 74 parts (10 on the bottom side), 75 nets.
