GlobalSequence/iosefka/controller/settings.cpp

// Copyright (C) 2026 Cory Oleson <globeseq@gmail.com>
//
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
#include "settings.h"
#include <stdio.h>
#include <string.h>
#include "pico/stdlib.h"
#include "../synth/patch.h"
#include "../common/globals.h"
#include "../common/test.h"

synth_state_t synth_state;
preset_name_t loaded_preset_name[NUMBER_OF_PRESETS];

synth_state_t* settingsGetSynthState() {

    return &synth_state;

}

synth_storable_t settingsGetStorableData() {

    synth_storable_t s;

    s.patch = synth_state.patch;
    s.seq_pattern_data = *synth_state.seq.getPatternDataPtr();
    s.step_data = synth_state.new_step;
    s.pattern_gen = synth_state.pattern_gen;
    s.user_param = synth_state.user_param;

    return s;

}

void settingsSetStoredData(synth_storable_t data) {

    synth_state.patch = data.patch;
    synth_state.seq.setPatternData(data.seq_pattern_data);
    synth_state.new_step = data.step_data;
    synth_state.pattern_gen = data.pattern_gen;
    synth_state.user_param = data.user_param;
}

void settingsSetMachineSettingsAll(machine_settings_t settings) {

    synth_state.settings = settings;

}



machine_settings_t settingsGetMachineSettingsAll() {

    return synth_state.settings;

}

external_modulation_t* settingsGetExternalModulation() {

    return &synth_state.ext_mod;

}

void settingsSetClockTickPeriod(uint32_t period) {

    synth_state.ext_mod.clock_tick_period = period;

}

void settingsSetClockTickEvent() {

    synth_state.ext_mod.clock_tick_occurred = true;

}

void settingsSetStartEvent() {

    synth_state.ext_mod.start_occurred = true;

}

void settingsSetInitPatch() {

    settingsSetStoredData(settingsGetInitPatch());

}

void settingsSetInitMachineSettings() {

    settingsSetMachineSettingsAll(settingsGetInitMachineSettings());

}

synth_storable_t settingsGetInitPatch() {

    synth_parameters_t p;

    pattern_data_t pd;

    step_data_t sd;

    pattern_gen_t pg;

    synth_storable_t st;

    // machine_settings_t ms;

    p.osc[0].scale              = 0x80;
    p.osc[0].octave             = 0x80;
    p.osc[0].x_morph            = 0x00;
    p.osc[0].y_morph            = 0x00;

    p.osc[1].scale              = 0x80;
    p.osc[1].octave             = 0x80;
    p.osc[1].x_morph            = 0x00;
    p.osc[1].y_morph            = 0x00;

    p.shared.phase_mod          = 0x00;
    p.shared.portamento         = 0x00;
    p.shared.sync               = 0x00;
    p.shared.bitrate_reduce     = 0xFF;
    p.shared.samplerate_reduce  = 0xFF;
    p.shared.legato             = 0xFF;
    p.shared.osc_duo            = 0x00;

    p.mixer.osc_1_mix           = 0xFF;
    p.mixer.osc_2_mix           = 0x00;
    p.mixer.noise_mix           = 0x00;

    p.filter.cutoff             = 0xFF;
    p.filter.resonance          = 0x00;
    p.filter.env_amt            = 0x80;
    p.filter.type               = 0x40;
    p.filter.fm                 = 0x00;
    p.filter.tracking           = 0xFF;

    p.vca.level                 = 0x00;
    p.vca.velocity_on           = 0x01;
    
    p.delay.amount              = 0x00;
    p.delay.rate                = 0x80;
    p.delay.type                = 0x00;
    p.delay.feedback            = 0x00;
    p.delay.input               = 0xFF;

    p.env[0].attack             = 0x00;
    p.env[0].decay              = 0x80;
    p.env[0].sustain            = 0x80;
    p.env[0].release            = 0x80;
    p.env[0].loop               = 0x00;

    p.env[1].attack             = 0x00;
    p.env[1].decay              = 0x40;
    p.env[1].sustain            = 0x00;
    p.env[1].release            = 0x40;
    p.env[1].loop               = 0x00;

    p.env[2].attack             = 0x00;
    p.env[2].decay              = 0x00;
    p.env[2].sustain            = 0xFF;
    p.env[2].release            = 0x00;
    p.env[2].loop               = 0x00;

    p.lfo[0].rate               = 0x40;
    p.lfo[0].shape              = 0x00;
    p.lfo[0].sync               = 0x00;
    p.lfo[0].phase              = 0x00;

    p.lfo[1].rate               = 0x80;
    p.lfo[1].shape              = 0x00;
    p.lfo[1].sync               = 0x00;
    p.lfo[1].phase              = 0x00;

    p.lfo[2].rate               = 0xC0;
    p.lfo[2].shape              = 0x00;
    p.lfo[2].sync               = 0x00;
    p.lfo[2].phase              = 0x00;
    
    // env 1
    p.mod[0].destination        = MOD_DST_OSC_BOTH_X_MORPH; 
    p.mod[0].amount             = 0x80;

    // env 2
    p.mod[1].destination        = MOD_DST_OSC_BOTH_PITCH; 
    p.mod[1].amount             = 0x80;

    // env 3
    p.mod[2].destination        = MOD_DST_PHASE_MOD; 
    p.mod[2].amount             = 0x80;

    // lfo 1
    p.mod[3].destination        = MOD_DST_OSC_BOTH_Y_MORPH; 
    p.mod[3].amount             = 0x80;

    // lfo 2
    p.mod[4].destination        = MOD_DST_FILTER_CUTOFF; 
    p.mod[4].amount             = 0x80;

    // lfo 3
    p.mod[5].destination        = MOD_DST_OSC_BOTH_PITCH_FINE; 
    p.mod[5].amount             = 0x80;

    // velocity
    p.mod[6].destination        = 0x00; 
    p.mod[6].amount             = 0x80;

    // mod wheel
    p.mod[7].destination        = MOD_DST_LFO_3_AMOUNT; 
    p.mod[7].amount             = 0x80;

    // aftertouch
    p.mod[8].destination        = 0x00; 
    p.mod[8].amount             = 0x80;

    // note
    p.mod[9].destination        = 0x00; 
    p.mod[9].amount             = 0x80;

    // breath control
    p.mod[10].destination       = 0x00; 
    p.mod[10].amount            = 0x80;

    // step data;

    sd.note                 = 0x24;
    sd.length               = 0x00;
    sd.velocity             = 0xFF;
    sd.p_lock_param         = 0x00;
    sd.p_lock_value         = 0x00;
    sd.step_prob            = 0x00;

    // pattern data

    pd.bpm                  = 0x78; // 120 bpm
    pd.clock_div            = 0x04; // NUMBER_OF_CLOCK_DIVS - 1
    pd.direction            = 0x00; // forward
    pd.first_step           = 0x00; 
    pd.last_step            = 0x07;
    pd.probability          = 0xFF;
    pd.swing_amt            = 0x00;
    pd.transpose            = 0x0C; // 0 transposition

    // pattern generator

    pg.chance               = pd.probability;
    pg.base_note            = sd.note;
    pg.scale                = 0x00;
    pg.density              = 0x00;
    pg.repeat               = 0x01;
    pg.octave_range         = 0x01;
    pg.countdown            = 0x00;
    pg.on                   = false;

    // prepare storable data

    for(int i = 0; i < PRESET_NAME_LENGTH; i++) {
        st.preset_name.name_char[i] = 0;
    }

    st.patch                = p;
    st.seq_pattern_data     = pd;
    st.step_data            = sd;
    st.pattern_gen          = pg;

    for(int i = 0; i < NUMBER_OF_POTENTIOMETERS; i++) {
        if(i == 11) {
            st.user_param.destination[i] = MOD_DST_DELAY_TYPE;
        } else if (i == 12) {
            st.user_param.destination[i] = MOD_DST_DELAY_INPUT;
        } else if(i == 13) {
            st.user_param.destination[i] = MOD_DST_BITRATE_REDUCE;
        } else if (i == 14) {
            st.user_param.destination[i] = MOD_DST_SAMPLERATE_REDUCE;
        } else {
            st.user_param.destination[i] = MOD_DST_NONE;
        }

    }

    return st;

}

machine_settings_t settingsGetInitMachineSettings() {

    machine_settings_t ms;

    // machine settings

    ms.channel              = 0x0B;
    ms.pitch_bend_depth     = 0x01;
    ms.clock_rx             = true;
    ms.transport_rx         = true;
    ms.program_change_rx    = true;
    ms.out_thru             = false;
    ms.latch                = false;
    ms.record_click         = false;
    return ms;

}

void settingsSetLoadedPresetNameByIndex(preset_name_t name, uint8_t index) {

    for(int i = 0; i < PRESET_NAME_LENGTH; i++) {

        loaded_preset_name[index].name_char[i] = name.name_char[i];

    }
    uint8_t* ptr = (uint8_t*) name.name_char;

}

void settingsSetBlankLoadedPresetNameByIndex(uint8_t index) {

        preset_name_t p;

    for(int i = 0; i < PRESET_NAME_LENGTH; i++) { 
        
        p.name_char[i] = 0; 
    
    }

    settingsSetLoadedPresetNameByIndex(p, index);

}

void settingsSetPresetNameChar(char c, uint8_t index, uint8_t preset) {

    loaded_preset_name[preset].name_char[index] = c;

}

preset_name_t settingsGetLoadedPresetNameByIndex(uint8_t index) {

    return loaded_preset_name[index];

}

bool* settingsGetRecordClick() {

    return &synth_state.settings.record_click;

}
