GlobalSequence/iosefka/sequencer/metronome.h

// Copyright (C) 2026 Cory Oleson <globeseq@gmail.com>
//
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
#ifndef METRONOME_H
#define METRONOME_H

#include <stdio.h>
#include "pico/stdlib.h"

#define CLICK_HI_INTERVAL 16
#define CLICK_LO_INTERVAL 4

typedef struct metro_struct {

    int16_t (*stepNumberFunction)();

} metro_struct;

// typedef int16_t (*metroStepNumberFunc)(void);
typedef enum click_enum{
    CLICK_NONE,
    CLICK_LO,
    CLICK_HI
} click_enum;

template<uint audio_size>
class Metronome {

    public:
        Metronome(uint16_t* audio_buf, metro_struct m_s) { 
            audio_buf_ = audio_buf;
            m_s_ = m_s;
            // stepNumberFunc_ = func; 
            // last_step_ = stepNumberFunc_();
            last_step_ = m_s_.stepNumberFunction();
            size_lo_ = sizeof(click_wave_lo);
            size_hi_ = sizeof(click_wave_hi);
            
        }

        void renderClick() {

            this->listenForNextClick();
            this->generateClick();   

        }

    private:
        uint16_t* audio_buf_;
        metro_struct m_s_;
        // metroStepNumberFunc stepNumberFunc_;
        int16_t last_step_;
        size_t size_lo_, size_hi_;
        click_enum current_click_ = CLICK_NONE;
        uint16_t samples_left_ = 0;
        uint16_t sample_count_ = 0;
        const uint16_t* click_buf_ptr = NULL;

        void listenForNextClick() {

            // int16_t current_step = stepNumberFunc_();
            int16_t current_step = m_s_.stepNumberFunction();

            if(current_step != last_step_) {

                last_step_ = current_step;

                if(current_step % CLICK_LO_INTERVAL == 0) {

                    if(current_step % CLICK_HI_INTERVAL == 0) {

                        current_click_ = CLICK_HI;
                        samples_left_ = size_hi_;
                        click_buf_ptr = click_wave_hi;

                    } else {

                        current_click_ = CLICK_LO;
                        samples_left_ = size_lo_;
                        click_buf_ptr = click_wave_lo;

                    }

                } else {

                    current_click_ = CLICK_NONE;
                    samples_left_ = 0;
                    return;

                }

            }

        }

        void generateClick() {

            for(int i = 0; i < audio_size; i++) {

                if(samples_left_) {

                    audio_buf_[i] = click_buf_ptr[sample_count_] >> 4; 
                    sample_count_++;
                    samples_left_--;

                } else {

                    audio_buf_[i] = 0;
                    sample_count_ = 0;

                }

            }

        }

        const uint16_t click_wave_hi[645] = {
            32768, 32895, 31883, 31649, 32999, 33762, 33663, 31941, 
            31518, 32842, 33243, 34333, 34637, 33726, 31088, 29507, 
            31948, 33095, 33725, 34960, 35534, 34707, 30005, 25104, 
            24869, 29944, 36166, 40103, 43871, 44093, 36914, 30263, 
            28519, 26745, 25044, 25434, 26860, 30160, 31419, 27279, 
            26481, 31788, 34509, 36609, 46344, 53284, 48863, 43000, 
            39159, 33078, 26386, 23883, 22357, 22597, 23729, 19634, 
            17142, 19700, 23306, 27070, 36507, 45804, 48374, 51110, 
            50409, 46018, 45171, 46683, 42988, 36302, 31671, 25215, 
            16164, 8805, 7365, 9581, 14012, 20140, 27288, 35291, 
            40614, 43413, 49314, 55692, 56486, 54861, 52284, 48420, 
            41071, 32031, 24269, 17457, 11696, 7388, 7113, 9135, 
            12658, 18561, 28965, 38415, 43670, 48371, 51477, 53999, 
            53951, 53229, 53133, 49566, 40431, 30185, 22264, 14942, 
            9650, 8072, 10841, 13949, 17311, 21898, 26867, 33339, 
            40911, 47215, 51990, 57524, 58502, 53842, 48116, 42412, 
            36236, 30390, 25057, 19258, 14705, 11490, 9021, 9767, 
            15158, 21915, 28923, 36259, 43771, 48852, 50763, 52553, 
            52753, 51542, 49350, 45868, 39732, 31571, 23679, 17085, 
            12465, 10157, 10989, 12885, 16826, 22551, 28654, 35656, 
            42262, 46708, 50007, 53871, 54748, 52377, 49111, 44701, 
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
            55794, 54798, 53091, 50607, 47393, 43570, 39276, 34688, 
            30020, 25551, 21530, 18109, 15261, 12833, 10718, 9029, 
            7988, 7739, 8227, 9257, 10649, 12371, 14444, 16798, 
            19408, 22420, 26001, 30055, 34321, 38568, 42663, 46460, 
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
        };


};

#endif
