GlobalSequence/iosefka/synth/lfo.h

// Copyright (C) 2026 Cory Oleson <globeseq@gmail.com>
//
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
#ifndef LFO_H
#define LFO_H

#include <stdio.h>
#include "pico/stdlib.h"
#include "math.h"
#include "../common/utilities.h"

// #define USING_ATMEGA328P

const uint16_t lfo_sine[] /* PROGMEM */ = {
	0x800,0x803,0x806,0x809,0x80c,0x80f,0x812,0x815,0x819,0x81c,0x81f,0x822,0x825,0x828,0x82b,0x82f,
0x832,0x835,0x838,0x83b,0x83e,0x841,0x845,0x848,0x84b,0x84e,0x851,0x854,0x857,0x85b,0x85e,0x861,
0x864,0x867,0x86a,0x86d,0x871,0x874,0x877,0x87a,0x87d,0x880,0x883,0x886,0x88a,0x88d,0x890,0x893,
0x896,0x899,0x89c,0x8a0,0x8a3,0x8a6,0x8a9,0x8ac,0x8af,0x8b2,0x8b5,0x8b9,0x8bc,0x8bf,0x8c2,0x8c5,
0x8c8,0x8cb,0x8ce,0x8d2,0x8d5,0x8d8,0x8db,0x8de,0x8e1,0x8e4,0x8e7,0x8eb,0x8ee,0x8f1,0x8f4,0x8f7,
0x8fa,0x8fd,0x900,0x903,0x907,0x90a,0x90d,0x910,0x913,0x916,0x919,0x91c,0x91f,0x923,0x926,0x929,
0x92c,0x92f,0x932,0x935,0x938,0x93b,0x93f,0x942,0x945,0x948,0x94b,0x94e,0x951,0x954,0x957,0x95a,
0x95e,0x961,0x964,0x967,0x96a,0x96d,0x970,0x973,0x976,0x979,0x97c,0x980,0x983,0x986,0x989,0x98c,
0x98f,0x992,0x995,0x998,0x99b,0x99e,0x9a1,0x9a4,0x9a8,0x9ab,0x9ae,0x9b1,0x9b4,0x9b7,0x9ba,0x9bd,
0x9c0,0x9c3,0x9c6,0x9c9,0x9cc,0x9cf,0x9d2,0x9d6,0x9d9,0x9dc,0x9df,0x9e2,0x9e5,0x9e8,0x9eb,0x9ee,
0x9f1,0x9f4,0x9f7,0x9fa,0x9fd,0xa00,0xa03,0xa06,0xa09,0xa0c,0xa0f,0xa12,0xa15,0xa19,0xa1c,0xa1f,
0xa22,0xa25,0xa28,0xa2b,0xa2e,0xa31,0xa34,0xa37,0xa3a,0xa3d,0xa40,0xa43,0xa46,0xa49,0xa4c,0xa4f,
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

  l->phase_increment_ = freq;
  l->wave_ = wave;
  l->phase_shift_ = phase_shift;
  l->augment_ = augment;
  l->bias_ = (bias << 3);
}

inline void LFOResetRandomSeed(lfo_t *l, uint16_t seed) {

    l->seed_ = seed;

}

static uint16_t foldWave(uint16_t sample, uint8_t amt) {

  int32_t sample_32s;
  int32_t v;
  sample_32s = sample;
  sample_32s -= HALF_MAX_LFO_LEVEL;
  sample_32s = (sample_32s + (sample_32s * (amt) >> 7)); //double the wave level. fixed point fractional.
  if(sample_32s >= HALF_MAX_LFO_LEVEL) {
    v = sample_32s - HALF_MAX_LFO_LEVEL;
    sample_32s = HALF_MAX_LFO_LEVEL - v;
  } else if (sample_32s <= (-HALF_MAX_LFO_LEVEL)) {
    v = (-HALF_MAX_LFO_LEVEL) - sample_32s ;
    sample_32s = (-HALF_MAX_LFO_LEVEL) + v;
  }
  sample_32s += HALF_MAX_LFO_LEVEL;
  if(sample_32s >= MAX_LFO_LEVEL) sample_32s = MAX_LFO_LEVEL;
  return sample_32s;
}

static uint16_t augmentSaw(Saw_Params* s, uint16_t sample, uint8_t amt) {

  return sample <= amt << 4 ? sample : BIT_CEILING - sample;

}

static uint16_t augmentSine(uint16_t sample, uint16_t amt) {

 uint16_t phase_mod = sample + (amt << 4);
  if(phase_mod > MAX_LFO_LEVEL) {
    phase_mod -= MAX_LFO_LEVEL;
  }
  return phase_mod;
}

static uint16_t augmentSampleHold(Sample_Hold_Params* sh, uint16_t sample, uint8_t amt) {

  static uint16_t current_val = 0;
  uint8_t inv_amt = ~amt;
  float step_size = inv_amt / 255.0f;
  int16_t difference = sample - current_val;
  current_val += (int16_t)(difference * step_size);
  return current_val;
}

static uint16_t LFORender(lfo_t* l) {

  l->phase_ += l->phase_increment_;
  uint16_t phase_out_ = l->phase_ + (l->phase_shift_ << 8);
  l->step_ = phase_out_ >> 8;
  l->phase_12b_ = phase_out_ >> 4;

  uint16_t sample;

  switch (l->wave_)
  {
  case LFO_TRIANGLE:
      l->step_ >= PHASE180 ? sample = (int16_t)(l->phase_12b_ - 4096) * (-2) : sample = l->phase_12b_ * 2;
      if (sample >= MAX_LFO_LEVEL) sample = MAX_LFO_LEVEL;
      sample = foldWave(sample, l->augment_);
      break;

  case LFO_SAW:
      sample = augmentSaw(&l->s, l->phase_12b_, l->augment_);
      break;

  case LFO_SQUARE:
      l->step_ >= (uint8_t)(l->augment_ - 128) ? sample = 0 : sample = MAX_LFO_LEVEL;
      break;

  case LFO_SINE:
      sample = 
#ifndef USING_ATMEGA328P
      sample = foldWave(lfo_sine[l->phase_12b_], l->augment_);
#else
      pgm_read_word(&lfo_sine[augmentSine(l->phase_12b_, l->augment_)]);
#endif
      break;

  case LFO_SAMPLE_HOLD:
      
      if (l->previous_phase_ > l->phase_)
      {
          XOR798(&l->seed_);
          sample = l->seed_ >> 4;
          l->hold_sample_ = sample;
      }
      else
      {
          sample = l->hold_sample_;
      }
      sample = augmentSampleHold(&l->sh, sample, l->augment_);
      break;
  }
  l->previous_phase_ = l->phase_;
  uint16_t output = sample + l->bias_;
  output = output >= MAX_LFO_LEVEL? MAX_LFO_LEVEL : output;
  return output;
}

inline void LFOReset(lfo_t* l) {
    if(l->reset_) {
        l->phase_ = 0; 
        l->sh_last_step_bool_ = !l->sh_this_step_bool_;
    }
}

inline void LFOResetNow(lfo_t* l) {
  l->phase_ = 0;
  l->sh_last_step_bool_ = !l->sh_this_step_bool_;
}

inline void LFOSetReset(lfo_t* l, bool reset) {l->reset_ = reset;}
inline void LFOSetSync(lfo_t* l, bool sync) {l->sync_ = sync;}

inline bool LFOGetReset(lfo_t* l) {return l->reset_;}
inline bool LFOGetSync(lfo_t* l) {return l->sync_;}

inline uint16_t printPhase_12b(lfo_t* l){return l->phase_12b_;}

#endif
