GlobalSequence/iosefka/synth/synth.cpp

// Copyright (C) 2026 Cory Oleson <globeseq@gmail.com>
//
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
#include "synth.h"
#include <stdio.h>
#include <new>
#include "pico/stdlib.h"
// #include "voice.h"

#include "mod_matrix.h"
#include "voice.h"
#include "delay.h"
#include "cv.h"

#include "../devices/audio.h"
#include "../devices/pwm.h"
#include "../devices/gpio.h"
#include "../controller/note_queue.h"
#include "../common/globals.h"
#include "../common/test.h"

#include "../graphics/oscilloscope.h"
#include "../sequencer/metronome.h"

// ################################
// STATIC DECLARATIONS
// ################################

volatile bool *render_trig;

alignas(ModMatrix) static uint8_t modmatrix_object_buffer[sizeof(ModMatrix)];
ModMatrix *modmatrix = nullptr;

alignas(Voice) static uint8_t voice_object_buffer[sizeof(Voice)];
Voice *voice = nullptr;

alignas(Delay<DELAY_BUF_SIZE>) static uint8_t delay_object_buffer[sizeof(Delay<DELAY_BUF_SIZE>)];
Delay<DELAY_BUF_SIZE> *delay = nullptr;

alignas(Cv) static uint8_t cv_object_buffer[sizeof(Cv)];
Cv *cv = nullptr;

alignas(Metronome<AUDIO_BLOCK_SIZE>) static uint8_t metro_object_buffer[sizeof(Metronome<AUDIO_BLOCK_SIZE>)];
Metronome<AUDIO_BLOCK_SIZE> *metronome = nullptr;

// ################################
// PRIVATE FUNCTION DECLARATIONS
// ################################

void retrieveSynthNotes();

typedef bool (*stepRecordFlagFunction)();
stepRecordFlagFunction stepRecordFlagFunc;

// ################################
// PUBLIC FUNCTION DEFINITIONS
// ################################

void synthSetup(synth_parameters_t *patch, external_modulation_t *ext_mod, uint16_t random_seed, metro_data_t metro) {

    uint16_t *buf_ptr_1 = audioGetBlockPointer1(); 
    uint16_t *buf_ptr_2 = audioGetBlockPointer2(); 
    uint16_t *adc_buf_ptr = audioGetAdcBufferPointer();
    volatile bool *render_trigger = audioGetRenderTrigger();

    uint16_t *cutoff_ptr = pwmGetCutoffPointer();
    uint16_t *resonance_ptr = pwmGetResonancePointer();
    uint16_t *vca_1_ptr = pwmGetVca1Pointer();
    uint16_t *vca_2_ptr = pwmGetVca2Pointer();
    uint8_t *filter_type_ptr = gpioGetStateValPointer();

    voice = new (voice_object_buffer) Voice(buf_ptr_1, random_seed);

    delay = new (delay_object_buffer) Delay<DELAY_BUF_SIZE>(buf_ptr_2, adc_buf_ptr, AUDIO_BLOCK_SIZE);

    cv = new (cv_object_buffer) Cv(cutoff_ptr, resonance_ptr, vca_1_ptr, vca_2_ptr, filter_type_ptr);

    modmatrix = new (modmatrix_object_buffer) ModMatrix(
        patch,
        ext_mod,
        voice->getParamPointer(),
        delay->getParamPointer(),
        cv->getParamPointer(),
        random_seed

    );

    metro_struct m_s = { metro.getStepNumber };
    metronome = new (metro_object_buffer) Metronome<AUDIO_BLOCK_SIZE>(buf_ptr_2, m_s);

    render_trig = render_trigger;

    stepRecordFlagFunc = metro.getStepRecord;

}

uint32_t last_time;

bool synthUpdate() {

    if(*render_trig) {

        *render_trig = false;

        retrieveSynthNotes();

        modmatrix->process();

        voice->renderOscillators();

        delay->setInputBufferPointer(audioGetAdcBufferPointer());

        if(stepRecordFlagFunc()) {

            metronome->renderClick();

        } else {

            delay->render();

        }

        audioFillOutputBuffer();

        cv->update();

        pwmUpdateLevels();

        gpioSetTwo();

        oscilloscopeProcess(audioGetAdcBufferPointer(), voice->getSyncBuffer());

        return true;

    }

    return false;

}


// ################################
// PRIVATE FUNCTION DEFINITIONS
// ################################

void retrieveSynthNotes() {

    while(noteQueueAvailableInternal()) {

        note_data_t note = noteQueuePullInternal();

        if(note.on) {

            modmatrix->triggerNoteOn(note.note, note.velocity, note.trigger);
            voice->getBassNote(noteQueueGetBassNote());

        } else {

            modmatrix->triggerNoteOff(note.note);

        }

    }

}
