GlobalSequence/iosefka/synth/resources.h

// Copyright (C) 2026 Cory Oleson <globeseq@gmail.com>
//
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
#ifndef RESOURCES_H
#define RESOURCES_H

#include <stdio.h>
#include "pico/stdlib.h"

/*
######################################################################

    Note and Tuning

######################################################################
*/
#define OSC_INCREMENTS_MAX 140
const uint32_t osc_increments[OSC_INCREMENTS_MAX]{
    // 48khz sample rate
    365779, 387529, 410573, 434987, 460852, 488256, 517289, 548049, 
    580638, 615164, 651744, 690498, 731558, 775058, 821146, 869974, 
    921705, 976512, 1034579, 1096098, 1161276, 1230329, 1303488, 1380997, 
    1463116, 1550117, 1642292, 1739948, 1843410, 1953025, 2069158, 2192197, 
    2322552, 2460658, 2606976, 2761995, 2926232, 3100235, 3284584, 3479896, 
    3686821, 3906051, 4138317, 4384394, 4645104, 4921316, 5213953, 5523991, 
    5852464, 6200470, 6569169, 6959792, 7373643, 7812103, 8276635, 8768789, 
    9290208, 9842633, 10427906, 11047982, 11704929, 12400940, 13138339, 13919585, 
    14747287, 15624206, 16553270, 17537578, 18580417, 19685266, 20855813, 22095964, 
    23409859, 24801881, 26276678, 27839171, 29494574, 31248413, 33106540, 35075157, 
    37160835, 39370533, 41711627, 44191929, 46819718, 49603763, 52553357, 55678342, 
    58989149, 62496826, 66213081, 70150315, 74321670, 78741067, 83423254, 88383859,
    93639437, 99207527, 105106714, 111356684, 117978298, 124993652, 132426162, 140300631, 
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
   57723,  57863,  58001,  58136,
   58270,  58402,  58531,  58659,
   58784,  58908,  59029,  59149,
   59267,  59383,  59498,  59610,
   59721,  59830,  59937,  60043,
   60147,  60250,  60351,  60450,
   60548,  60644,  60739,  60832,
   60924,  61014,  61103,  61191,
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
};

#endif
