GlobalSequence/iosefka/(commit log)

2025-11-30 updated settings
    [iosefka_controlboard-B_Cu.gbr, iosefka_controlboard-B_Mask.gbr, iosefka_controlboard-B_Paste.gbr, iosefka_controlboard-B_Silkscreen.gbr, iosefka_controlboard-Edge_Cuts.gbr, iosefka_controlboard-F_Cu.gbr, iosefka_controlboard-F_Mask.gbr, iosefka_controlboard-F_Paste.gbr]
2026-03-20 archiving deprecated oscillator code
    [audio.c, cd4051.c, control_loop.cpp, control_loop.h, delay.h, devices.cpp, display.cpp, display.h]
2026-03-29 deleted and manually restored folder from zip
    [iosefka_bottomboard-NPTH.drl, iosefka_bottomboard-PTH.drl, iosefka_motherboard-NPTH.drl, iosefka_motherboard-PTH.drl]
2026-04-29 parameter adjustments
    [filter_and_vca.kicad_sch, iosefka_bottomboard.kicad_pcb, iosefka_controlboard.kicad_pcb, iosefka_motherboard.kicad_pcb, power_supply.kicad_sch]
2026-04-30 fixed paraphony and oscillator pitch change issues
    [display.cpp, mod_matrix.cpp, mod_matrix.h, note_queue.cpp, oscillator.cpp, step_entry.cpp]
2026-05-10 added docs
    [components_and_display.kicad_sch, ics_and_pin_headers.kicad_sch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]
2026-05-24 fixed encoder driver
2026-06-14 added licenses and readme
    [components_and_display.kicad_sch, filter_and_vca.kicad_sch, ics_and_pin_headers.kicad_sch, iosefka test bom.csv, iosefka_controlboard.kicad_sch, iosefka_controlboard_bom.csv, iosefka_hardware_bom.csv, iosefka_motherboard.kicad_sch]
2026-06-18 added to readme and build guide
    [iosefka_motherboard_bom.csv]
2026-10-05 fixed display and eeprom timer overflow issue
    [display.cpp, eeprom.c]
